Jonasjcmh/Star_nose_sensor/paper_plan.docx

Star-Nose Capacitive Tactile Sensor

A Bio-inspired Multi-Modal Tactile Sensing Array for Robotic Applications

Scientific Article — Figure & Section Plan

Jonathan Tirado — June 2026

# 1. Article Overview

This document maps the full narrative arc of the paper and specifies content, panels, and data requirements for each of the six main figures. The work is structured to tell a coherent story: from the biological inspiration and device fabrication, through electrical and mechanical characterization, to multi-modal perception and real-world demonstrations.

Core narrative thread

• Biological inspiration: the star-nose mole (Condylura cristata) achieves extraordinary tactile acuity through a 22-appendage nose array with ~25,000 mechanoreceptors packed into 0.92 cm².

• Engineering challenge: replicate the array density, compliance, and multi-modal discrimination of this biological system in a flat, manufacturable capacitive skin.

• Solution: a 252-electrode capacitive array (19 active cells used here) covered by interchangeable elastomeric domes, read by a microcontroller and interpreted by ML classifiers/regressors.

• Demonstration: real-time multi-touch, sliding speed, shape class, contact depth, and rotation are detected simultaneously; the sensor adapts to curved surfaces.

# 2. Proposed Title & Abstract Keywords

Working title:

“Star-Nose Inspired Capacitive Tactile Sensor with Multi-Modal Perception and Shape Adaptability”

Target keywords:

• capacitive tactile sensor • bio-inspired • star-nose mole • multi-modal sensing • shape recognition • contact depth estimation • soft robotics • elastic dome • machine learning tactile

# 3. Suggested Paper Structure

Section | Title | Key points
Abstract | ~250 words | Bioinspiration hook, device specs, detection capabilities, demo result
1. Introduction | ~600 words | Star-nose mole biology; gap in tactile sensing; paper contributions (3–4 bullet points)
2. Design & Fabrication | ~400 words + Fig 1 | PCB layout, electrode geometry, dome materials, assembly process
3. Electrical Characterization | ~400 words + Fig 2 | Baseline, sensitivity, SNR, cross-talk, drift, signal chain
4. Mechanical Characterization | ~400 words + Fig 3 | Dome force–displacement curves, stiffness comparison, adaptation
5. Touch & Multi-Touch Detection | ~500 words + Fig 4 | Contact classification, position estimation, multi-touch isolation
6. Multi-Modal Perception | ~600 words + Fig 5 | Speed, shape, depth, rotation — ML architecture & results
7. Adaptability Demo | ~400 words + Fig 6 | Curved-surface mounting, environmental conditions
8. Discussion | ~400 words | Comparison to SOTA, limitations, scaling path
9. Conclusion | ~150 words | Summary and outlook

# 4. Figure Plans

Each figure is described below with: narrative purpose, panel list, bioinspiration connection, data already available in the repository, and what still needs to be collected or generated.

Figure 1: Design and Fabrication of the Sensor
Purpose | Introduce the device physically and connect it to its biological model. This figure anchors the entire paper.

Panels

(a) Photo/illustration of the star-nose mole with a close-up of the Eimer's organs arrangement on one appendage.

(b) Annotated photograph of the full 252-electrode PCB skin, highlighting the 19 active cells in the hexagonal diamond grid (∸38 mm diameter).

(c) Schematic cross-section showing PCB layer stack → elastomeric dome → object contact; indicate electrode pitch (8 mm col, 7 mm row).

(d) Exploded-view diagram of the assembly: PCB, spacer/frame, dome variants (empty, solid, curved), protective cover.

(e) Photograph or render of the sensor mounted on the UR5 TCP, showing the full system (robot arm + F/T sensor + skin).

(f) Table inset: key fabrication parameters (electrode count, active cells, diameter, serial rate, frame rate, robot specs).
Bioinspiration | Direct parallel between the 22 appendages / Eimer's organ arrangement of Condylura cristata and the hexagonal electrode array layout; both prioritize spatial coverage with high density in a compact area.
Data ready | PCB design files present; UR5 integration code complete; hexmap coordinate figure referenced in report (Fig 1 of report).
Still needed | High-resolution photographs of the bare PCB and assembled sensor needed; biological illustration or CC-licensed image of star-nose mole; clean exploded-view render (CAD or Inkscape).

Figure 2: Electrical Characterization of the Capacitive Sensors
Purpose | Quantify sensor performance: sensitivity, noise floor, SNR, cross-talk, drift, and the effect of the signal processing chain.

Panels

(a) Raw capacitance trace for a representative single-press event on one electrode (force vs. capacitance dual-axis, from loadcell_vs_robot.png data).

(b) Baseline distribution across all 19 cells in idle state — histogram showing the ∲32% idle offset problem and after multi-frame calibration fix.

(c) SNR map: heatmap on the hexagonal grid showing per-cell SNR (before and after dead-zone + EMA filtering).

(d) Cross-talk matrix: 19×19 heatmap of Pearson correlation between all cell pairs during single-point presses.

(e) Signal chain block diagram: raw → multi-frame calib → normalise → gamma → spike rejection → dead-zone → EMA; annotate parameters (SENSITIVITY=30, GAMMA=0.5, alpha=0.35).

(f) Frequency spectrum or frame-rate stability plot showing the 16 Hz acquisition rate and spike artefact distribution (1.2% flagged frames).
Bioinspiration | The star-nose mole Eimer's organs are tonotopically organised with graded sensitivity across appendages; analogously, the spatial SNR variation across the electrode array mirrors biological sensitivity gradients.
Data ready | Raw session CSVs available; per-point plots, force.png, analog.png, loadcell_vs_robot.png already generated; noise analysis described in Section 4 of report.
Still needed | Cross-talk matrix computation script; baseline before/after comparison requires implementing multi-frame calibration (new branch recommended per report); EMA filter effect plot.

Figure 3: Mechanical Characterization of Dome Variants
Purpose | Show how the choice of dome geometry/material modulates tactile response, sensitivity, and contact area spreading.

Panels

(a) Photographs of the three dome types: empty dome, solid (filled) dome, curved-surface adapter; include scale bar.

(b) Force–displacement curves for each dome type at the center electrode (point 10) — overlay three curves to show stiffness differences.

(c) Contact area (number of active cells, n_active) vs. indentation depth for each dome: solid dome spreads contact wider.

(d) Hexagonal activation maps at matched force levels (e.g., 0.5 N) for each dome type — 3 side-by-side hexmaps.

(e) Peak capacitance vs. depth regression per dome variant (from per_point.pdf / perpoint.png data).

(f) Spatial deviation map for the empty dome vs. solid dome (deviation_map.png and deviation_map_short_6mm.png already in repo).
Bioinspiration | The star-nose mole modulates sensitivity by controlling how much tissue presses against Eimer's organs; the dome acts as the compliant coupling layer, analogously enabling tunable sensitivity without changing the underlying electronics.
Data ready | deviation_map.png, deviation_map_short_6mm.png, per-session perpoint.png and force.png plots; empty dome and solid dome session logs; curved surface logs (test_curved sessions).
Still needed | Systematic force–displacement curves per dome (requires load cell + robot press at calibrated depths across dome types); material characterization (Shore hardness or Young's modulus) of dome elastomer.

Figure 4: Touch and Multi-Touch Detection
Purpose | Demonstrate the sensor's ability to localise single contacts and resolve simultaneous multi-point touches across the array.

Panels

(a) Single-touch position accuracy: scatter plot of predicted (x,y) vs. ground-truth TCP positions across all 19 canonical points; colour-code by depth.

(b) MAE heatmap on the hexagonal grid — show per-cell localisation error to identify edge/center performance difference.

(c) Time traces of all 19 cells during a sequential 5-point press routine; annotate contact onset/offset.

(d) Multi-touch demonstration: simultaneous activation of 2–3 non-adjacent cells (manually or with dual-probe setup); hexmap sequence.

(e) Confusion matrix for the contact classifier (19 classes, from current RF model) on held-out test set.

(f) Depth estimation performance: predicted depth vs. actual depth (0.5–3.0 mm) — scatter + regression line + MAE annotation (≈0.3–0.5 mm).
Bioinspiration | The star-nose mole can detect and independently process touches on different appendages simultaneously; the multi-touch isolation capability of the array directly mirrors this parallel spatial processing.
Data ready | 28,000 labelled frames from ~28 sessions; trained RF classifiers for contact (19 classes), position, depth; hexmap plots; overview.png; session CSVs with ur5_point labels.
Still needed | Multi-touch ground-truth data (two simultaneous presses at known positions — requires mechanical two-probe fixture or manual protocol); held-out test split performance table.

Figure 5: Multi-Modal Perception: Speed, Shape, Depth, and Rotation
Purpose | This is the centrepiece results figure. Demonstrate that a single sensor simultaneously provides four distinct tactile modalities using ML over the second-order moment feature vector.

Panels

(a) Feature engineering diagram: show how 19 raw cell values + 4 spatial scalars are extended to 30 features via Ixx, Iyy, Ixy, theta, eccentricity, delta_cx, delta_cy.

(b) Sliding speed estimation: sensor output during linear UR5 trajectories at 1, 2, 4 mm/s; plot centroid velocity vs. actual speed with regression line.

(c) Shape classification: confusion matrix for sphere / flat disk / cylinder / edge / ring classification; include representative hexmap for each class.

(d) Depth regression: predicted vs. actual depth (same as Fig 4f but here shown as part of the multi-task ML system); highlight improved accuracy with moment features.

(e) Rotation estimation: polar plot of predicted angle vs. true TCP roll angle (0–157.5° in 8 steps); show cos(2θ)/sin(2θ) decoding approach.

(f) Multi-task output dashboard: a single time window showing all four outputs (speed, shape label, depth, angle) updating simultaneously during a scripted demo trajectory.
Bioinspiration | The star-nose mole processes each appendage's input through a dedicated cortical barrel, enabling simultaneous multi-modal integration; the shared feature vector fed to parallel ML heads directly mirrors this parallel cortical architecture.
Data ready | Depth regression model trained; position regressor trained; moment feature engineering described in Section 2.1 of report; ML roadmap documented.
Still needed | Shape classification dataset (Protocol C: 4 probe geometries × 10 pts × 2 depths × 3 reps = 240 events); rotation dataset (Protocol B: 8 angles × 10 pts × 2 depths × 3 reps = 480 events); sliding trajectory sequences at multiple speeds; multi-task MLP training.

Figure 6: Shape Adaptability and Environmental Detection Demo
Purpose | Close the paper with a compelling demonstration showing the sensor conforming to non-flat surfaces and functioning under varying environmental conditions.

Panels

(a) Photograph montage: sensor mounted flat on UR5 vs. sensor mounted on a curved surface (e.g., cylindrical object or mannequin finger); show that dome deforms to fill the gap.

(b) Tactile maps from curved-surface sessions vs. flat sessions at matched contact forces — hexmap comparison showing maintained spatial resolution.

(c) Position estimation accuracy comparison: flat surface MAE vs. curved surface MAE across 19 points — bar chart showing performance retention.

(d) Environmental robustness: capacitance drift over time and temperature variation; show that periodic re-calibration (every 10 min) restores baseline (from best practices in Section 3.4 of report).

(e) Robot-guided surface exploration sequence: 6-panel strip of hexmaps during a scripted scan across a curved object, with contact position overlaid on a 3D robot path.

(f) Summary table: sensor performance across all four modalities and two surface conditions — final quantitative comparison with relevant literature (2–3 SOTA sensors).
Bioinspiration | The star-nose mole uses its radially symmetric appendage array to rapidly scan surfaces of arbitrary shape; the dome-coupled capacitive skin mimics this by conforming to geometry without recalibration, enabling exploration analogous to the mole's foveation behaviour.
Data ready | test_curved session logs (2 sessions, ~2900 frames); curved-surface hexmap plots; deviation map for 6mm dome.
Still needed | Additional curved-surface sessions at varied curvature radii; temperature-drift characterisation experiment; literature comparison table (GelSight, iCub skin, BioTac, etc.); high-quality photos of mounting on curved objects.

# 5. Data & Experiment Gap Summary

The following experiments are required before submission. Priority order follows the figure sequence.

High priority (Figures 1–4 — fabrication photos + characterisation)

• High-resolution photos of bare PCB, assembled sensor (all dome variants), and UR5 mounting.

• Systematic force–displacement curves per dome type (empty, solid, curved) using load cell + UR5.

• Multi-frame calibration implementation (new branch) + before/after SNR comparison.

• Cross-talk measurement: single-point presses while recording all 19 channels.

• Multi-touch fixture or manual two-probe protocol for simultaneous contact ground truth.

Medium priority (Figure 5 — multi-modal ML)

• Protocol B data collection: rotation presses (8 angles × 10 pts × 2 depths × 3 reps = 480 events).

• Protocol C data collection: shape presses (4 shapes × 10 pts × 2 depths × 3 reps = 240 events).

• Sliding trajectory sessions at 3 speeds (1, 2, 4 mm/s) over 6 linear paths.

• Moment feature engineering in build_dataset.py (Ixx, Iyy, Ixy, theta, eccentricity).

• Train shape classifier (RF 300 trees), rotation regressor (MLP 256→128), and optional multi-task MLP.

Lower priority (Figure 6 — demo & comparison)

• Additional curved-surface sessions at 2–3 curvature radii.

• Temperature drift characterisation (~1 h acquisition with ambient temperature logged).

• Literature review and comparison table (GelSight, BioTac, iCub skin, FingerVision).

# 6. Suggested Target Venues

Venue | Type | Fit
IEEE Sensors Journal | Journal | Sensor characterisation focus; accepts multi-figure hardware papers
Advanced Intelligent Systems (Wiley) | Journal | Bio-inspired robotics + ML — strong fit for this work
IEEE RA-L + IROS/ICRA | Journal + Conference | Robotics community; tactile sensing for manipulation
Soft Robotics (Mary Ann Liebert) | Journal | If dome compliance and adaptability are emphasised
IEEE WorldHaptics / EuroHaptics | Conference | Haptic/tactile sensing community; demo-friendly

End of Plan — Star-Nose Capacitive Sensor Paper

Star-Nose Capacitive Sensor — Paper Plan
