Jonasjcmh/Star_nose_sensor/abstract_draft.docx

Star-Nose Inspired Capacitive Tactile Sensor with Multi-Modal Perception and Shape Adaptability

## Abstract

## Tailored Abstract (Science Robotics style)

Animals achieve rich tactile perception by coupling dense mechanoreception with morphology that transforms contact into informative spatial patterns. The star-nosed mole (Condylura cristata), for example, resolves object features with exceptional speed using tens of thousands of mechanoreceptors distributed across structured appendages. In contrast, most engineered tactile arrays report a single scalar signal per taxel, limiting their ability to infer contact geometry from a single interaction.

Here, we present a bio-inspired capacitive tactile sensor that encodes contact shape and displacement features through structured dome surfaces and spatial signal processing. The device comprises a 5x5 electrode array with 19 active sensing cells arranged in a hexagonal diamond layout, coupled to elastomeric domes that modulate sensitivity and enable conformal deployment on irregular surfaces. To enable space recognition learning, the sensor is integrated with a robotic manipulator that provides precise variations of pose and force during automated data acquisition.

We extract per-contact descriptors by combining cell-wise capacitance readings with second-order spatial moments ( I_(xx) , I_(yy) , I_(xy) ), yielding a compact representation of contact geometry. Across a dataset of more than 28,000 robot-acquired interactions spanning multiple surface and dome configurations, standard learning models decode indentation depth, contact location, object shape, and in-plane rotation from a single sensor array. The system resolves indentation depth at sub-millimetre scale and maintains performance under conformal mounting.

These results demonstrate that augmenting capacitive arrays with conformal structures and data driven decoding enables an enhanced tactile perception without increasing sensor density. This approach provides a compact pathway toward shape adaptable tactile sensing for robotic manipulation and navigation.

## Tailored Introduction (Science Robotics style)

Dexterous manipulation requires robots to infer contact geometry, force distribution, and object properties under conditions where vision is uncertain or occluded [cite]. Among the available tactile sensing technologies, capacitive arrays remain especially attractive because they are compact, sensitive, scalable, and well suited to integration in soft robotic field [cite]. Their simple transduction principle also makes them robust and practical for distributed implementations, supporting high-density tactile acquisition in lightweight formats [cite].

Rather than increasing the sensing burden of each cell, an alternative strategy is to preserve the simplicity of capacitive transduction while enriching the information carried by the resulting signals through mechanical design and computational interpretation. This perspective is consistent with biological tactile systems, where morphology often plays an active role in shaping how contact stimuli are encoded before neural processing [cite]. The star-nosed mole (Condylura cristata), for example, achieves remarkable tactile performance through a highly structured sensory surface that transforms brief contact into informative spatial patterns [cite].

We follow this principle using a capacitive tactile array in which each sensing element is paired with a hollow elastomeric dome. The dome does not introduce an additional electrical sensing channel; instead, it acts as a mechanically intelligent interface that modifies the local contact mechanics before transduction. This design improves conformability on curved or irregular surfaces and helps preserve meaningful local interactions in situations where flat interfaces may lose coupling or allow larger surface features to dominate smaller ones.

In this way, the contribution of the dome is not to make each capacitive cell intrinsically multimodal, but to reshape the contact so that a single scalar measurement becomes more informative. The hollow dome can damp, localize, and redistribute deformation depending on the geometry and dynamics of the interaction, thereby making capacitance changes more sensitive to indentation profile, partial contact, and local surface variation. When these local responses are considered across the array and over time, they form a richer spatiotemporal representation than would be available from the raw scalar values alone.

This system-level view is central to the approach presented here. Although each cell outputs only one capacitive measurement, the combination of dome-mediated mechanics, spatial organization, and temporal signal processing enables the array to support inference of multiple tactile attributes from the same sensing modality. These attributes include not only contact location and indentation depth, but also shape-dependent responses and dynamic features such as shear, frictional interaction, and displacement speed. The goal is therefore not to replace capacitive sensing with a more complex transduction scheme, but to extend what can be extracted from capacitive arrays through morphology-aware design and decoding.

Building on this idea, this work presents a bio-inspired capacitive tactile sensor integrated with dome structures and an automated robotic data-collection framework. By coupling conformable mechanical interfaces with structured feature extraction and machine-learning-based interpretation, the proposed system seeks to expand the functional repertoire of compact capacitive arrays beyond conventional contact detection. More broadly, it explores how mechanically informed sensor design can help bridge the gap between simple tactile transduction and richer robotic touch perception.

## Old version

Dexterous manipulation requires robots to infer contact geometry, force distribution, and object properties under conditions where vision is uncertain or occluded. While tactile sensor arrays have advanced substantially in spatial resolution and sensitivity, most designs remain functionally limited: each taxel reports a single scalar quantity, typically pressure, constraining the information that can be recovered from a single event. As a result, higher-level properties such as object shape, orientation, and motion are often inferred only through sequential exploration or sensor fusion.

Biological tactile systems suggest an alternative design principle. Rather than relying solely on receptor density, they exploit the coupling between morphology and sensing to encode rich information in spatial activation patterns. The star-nosed mole (Condylura cristata) provides a striking example, using an array of mechanosensory appendages densely packed with Eimer’s organs to achieve rapid and precise tactile discrimination (Catania, 2011). Critically, the geometry and նյութ properties of these appendages transform contact interactions into structured signals that can be decoded efficiently by the nervous system. This observation motivates the hypothesis that morphological encoding—paired with appropriate decoding—can increase the functional bandwidth of engineered tactile sensors without requiring denser arrays.

Recent work in robotic touch has begun to explore this direction. Soft interfaces and structured skins can transform contact geometry into distributed signals across an array, enabling inference of shape and force vectors (Dahiya et al., 2010; Lepora and Ward-Cherrier, 2015). Vision-based tactile sensors such as GelSight achieve high-resolution reconstruction of surface geometry, but at the cost of increased complexity, bulk, and power requirements (Yuan et al., 2017). Capacitive sensors, by contrast, offer a compact and scalable alternative but typically lack mechanisms to encode higher-order features within a single संपर्क.

In parallel, machine learning has emerged as a powerful tool for interpreting tactile data, enabling inference of object properties from high-dimensional sensor signals (Calandra et al., 2017). However, progress is often limited by the availability of large, well-annotated datasets. Robotic platforms equipped with precise force and pose sensing provide a means to automate data collection and generate consistent ground truth, reducing reliance on manual labeling and enabling systematic exploration of sensor behavior.

Here, we introduce a bio-inspired capacitive tactile sensing system that integrates three key elements: (i) structured electrode geometry, (ii) interchangeable elastomeric domes that mechanically encode contact, and (iii) automated, robot-assisted data acquisition for scalable learning. By combining spatially distributed capacitance measurements with second-order moment features, the system captures compact descriptors of contact geometry that support multi-modal inference from a single interaction. We demonstrate that this approach enables simultaneous estimation of indentation depth, contact location, object shape, and orientation, while preserving performance under conformal mounting on curved surfaces.

This work advances tactile sensing by showing that morphology-aware encoding can substantially expand the information content of capacitive arrays without increasing sensor density. More broadly, it highlights a pathway toward compact, adaptable tactile systems that bridge principles from biological sensing and robotic manipulation.

Keywords: capacitive tactile sensor, bio-inspired, star-nose mole, multi-modal sensing, shape recognition, contact depth estimation, soft robotics, elastic dome, machine learning tactile
