Jonasjcmh/Star_nose_sensor/Capacitance_measurement/plots2/overview.png

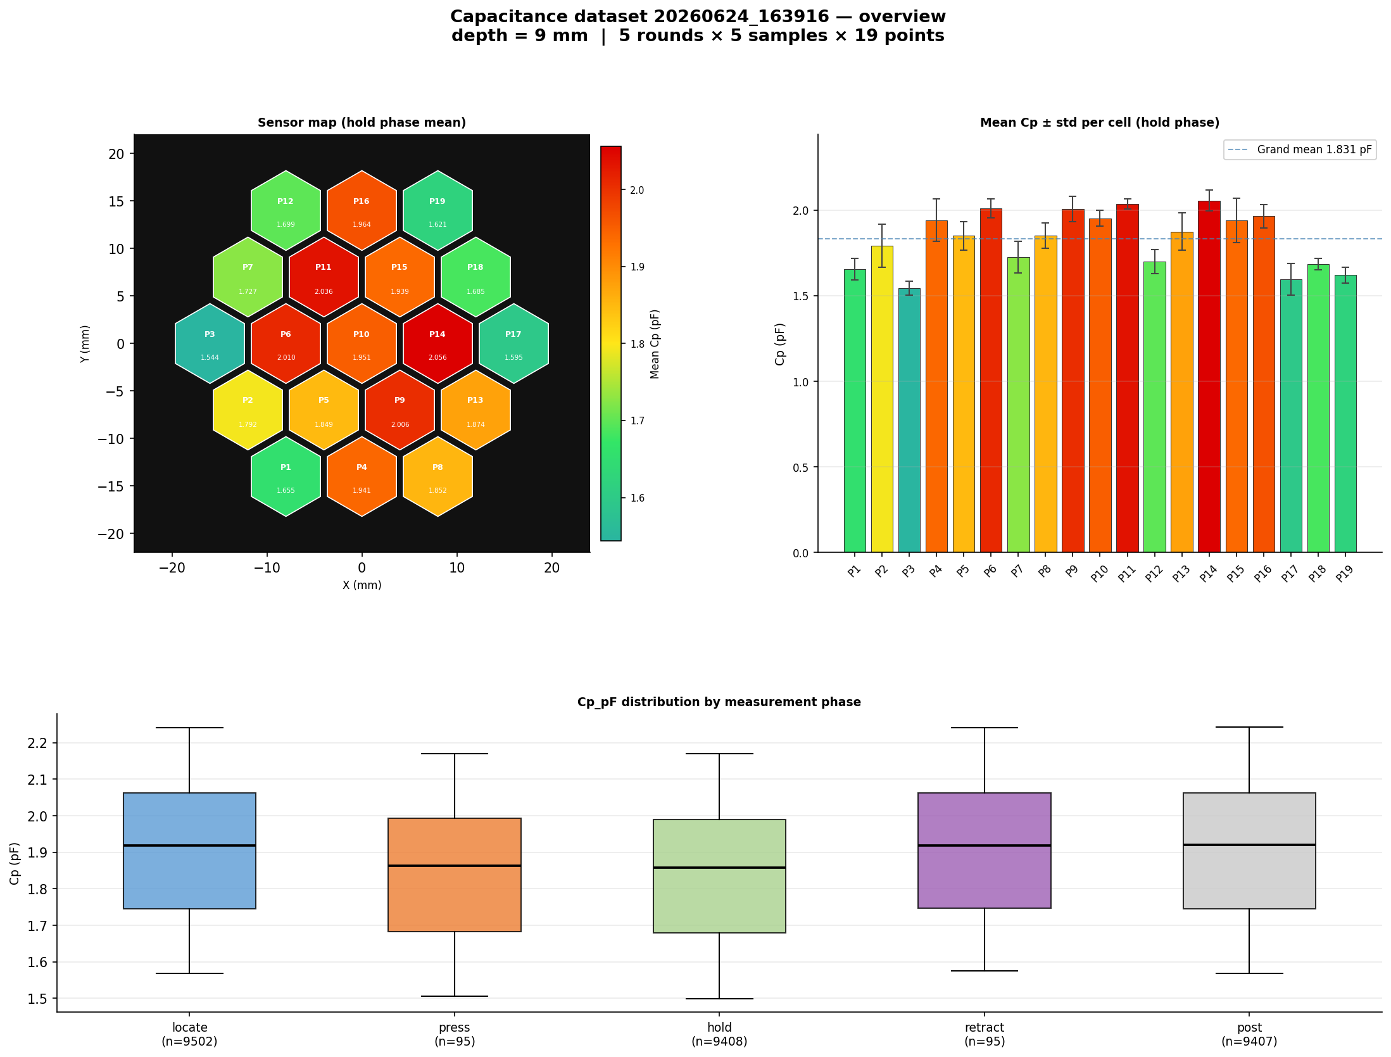
Capacitance_measurement/plots2/overview.png
