Jonasjcmh/Star_nose_sensor/Integration/plots/dome_empty_monday_2_session_20260511_134351/overview.png

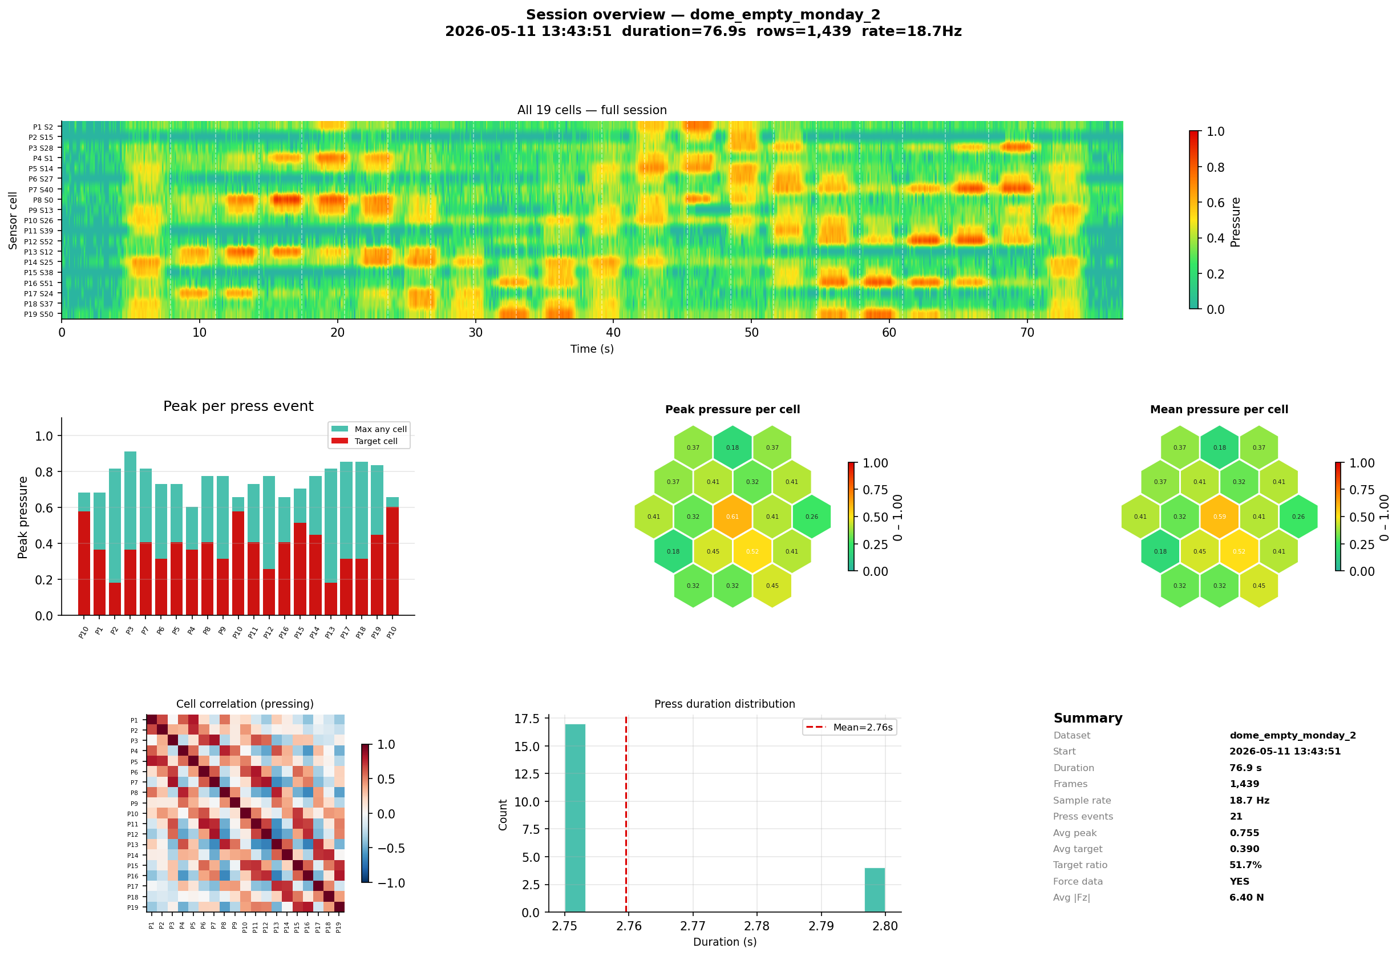
Integration/plots/dome_empty_monday_2_session_20260511_134351/overview.png
