Jonasjcmh/Star_nose_sensor/Capacitance_calibration_Muca_LCR_Futek/results/stepA_vs_stepB_sanity_check.png

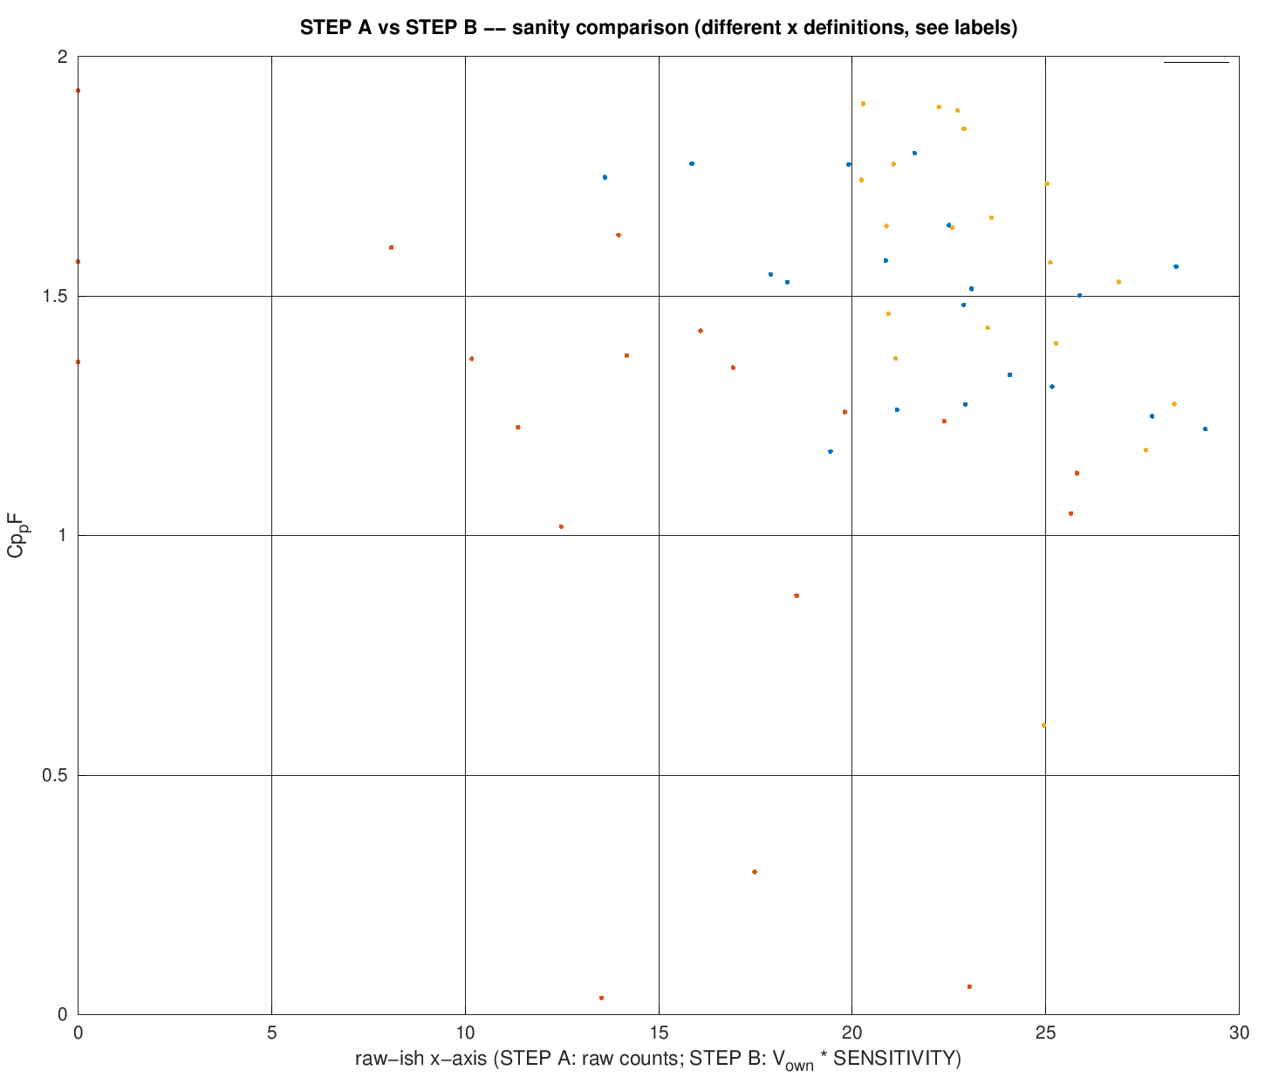
Capacitance_calibration_Muca_LCR_Futek/results/stepA_vs_stepB_sanity_check.png
