Jonasjcmh/Star_nose_sensor/fig1_design_fabrication.png

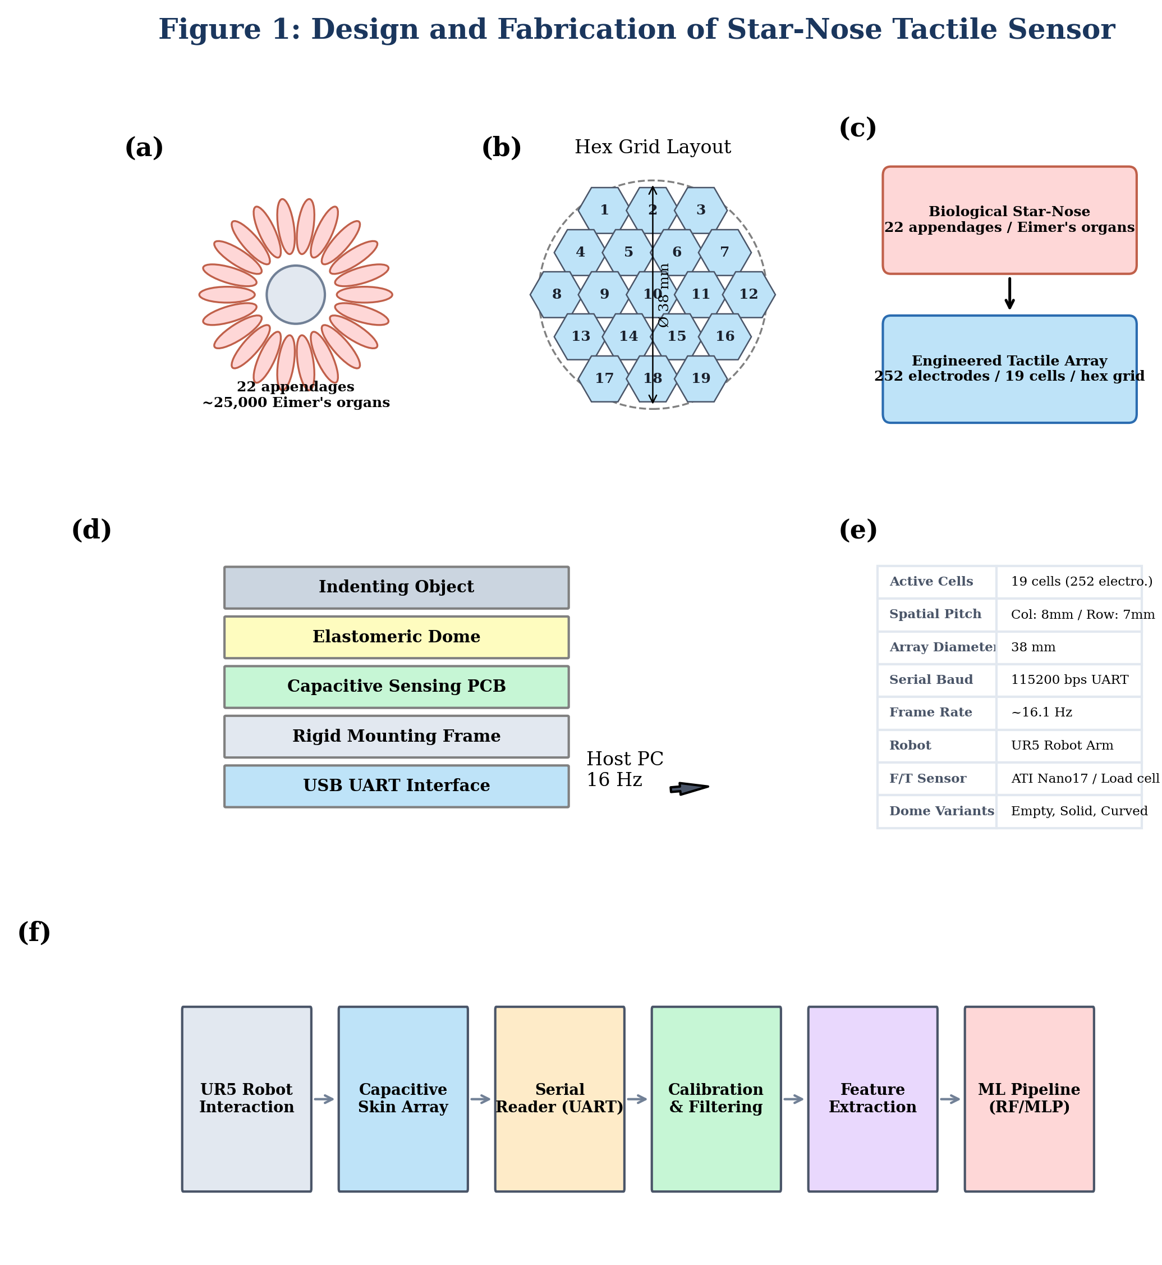
fig1_design_fabrication.png
