Jonasjcmh/Star_nose_sensor/force_sensor_calibration/Matlab calibration/step2_panel_overview.png

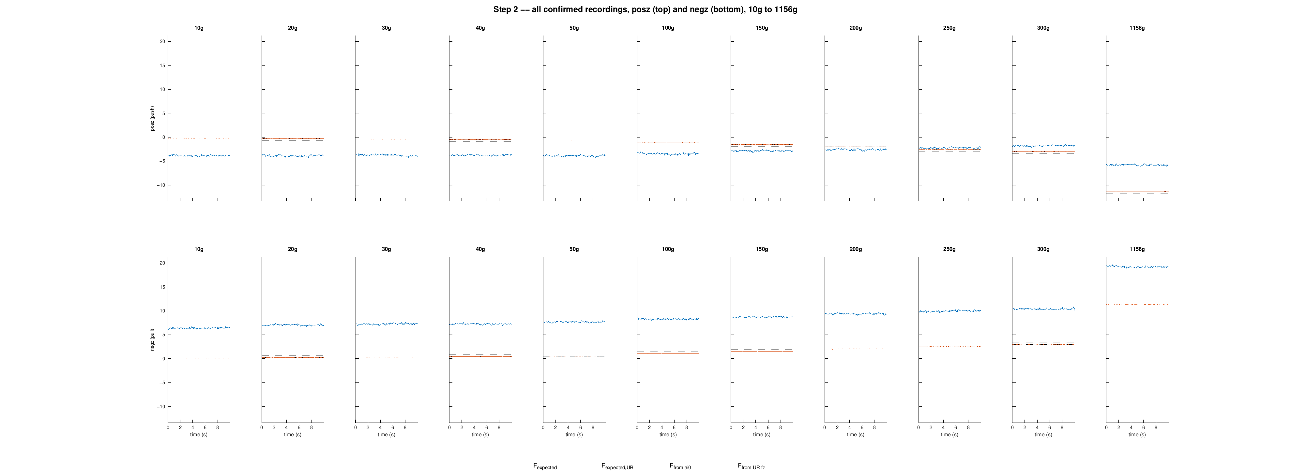
force_sensor_calibration/Matlab calibration/step2_panel_overview.png
