Jonasjcmh/Star_nose_sensor/force_sensor_calibration/Matlab calibration/step2_plots/fzcal_futek_direct_20g_v2_20260715_155952_step2.png

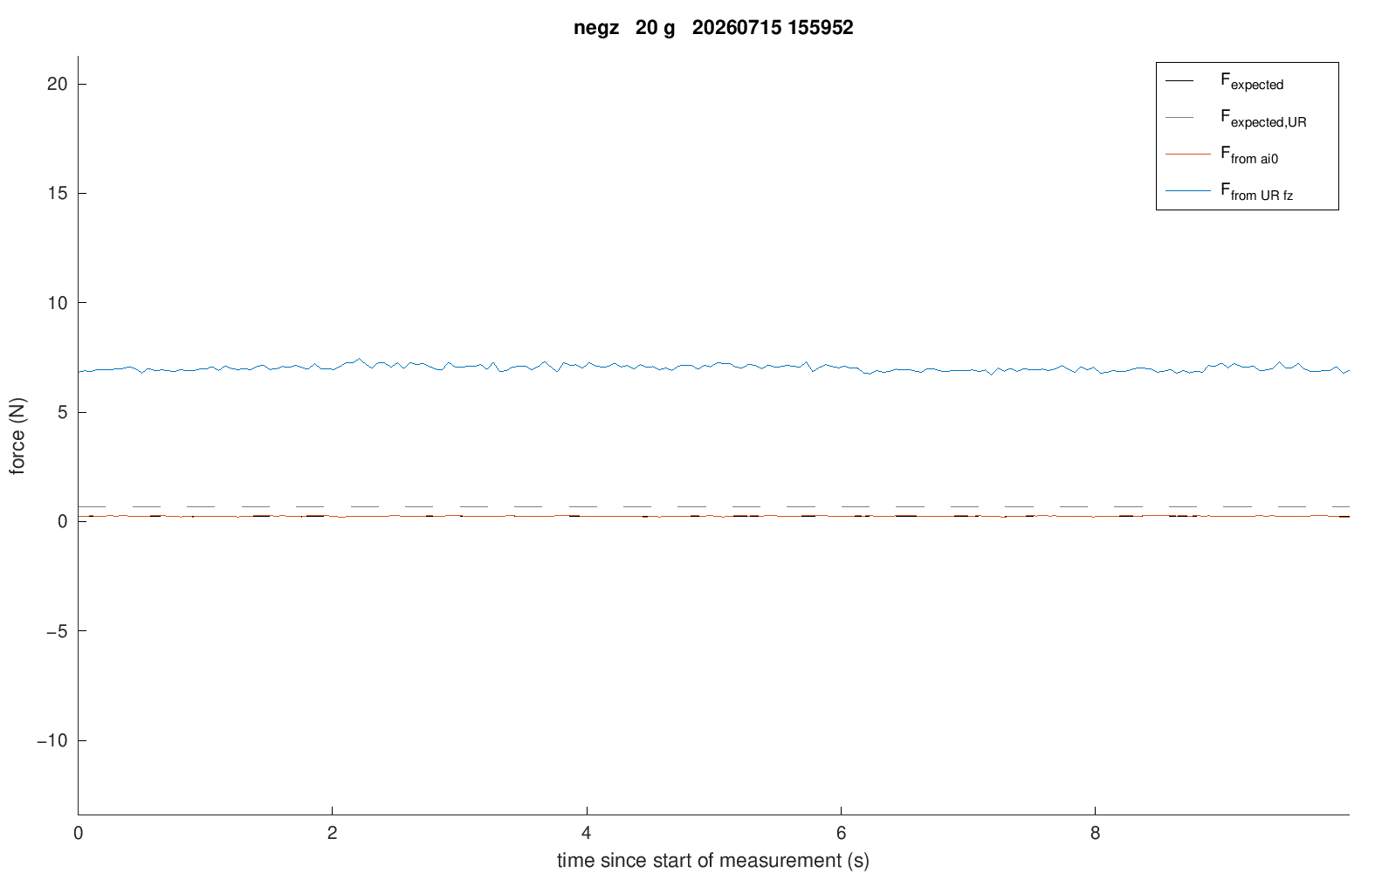
force_sensor_calibration/Matlab calibration/step2_plots/fzcal_futek_direct_20g_v2_20260715_155952_step2.png
