Jonasjcmh/Star_nose_sensor/force_sensor_calibration/Matlab calibration/step2_plots/fzcal_futek_direct_150g_v2_20260715_160752_step2.png

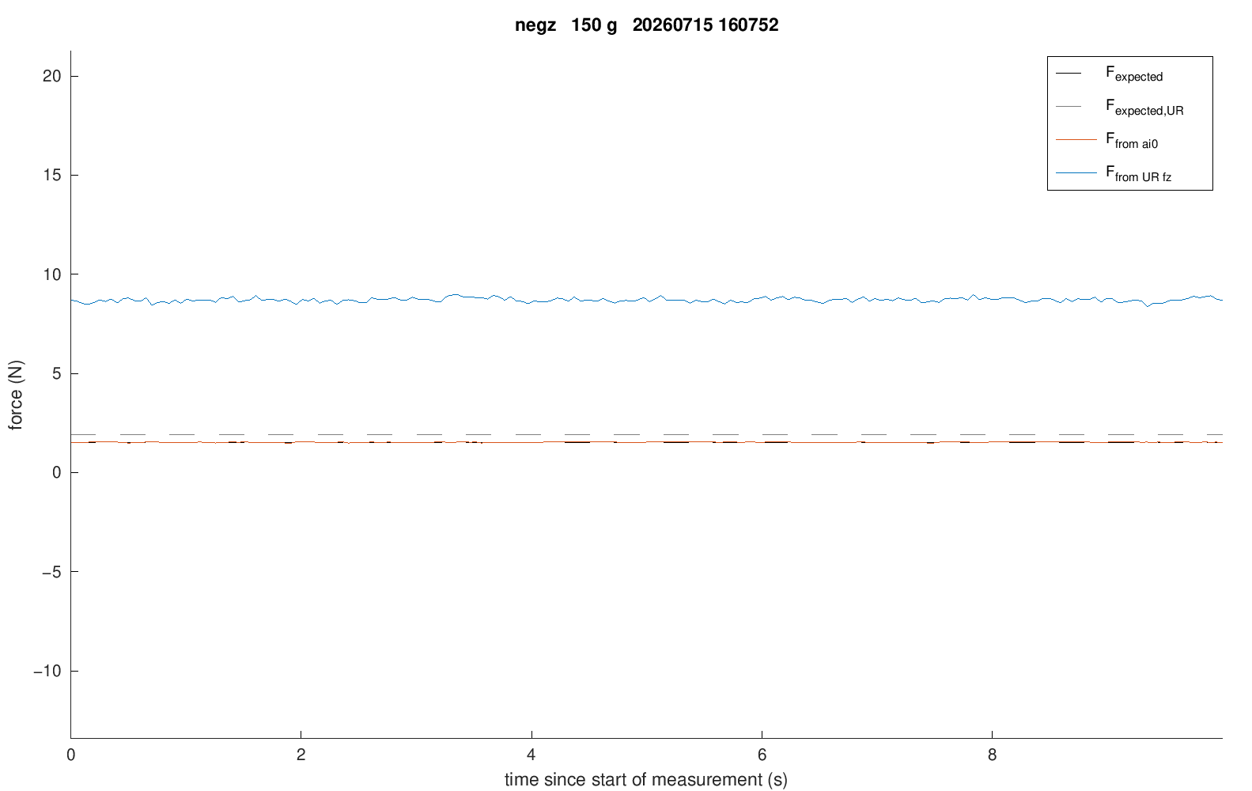
force_sensor_calibration/Matlab calibration/step2_plots/fzcal_futek_direct_150g_v2_20260715_160752_step2.png
