Jonasjcmh/Star_nose_sensor/Capacitance_calibration_Muca_LCR_Futek/results/muca_v_to_cp_table.md

# muca reading <-> real capacitance (Cp, pF), per point, per surface

`Cp_pF = A * V_own + B`, where V_own is the mucaboard's own normalized [0,1] reading for that point (see mucaboard_data/README_capacitance_estimation.md section 1 for how a raw count becomes V_own). Composed from two per-point fits chained through Force (see chained_muca_v_to_cp_via_force.m): mucaboard_data_raw's own press/retract ramp gives Force<->V; Capacitance_measurement's LCR sweep gives Force<->Cp_pF. `R2 (weakest link)` is the MINIMUM of the two chained fits' own R2 -- the honest quality figure for the composed equation, since a chain is only as strong as its weakest link.

## FLAT

| point | code_id | Cp_pF = A*V + B | A (slope) | B (intercept) | R2 (weakest link) |
|---|---|---|---|---|---|
| P01 | 8 | Cp_pF = -0.0922*V + 1.5389 | -0.0922 | 1.5389 | 0.848 |
| P02 | 4 | Cp_pF = -0.2078*V + 1.6486 | -0.2078 | 1.6486 | 0.818 |
| P03 | 1 | Cp_pF = -0.2110*V + 1.3919 | -0.2110 | 1.3919 | 0.837 |
| P04 | 13 | Cp_pF = -0.1611*V + 1.8933 | -0.1611 | 1.8933 | 0.824 |
| P05 | 9 | Cp_pF = -0.2946*V + 1.9353 | -0.2946 | 1.9353 | 0.773 |
| P06 | 5 | Cp_pF = -0.1938*V + 1.7116 | -0.1938 | 1.7116 | 0.847 |
| P07 | 2 | Cp_pF = -0.2335*V + 1.4900 | -0.2335 | 1.4900 | 0.808 |
| P08 | 17 | Cp_pF = -0.1126*V + 1.6382 | -0.1126 | 1.6382 | 0.753 |
| P09 | 14 | Cp_pF = -0.2236*V + 1.8724 | -0.2236 | 1.8724 | 0.681 |
| P10 | 10 | Cp_pF = -0.2887*V + 1.8538 | -0.2887 | 1.8538 | 0.550 |
| P11 | 6 | Cp_pF = -0.2494*V + 1.6671 | -0.2494 | 1.6671 | 0.631 |
| P12 | 3 | Cp_pF = -0.1128*V + 1.3267 | -0.1128 | 1.3267 | 0.777 |
| P13 | 18 | Cp_pF = -0.2440*V + 1.6694 | -0.2440 | 1.6694 | 0.833 |
| P14 | 15 | Cp_pF = -0.2609*V + 1.8084 | -0.2609 | 1.8084 | 0.828 |
| P15 | 11 | Cp_pF = -0.3546*V + 1.7074 | -0.3546 | 1.7074 | 0.675 |
| P16 | 7 | Cp_pF = -0.1409*V + 1.3614 | -0.1409 | 1.3614 | 0.816 |
| P17 | 19 | Cp_pF = -0.1515*V + 1.3642 | -0.1515 | 1.3642 | 0.859 |
| P18 | 16 | Cp_pF = -0.1461*V + 1.4119 | -0.1461 | 1.4119 | 0.849 |
| P19 | 12 | Cp_pF = -0.1282*V + 1.2430 | -0.1282 | 1.2430 | 0.773 |

## SOLID

| point | code_id | Cp_pF = A*V + B | A (slope) | B (intercept) | R2 (weakest link) |
|---|---|---|---|---|---|
| P01 | 8 | Cp_pF = -0.1969*V + 1.2861 | -0.1969 | 1.2861 | 0.352 |
| P02 | 4 | Cp_pF = -0.1556*V + 1.1566 | -0.1556 | 1.1566 | 0.843 |
| P03 | 1 | Cp_pF = -0.1349*V + 1.2266 | -0.1349 | 1.2266 | 0.836 |
| P04 | 13 | Cp_pF = 0.2778*V + 1.9263 | 0.2778 | 1.9263 | 0.262 |
| P05 | 9 | Cp_pF = -0.1873*V + 1.5115 | -0.1873 | 1.5115 | 0.659 |
| P06 | 5 | Cp_pF = -0.1595*V + 1.4389 | -0.1595 | 1.4389 | 0.732 |
| P07 | 2 | Cp_pF = -0.1556*V + 1.3346 | -0.1556 | 1.3346 | 0.783 |
| P08 | 17 | Cp_pF = -0.0529*V + 0.0545 | -0.0529 | 0.0545 | 0.767 |
| P09 | 14 | Cp_pF = 0.3822*V + 1.5645 | 0.3822 | 1.5645 | 0.159 |
| P10 | 10 | Cp_pF = -0.3449*V + 1.6749 | -0.3449 | 1.6749 | 0.164 |
| P11 | 6 | Cp_pF = -0.1768*V + 1.6957 | -0.1768 | 1.6957 | 0.641 |
| P12 | 3 | Cp_pF = -0.0988*V + 1.3117 | -0.0988 | 1.3117 | 0.774 |
| P13 | 18 | Cp_pF = -0.0632*V + 0.3286 | -0.0632 | 0.3286 | 0.608 |
| P14 | 15 | Cp_pF = 0.1713*V + 1.3595 | 0.1713 | 1.3595 | 0.363 |
| P15 | 11 | Cp_pF = -0.2893*V + 1.4482 | -0.2893 | 1.4482 | 0.322 |
| P16 | 7 | Cp_pF = -0.2436*V + 1.1028 | -0.2436 | 1.1028 | 0.366 |
| P17 | 19 | Cp_pF = -0.0674*V + 0.1008 | -0.0674 | 0.1008 | 0.812 |
| P18 | 16 | Cp_pF = -0.2394*V + 0.9975 | -0.2394 | 0.9975 | 0.659 |
| P19 | 12 | Cp_pF = -0.1349*V + 1.4131 | -0.1349 | 1.4131 | 0.707 |

## HOLLOW

| point | code_id | Cp_pF = A*V + B | A (slope) | B (intercept) | R2 (weakest link) |
|---|---|---|---|---|---|
| P01 | 8 | Cp_pF = -0.1324*V + 1.8523 | -0.1324 | 1.8523 | 0.828 |
| P02 | 4 | Cp_pF = -0.1095*V + 1.7111 | -0.1095 | 1.7111 | 0.779 |
| P03 | 1 | Cp_pF = -0.1300*V + 1.3780 | -0.1300 | 1.3780 | 0.757 |
| P04 | 13 | Cp_pF = -0.1859*V + 1.9677 | -0.1859 | 1.9677 | 0.780 |
| P05 | 9 | Cp_pF = -0.2118*V + 2.0267 | -0.2118 | 2.0267 | 0.857 |
| P06 | 5 | Cp_pF = -0.2450*V + 1.9068 | -0.2450 | 1.9068 | 0.851 |
| P07 | 2 | Cp_pF = -0.0754*V + 0.6569 | -0.0754 | 0.6569 | 0.755 |
| P08 | 17 | Cp_pF = -0.1176*V + 1.7124 | -0.1176 | 1.7124 | 0.815 |
| P09 | 14 | Cp_pF = -0.1388*V + 1.9815 | -0.1388 | 1.9815 | 0.840 |
| P10 | 10 | Cp_pF = -0.1511*V + 1.9848 | -0.1511 | 1.9848 | 0.732 |
| P11 | 6 | Cp_pF = -0.1217*V + 1.8115 | -0.1217 | 1.8115 | 0.815 |
| P12 | 3 | Cp_pF = -0.1014*V + 1.5217 | -0.1014 | 1.5217 | 0.825 |
| P13 | 18 | Cp_pF = -0.1387*V + 1.6333 | -0.1387 | 1.6333 | 0.894 |
| P14 | 15 | Cp_pF = -0.2021*V + 1.7998 | -0.2021 | 1.7998 | 0.875 |
| P15 | 11 | Cp_pF = -0.0764*V + 1.4154 | -0.0764 | 1.4154 | 0.855 |
| P16 | 7 | Cp_pF = -0.1505*V + 1.6756 | -0.1505 | 1.6756 | 0.732 |
| P17 | 19 | Cp_pF = -0.1540*V + 1.2958 | -0.1540 | 1.2958 | 0.885 |
| P18 | 16 | Cp_pF = -0.1448*V + 1.5030 | -0.1448 | 1.5030 | 0.863 |
| P19 | 12 | Cp_pF = -0.0941*V + 1.4967 | -0.0941 | 1.4967 | 0.817 |
