Jonasjcmh/Star_nose_sensor/Capacitance_calibration_Muca_LCR_Futek/results/chained_muca_v_to_cp_via_force.md

# Chained muca_V -> Force -> Cp_pF (both links fit per point, from real sweeps)

`Force<->V` is fit HERE, per point, from mucaboard_data_raw's own press+hold+retract phase samples (the robot's continuous 0->10mm ramp gives many (Force,V) pairs per point, not just the single hold-phase mean used everywhere else in this folder). `Force<->Cp_pF` is the per-point fit already computed by per_point_surface_relationships.m (from Capacitance_measurement's real multi-depth LCR sweep, R2 0.97-0.99). `Cp_pF at V=1` and `Cp_pF at V=0` show the chained model's prediction at the extremes of the normalized reading, for a quick sanity read.

## FLAT

| point | code_id | Force<->V fit (from ramp) | R2(F<->V) | n(F<->V) | Force<->Cp_pF fit | R2(F<->Cp) | n(F<->Cp) | Cp_pF at V=0 | Cp_pF at V=1 |
|---|---|---|---|---|---|---|---|---|---|
| P01 | 8 | V = 0.02695*F + 0.0821 | 0.848 | 2000 | Cp_pF = -0.0025*F + 1.5313 | 0.986 | 6 | 1.5389 | 1.4467 |
| P02 | 4 | V = 0.01660*F + 0.3818 | 0.818 | 1998 | Cp_pF = -0.0034*F + 1.5693 | 0.987 | 6 | 1.6486 | 1.4408 |
| P03 | 1 | V = 0.02386*F + 0.3525 | 0.837 | 1998 | Cp_pF = -0.0050*F + 1.3175 | 0.998 | 6 | 1.3919 | 1.1809 |
| P04 | 13 | V = 0.01659*F + 0.2443 | 0.824 | 1998 | Cp_pF = -0.0027*F + 1.8539 | 0.982 | 6 | 1.8933 | 1.7322 |
| P05 | 9 | V = 0.01297*F + 0.2780 | 0.774 | 1997 | Cp_pF = -0.0038*F + 1.8534 | 0.984 | 6 | 1.9353 | 1.6407 |
| P06 | 5 | V = 0.02028*F + 0.3544 | 0.847 | 1998 | Cp_pF = -0.0039*F + 1.6429 | 0.990 | 6 | 1.7116 | 1.5178 |
| P07 | 2 | V = 0.01724*F + 0.3378 | 0.808 | 1998 | Cp_pF = -0.0040*F + 1.4111 | 0.993 | 6 | 1.4900 | 1.2565 |
| P08 | 17 | V = 0.01915*F + 0.1750 | 0.753 | 1997 | Cp_pF = -0.0022*F + 1.6185 | 0.994 | 6 | 1.6382 | 1.5256 |
| P09 | 14 | V = 0.01622*F + 0.0962 | 0.682 | 1998 | Cp_pF = -0.0036*F + 1.8509 | 0.983 | 6 | 1.8724 | 1.6488 |
| P10 | 10 | V = 0.01333*F + 0.1036 | 0.550 | 1997 | Cp_pF = -0.0038*F + 1.8239 | 0.988 | 6 | 1.8538 | 1.5651 |
| P11 | 6 | V = 0.01544*F + 0.1920 | 0.631 | 1998 | Cp_pF = -0.0039*F + 1.6192 | 0.985 | 6 | 1.6671 | 1.4177 |
| P12 | 3 | V = 0.02506*F + 0.1259 | 0.777 | 1999 | Cp_pF = -0.0028*F + 1.3125 | 0.980 | 6 | 1.3267 | 1.2139 |
| P13 | 18 | V = 0.01470*F + 0.3316 | 0.833 | 1997 | Cp_pF = -0.0036*F + 1.5885 | 0.987 | 6 | 1.6694 | 1.4254 |
| P14 | 15 | V = 0.01622*F + 0.2933 | 0.828 | 1998 | Cp_pF = -0.0042*F + 1.7319 | 0.988 | 6 | 1.8084 | 1.5475 |
| P15 | 11 | V = 0.01058*F + 0.2997 | 0.675 | 1996 | Cp_pF = -0.0038*F + 1.6011 | 0.988 | 6 | 1.7074 | 1.3528 |
| P16 | 7 | V = 0.02082*F + 0.2591 | 0.815 | 1999 | Cp_pF = -0.0029*F + 1.3249 | 0.983 | 6 | 1.3614 | 1.2205 |
| P17 | 19 | V = 0.02368*F + 0.2960 | 0.859 | 1998 | Cp_pF = -0.0036*F + 1.3193 | 0.989 | 6 | 1.3642 | 1.2127 |
| P18 | 16 | V = 0.02025*F + 0.3038 | 0.849 | 1996 | Cp_pF = -0.0030*F + 1.3675 | 0.994 | 6 | 1.4119 | 1.2658 |
| P19 | 12 | V = 0.02309*F + 0.1337 | 0.773 | 1997 | Cp_pF = -0.0030*F + 1.2259 | 0.981 | 6 | 1.2430 | 1.1148 |

## SOLID

| point | code_id | Force<->V fit (from ramp) | R2(F<->V) | n(F<->V) | Force<->Cp_pF fit | R2(F<->Cp) | n(F<->Cp) | Cp_pF at V=0 | Cp_pF at V=1 |
|---|---|---|---|---|---|---|---|---|---|
| P01 | 8 | V = 0.02165*F + 0.0784 | 0.352 | 1998 | Cp_pF = -0.0043*F + 1.2707 | 0.987 | 6 | 1.2861 | 1.0892 |
| P02 | 4 | V = 0.03718*F + 0.3186 | 0.843 | 1999 | Cp_pF = -0.0058*F + 1.1071 | 0.995 | 6 | 1.1566 | 1.0010 |
| P03 | 1 | V = 0.04165*F + 0.2900 | 0.836 | 1998 | Cp_pF = -0.0056*F + 1.1875 | 0.985 | 6 | 1.2266 | 1.0917 |
| P04 | 13 | V = -0.01696*F + 0.1611 | 0.262 | 1998 | Cp_pF = -0.0047*F + 1.9710 | 0.969 | 6 | 1.9263 | 2.2041 |
| P05 | 9 | V = 0.03332*F + 0.1247 | 0.660 | 1999 | Cp_pF = -0.0062*F + 1.4881 | 0.995 | 6 | 1.5115 | 1.3242 |
| P06 | 5 | V = 0.03737*F + 0.0081 | 0.732 | 1997 | Cp_pF = -0.0060*F + 1.4377 | 0.996 | 6 | 1.4389 | 1.2794 |
| P07 | 2 | V = 0.03814*F + 0.2318 | 0.783 | 1996 | Cp_pF = -0.0059*F + 1.2985 | 0.982 | 6 | 1.3346 | 1.1790 |
| P08 | 17 | V = 0.03745*F + -0.0067 | 0.768 | 1995 | Cp_pF = -0.0020*F + 0.0548 | 0.970 | 6 | 0.0545 | 0.0016 |
| P09 | 14 | V = -0.01396*F + 0.1491 | 0.159 | 1998 | Cp_pF = -0.0053*F + 1.6215 | 0.986 | 6 | 1.5645 | 1.9467 |
| P10 | 10 | V = 0.01503*F + 0.0720 | 0.164 | 1996 | Cp_pF = -0.0052*F + 1.6501 | 0.934 | 6 | 1.6749 | 1.3300 |
| P11 | 6 | V = 0.03345*F + 0.0716 | 0.641 | 1998 | Cp_pF = -0.0059*F + 1.6831 | 0.983 | 6 | 1.6957 | 1.5189 |
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
| P18 | 16 | V = 0.08258*F + 0.0905 | 0.863 | 1998 | Cp_pF = -0.0120*F + 1.4898 | 0.999 | 6 | 1.5030 | 1.3582 |
| P19 | 12 | V = 0.13522*F + -0.1976 | 0.817 | 1998 | Cp_pF = -0.0127*F + 1.5153 | 0.991 | 6 | 1.4967 | 1.4026 |
