Jonasjcmh/Star_nose_sensor/Capacitance_calibration_Muca_LCR_Futek/results/per_point_surface_relationships.md

# Per-point, per-surface relationships: muca reading <-> LCR Cp_pF <-> Force

Point ids are TRUE board labels (matching the physical board's own numbering, see `mucaboard_data_raw/matlab/simple_19points_analysis.m` for the derivation).

`Force<->Cp_pF` is a REAL per-point linear regression (Capacitance_measurement's own multi-depth sweep at that point). `Force<->V` has only ONE sample per point in mucaboard_data_raw (single depth = 10mm), so no slope is fittable there -- the single matched (Force, V) pair is reported instead. `Cp_pF (interp)` evaluates the point's own Force<->Cp_pF fit at its matched Force; `Cp_pF (pooled V-fit)` evaluates the SURFACE-WIDE pooled V->Cp_pF fit (from `calibrate_capacitance_muca_lcr_futek.m`, STEP B) at this point's own V -- the difference between the two is that pooled model's point-specific error.

## FLAT

Pooled (surface-wide) fit: `Cp_pF = -0.9218 * V_own + 2.0550` (n=19 points)

| point | code_id | Force<->Cp_pF fit (per point) | R2 | n | Force_N | muca_raw | muca_V | Cp_pF (interp) | Cp_pF (pooled V-fit) | residual (pF) |
|---|---|---|---|---|---|---|---|---|---|---|
| P01 | 8 | Cp_pF = -0.0025*F + 1.5313 | 0.986 | 6 | 20.670 | 34.54 | 0.6355 | 1.4800 | 1.4692 | +0.0108 |
| P02 | 4 | Cp_pF = -0.0034*F + 1.5693 | 0.987 | 6 | 20.294 | 36.60 | 0.7188 | 1.4993 | 1.3924 | +0.1068 |
| P03 | 1 | Cp_pF = -0.0050*F + 1.3175 | 0.998 | 6 | 19.058 | 41.56 | 0.8089 | 1.2216 | 1.3094 | -0.0878 |
| P04 | 13 | Cp_pF = -0.0027*F + 1.8539 | 0.982 | 6 | 21.546 | 31.97 | 0.6002 | 1.7964 | 1.5018 | +0.2946 |
| P05 | 9 | Cp_pF = -0.0038*F + 1.8533 | 0.984 | 6 | 21.379 | 30.01 | 0.5530 | 1.7716 | 1.5453 | +0.2263 |
| P06 | 5 | Cp_pF = -0.0039*F + 1.6429 | 0.990 | 6 | 21.355 | 40.34 | 0.7878 | 1.5589 | 1.3288 | +0.2301 |
| P07 | 2 | Cp_pF = -0.0040*F + 1.4111 | 0.993 | 6 | 19.298 | 35.09 | 0.6685 | 1.3334 | 1.4388 | -0.1054 |
| P08 | 17 | Cp_pF = -0.0022*F + 1.6185 | 0.994 | 6 | 21.180 | 32.09 | 0.5794 | 1.5728 | 1.5209 | +0.0519 |
| P09 | 14 | Cp_pF = -0.0036*F + 1.8509 | 0.983 | 6 | 21.204 | 25.98 | 0.4403 | 1.7740 | 1.6491 | +0.1248 |
| P10 | 10 | Cp_pF = -0.0038*F + 1.8239 | 0.988 | 6 | 20.502 | 23.14 | 0.3780 | 1.7450 | 1.7066 | +0.0384 |
| P11 | 6 | Cp_pF = -0.0039*F + 1.6192 | 0.985 | 6 | 19.854 | 28.89 | 0.4968 | 1.5427 | 1.5970 | -0.0543 |
| P12 | 3 | Cp_pF = -0.0028*F + 1.3125 | 0.980 | 6 | 18.487 | 31.43 | 0.5876 | 1.2603 | 1.5133 | -0.2531 |
| P13 | 18 | Cp_pF = -0.0036*F + 1.5885 | 0.987 | 6 | 21.136 | 32.79 | 0.6411 | 1.5127 | 1.4641 | +0.0486 |
| P14 | 15 | Cp_pF = -0.0042*F + 1.7319 | 0.988 | 6 | 20.590 | 33.06 | 0.6249 | 1.6448 | 1.4790 | +0.1658 |
| P15 | 11 | Cp_pF = -0.0038*F + 1.6011 | 0.988 | 6 | 20.001 | 26.32 | 0.5089 | 1.5261 | 1.5859 | -0.0599 |
| P16 | 7 | Cp_pF = -0.0029*F + 1.3249 | 0.983 | 6 | 18.182 | 33.60 | 0.6367 | 1.2716 | 1.4681 | -0.1965 |
| P17 | 19 | Cp_pF = -0.0036*F + 1.3193 | 0.989 | 6 | 20.198 | 43.38 | 0.7707 | 1.2469 | 1.3446 | -0.0977 |
| P18 | 16 | Cp_pF = -0.0030*F + 1.3675 | 0.994 | 6 | 19.624 | 38.59 | 0.6989 | 1.3094 | 1.4107 | -0.1013 |
| P19 | 12 | Cp_pF = -0.0030*F + 1.2259 | 0.981 | 6 | 17.734 | 29.49 | 0.5399 | 1.1734 | 1.5574 | -0.3840 |

## SOLID

Pooled (surface-wide) fit: `Cp_pF = -1.1156 * V_own + 1.5867` (n=19 points)

| point | code_id | Force<->Cp_pF fit (per point) | R2 | n | Force_N | muca_raw | muca_V | Cp_pF (interp) | Cp_pF (pooled V-fit) | residual (pF) |
|---|---|---|---|---|---|---|---|---|---|---|
| P01 | 8 | Cp_pF = -0.0043*F + 1.2707 | 0.987 | 6 | 10.614 | 25.59 | 0.3157 | 1.2255 | 1.2345 | -0.0091 |
| P02 | 4 | Cp_pF = -0.0058*F + 1.1070 | 0.995 | 6 | 10.575 | 39.27 | 0.7124 | 1.0459 | 0.7919 | +0.2539 |
| P03 | 1 | Cp_pF = -0.0056*F + 1.1875 | 0.985 | 6 | 10.259 | 39.49 | 0.7166 | 1.1298 | 0.7872 | +0.3426 |
| P04 | 13 | Cp_pF = -0.0047*F + 1.9710 | 0.969 | 6 | 9.119 | 18.53 | 0.0000 | 1.9281 | 1.5867 | +0.3413 |
| P05 | 9 | Cp_pF = -0.0062*F + 1.4881 | 0.995 | 6 | 9.764 | 29.18 | 0.4467 | 1.4272 | 1.0884 | +0.3388 |
| P06 | 5 | Cp_pF = -0.0060*F + 1.4376 | 0.996 | 6 | 10.357 | 27.58 | 0.3938 | 1.3759 | 1.1474 | +0.2285 |
| P07 | 2 | Cp_pF = -0.0059*F + 1.2985 | 0.982 | 6 | 10.251 | 35.90 | 0.6214 | 1.2377 | 0.8935 | +0.3442 |
| P08 | 17 | Cp_pF = -0.0020*F + 0.0548 | 0.970 | 6 | 10.266 | 27.08 | 0.3755 | 0.0345 | 1.1678 | -1.1333 |
| P09 | 14 | Cp_pF = -0.0053*F + 1.6215 | 0.986 | 6 | 9.374 | 20.68 | 0.0000 | 1.5714 | 1.5867 | -0.0153 |
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
| P18 | 16 | Cp_pF = -0.0120*F + 1.4898 | 0.999 | 6 | 7.412 | 38.73 | 0.7018 | 1.4012 | 1.4384 | -0.0372 |
| P19 | 12 | Cp_pF = -0.0127*F + 1.5153 | 0.991 | 6 | 6.293 | 36.33 | 0.6526 | 1.4352 | 1.5516 | -0.1164 |
