Jonasjcmh/Star_nose_sensor/Capacitance_calibration_Muca_LCR_Futek/results/chained_muca_v_to_cp_via_force.csv

surface | true_point | code_id | force_v_slope | force_v_intercept | force_v_r2 | force_v_n | force_cp_slope | force_cp_intercept | force_cp_r2 | force_cp_n | Cp_pF_at_V0 | Cp_pF_at_V1
flat | 1 | 8 | 0.0269492 | 0.0820818 | 0.8482 | 2000 | -0.00248403 | 1.53133 | 0.9863 | 6 | 1.5389 | 1.4467
flat | 2 | 4 | 0.0166005 | 0.381815 | 0.8184 | 1998 | -0.00344993 | 1.56928 | 0.9873 | 6 | 1.6486 | 1.4408
flat | 3 | 1 | 0.0238554 | 0.3525 | 0.8365 | 1998 | -0.00503443 | 1.3175 | 0.9977 | 6 | 1.3919 | 1.1809
flat | 4 | 13 | 0.0165864 | 0.244308 | 0.8243 | 1998 | -0.00267186 | 1.85394 | 0.9816 | 6 | 1.8933 | 1.7322
flat | 5 | 9 | 0.0129744 | 0.278047 | 0.7735 | 1997 | -0.00382227 | 1.85335 | 0.9844 | 6 | 1.9353 | 1.6407
flat | 6 | 5 | 0.0202827 | 0.35441 | 0.8473 | 1998 | -0.00393113 | 1.64288 | 0.9903 | 6 | 1.7116 | 1.5178
flat | 7 | 2 | 0.0172426 | 0.337774 | 0.8077 | 1998 | -0.00402613 | 1.41111 | 0.9927 | 6 | 1.49 | 1.2565
flat | 8 | 17 | 0.0191455 | 0.174961 | 0.7526 | 1997 | -0.0021561 | 1.6185 | 0.9943 | 6 | 1.6382 | 1.5256
flat | 9 | 14 | 0.0162202 | 0.0962219 | 0.6815 | 1998 | -0.00362642 | 1.85087 | 0.9833 | 6 | 1.8724 | 1.6488
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
