Jonasjcmh/Star_nose_sensor/Capacitance_calibration_Muca_LCR_Futek/results/muca_v_to_cp_table.csv

surface | true_point | code_id | slope_A | intercept_B | r2_weakest_link
flat | 1 | 8 | -0.0922 | 1.5389 | 0.8482
flat | 2 | 4 | -0.2078 | 1.6486 | 0.8184
flat | 3 | 1 | -0.211 | 1.3919 | 0.8365
flat | 4 | 13 | -0.1611 | 1.8933 | 0.8243
flat | 5 | 9 | -0.2946 | 1.9353 | 0.7735
flat | 6 | 5 | -0.1938 | 1.7116 | 0.8473
flat | 7 | 2 | -0.2335 | 1.49 | 0.8077
flat | 8 | 17 | -0.1126 | 1.6382 | 0.7526
flat | 9 | 14 | -0.2236 | 1.8724 | 0.6815
flat | 10 | 10 | -0.2887 | 1.8538 | 0.5499
flat | 11 | 6 | -0.2494 | 1.6671 | 0.6312
flat | 12 | 3 | -0.1128 | 1.3267 | 0.7772
flat | 13 | 18 | -0.244 | 1.6694 | 0.8329
flat | 14 | 15 | -0.2609 | 1.8084 | 0.8281
flat | 15 | 11 | -0.3546 | 1.7074 | 0.6751
flat | 16 | 7 | -0.1409 | 1.3614 | 0.8155
flat | 17 | 19 | -0.1515 | 1.3642 | 0.8593
flat | 18 | 16 | -0.1461 | 1.4119 | 0.8489
flat | 19 | 12 | -0.1282 | 1.243 | 0.7731
solid | 1 | 8 | -0.1969 | 1.2861 | 0.352
solid | 2 | 4 | -0.1556 | 1.1566 | 0.8426
solid | 3 | 1 | -0.1349 | 1.2266 | 0.836
solid | 4 | 13 | 0.2778 | 1.9263 | 0.2622
solid | 5 | 9 | -0.1873 | 1.5115 | 0.6595
solid | 6 | 5 | -0.1595 | 1.4389 | 0.7324
solid | 7 | 2 | -0.1556 | 1.3346 | 0.7826
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
