Jonasjcmh/Star_nose_sensor/Capacitance_calibration_Muca_LCR_Futek/results/capacitance_gain_validation.png

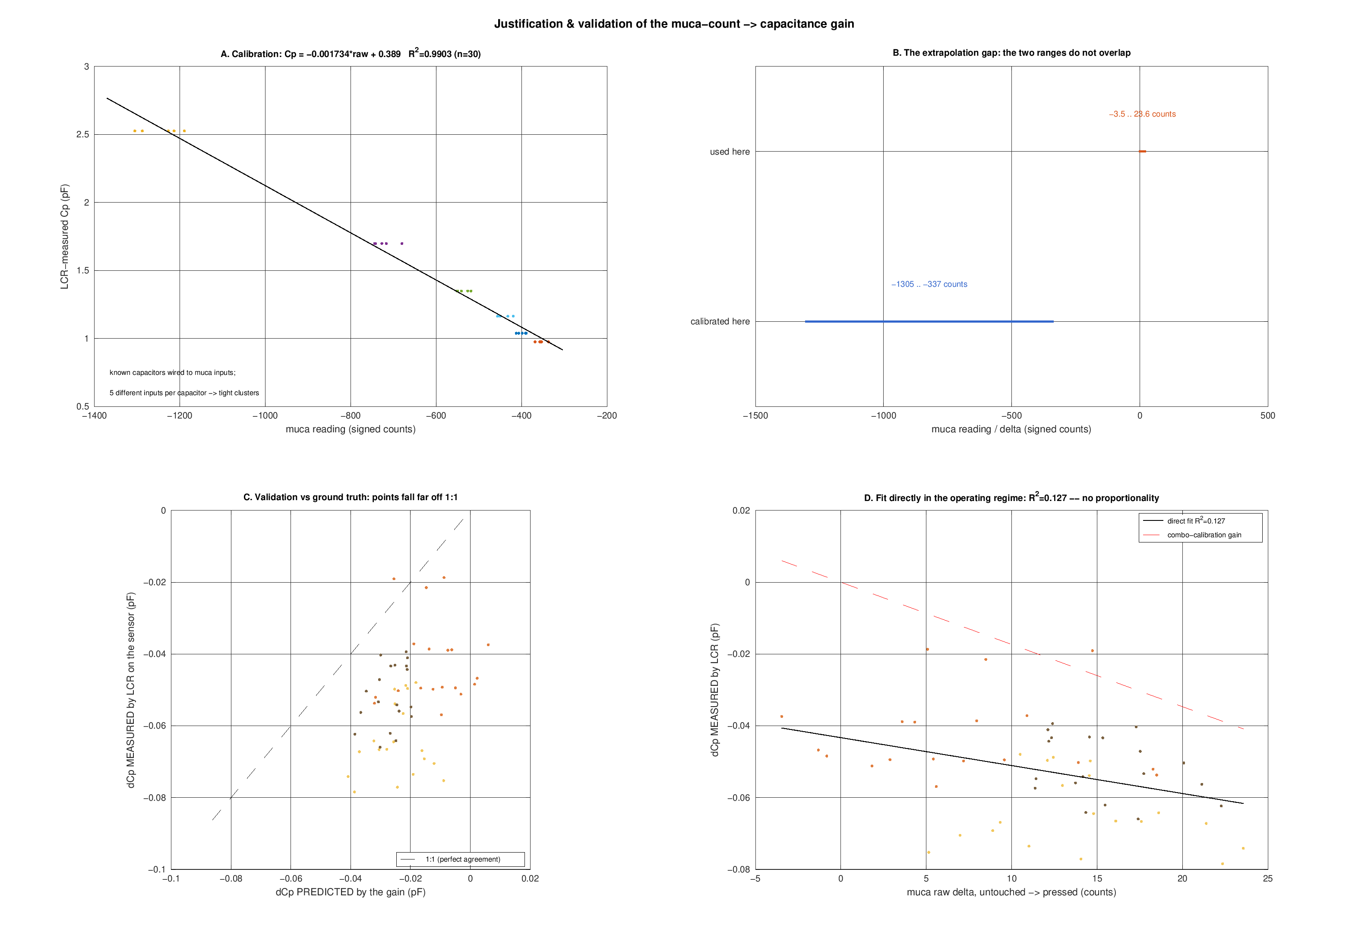
Capacitance_calibration_Muca_LCR_Futek/results/capacitance_gain_validation.png
