Jonasjcmh/Star_nose_sensor/Capacitance_calibration_Muca_LCR_Futek/results/mucaboard_chained_v_hexmap.png

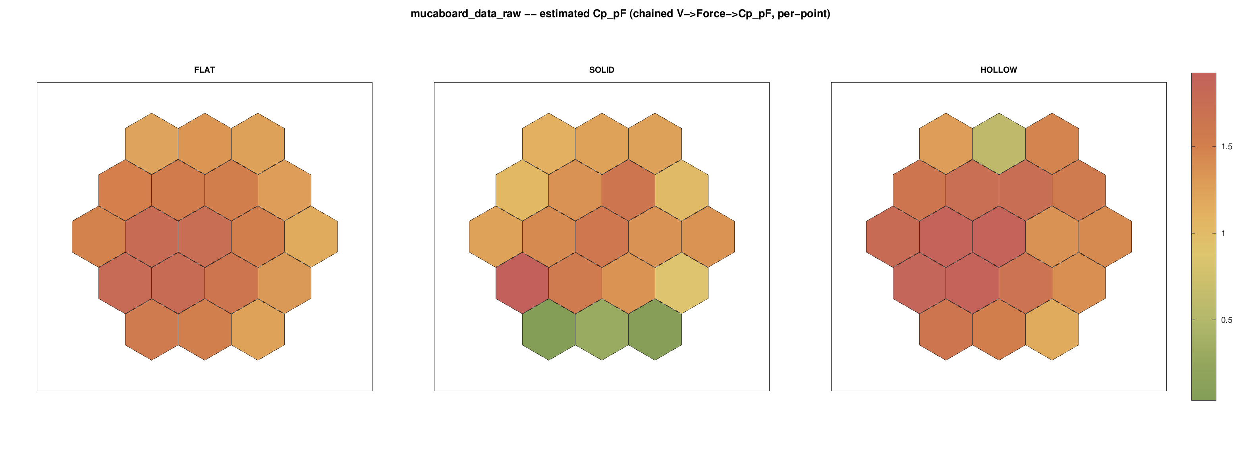
Capacitance_calibration_Muca_LCR_Futek/results/mucaboard_chained_v_hexmap.png
