Jonasjcmh/Star_nose_sensor/capacitance_combination_calibration/gain_calibration_arduino/results/flat_calibration_muca_lcr_session_20260826_225636_gain_analysis.png

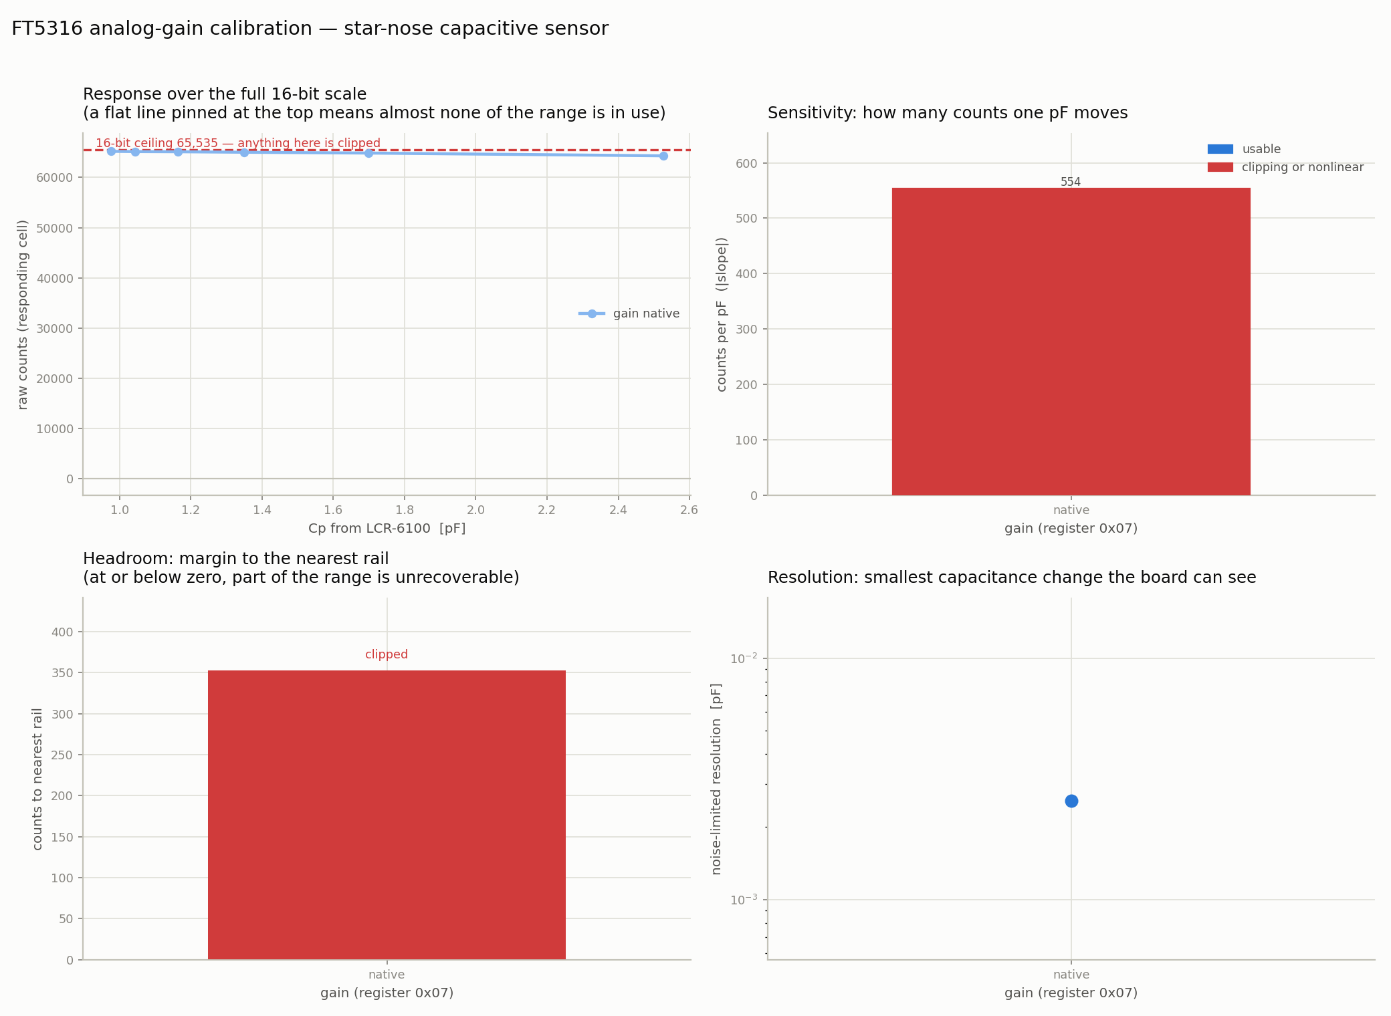
capacitance_combination_calibration/gain_calibration_arduino/results/flat_calibration_muca_lcr_session_20260826_225636_gain_analysis.png
