Jonasjcmh/Star_nose_sensor/capacitance_combination_calibration/logs/testing_cap_v1_session_20260826_220641_bars.png

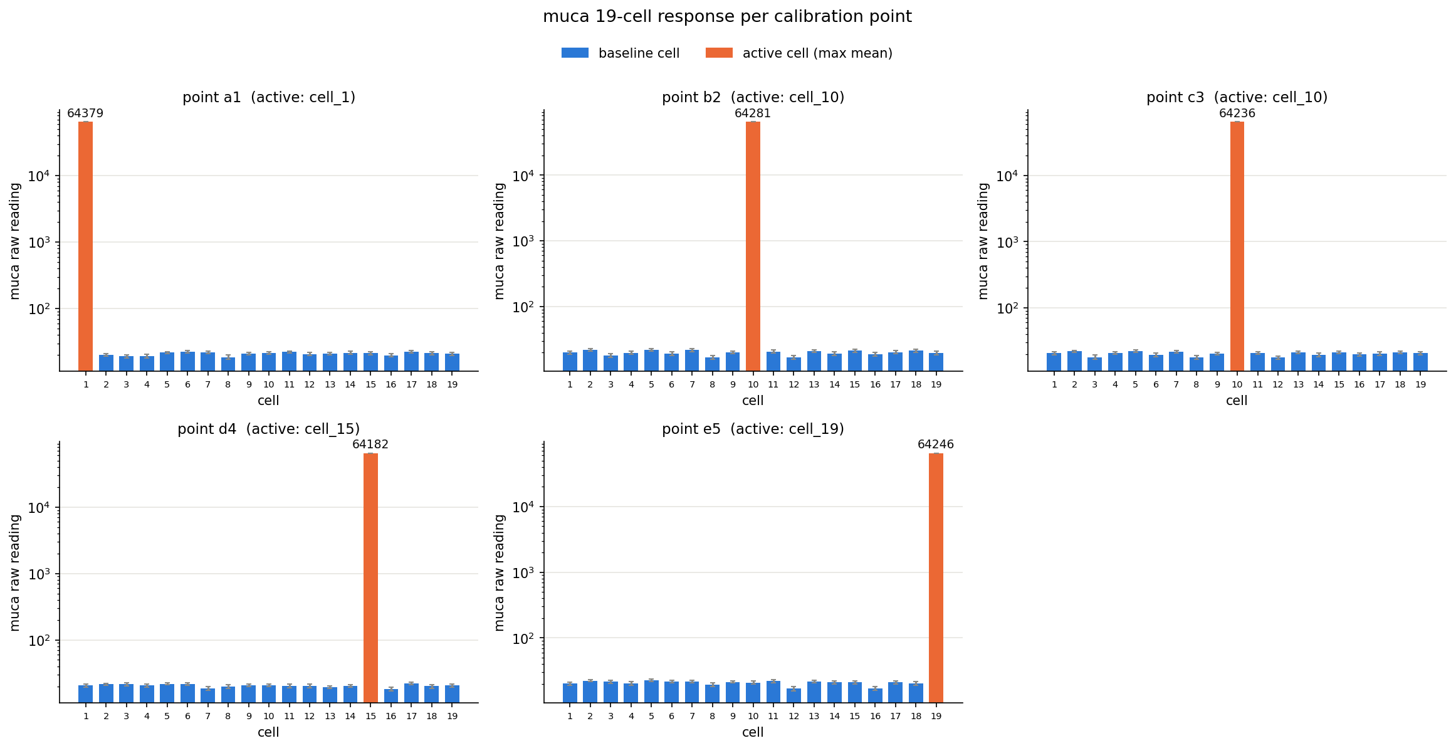
capacitance_combination_calibration/logs/testing_cap_v1_session_20260826_220641_bars.png
