Jonasjcmh/Star_nose_sensor/Capacitance_measurement/data_analysis_ws_flat/plots_depth_comparison/P4_iterations_overlaid.png

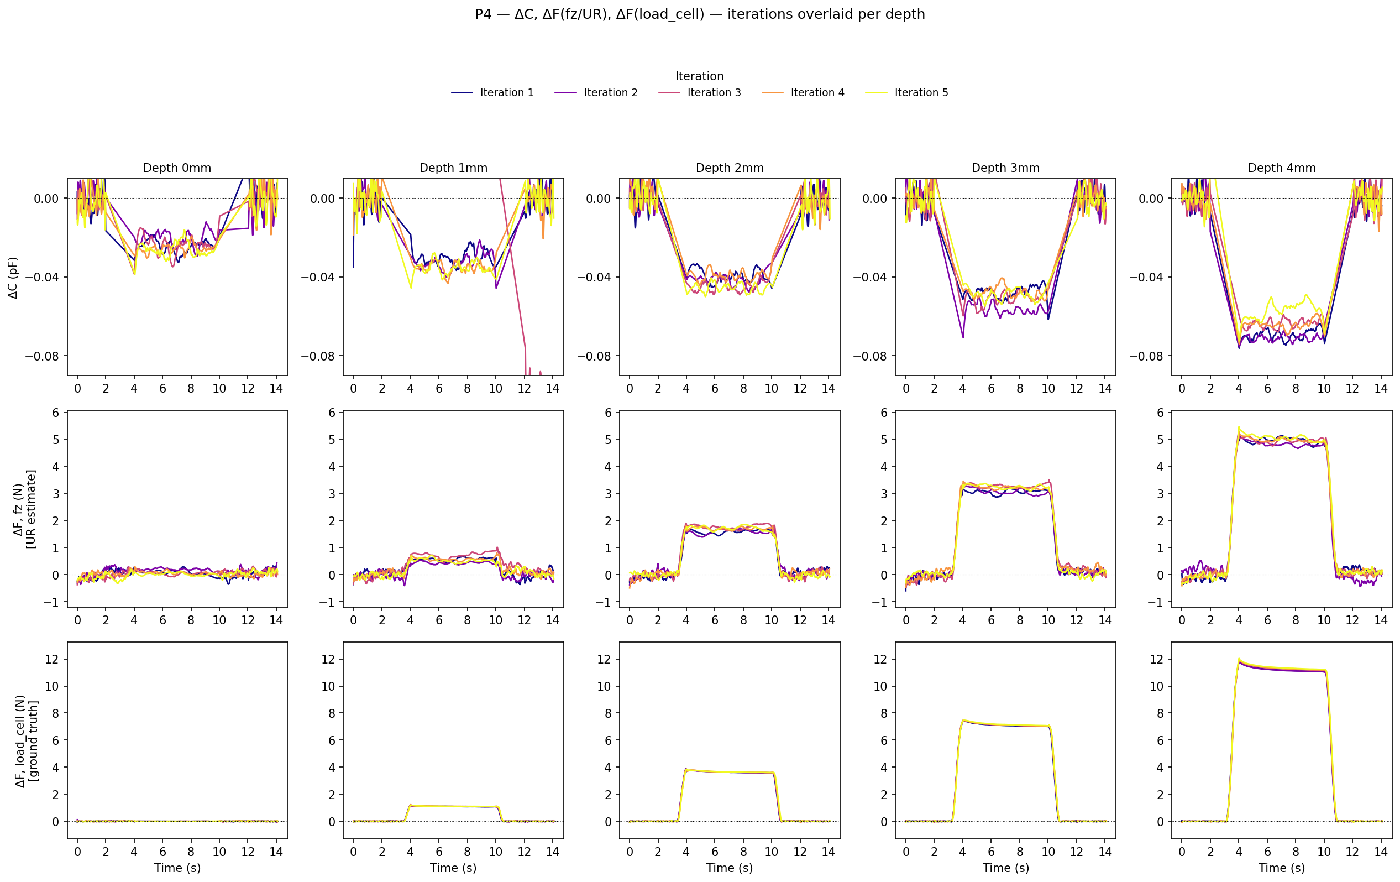
Capacitance_measurement/data_analysis_ws_flat/plots_depth_comparison/P4_iterations_overlaid.png
