Jonasjcmh/Star_nose_sensor/Capacitance_measurement/data_analysis_ws_solid_dome/plots_depth_comparison/P1_iterations_overlaid.png

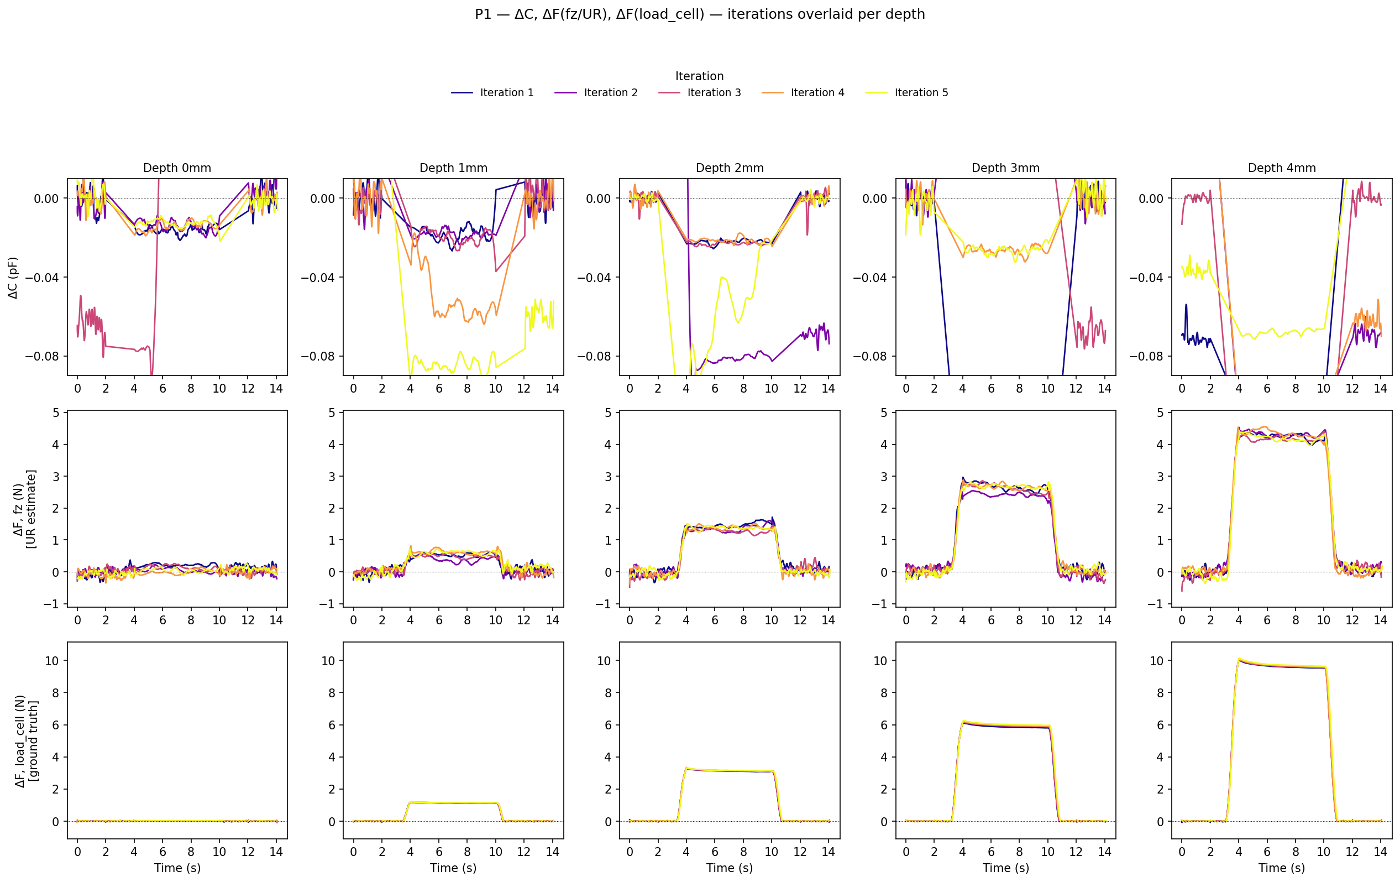
Capacitance_measurement/data_analysis_ws_solid_dome/plots_depth_comparison/P1_iterations_overlaid.png
