Jonasjcmh/Star_nose_sensor/Capacitance_measurement/plots2/cp_waveforms_round1.png

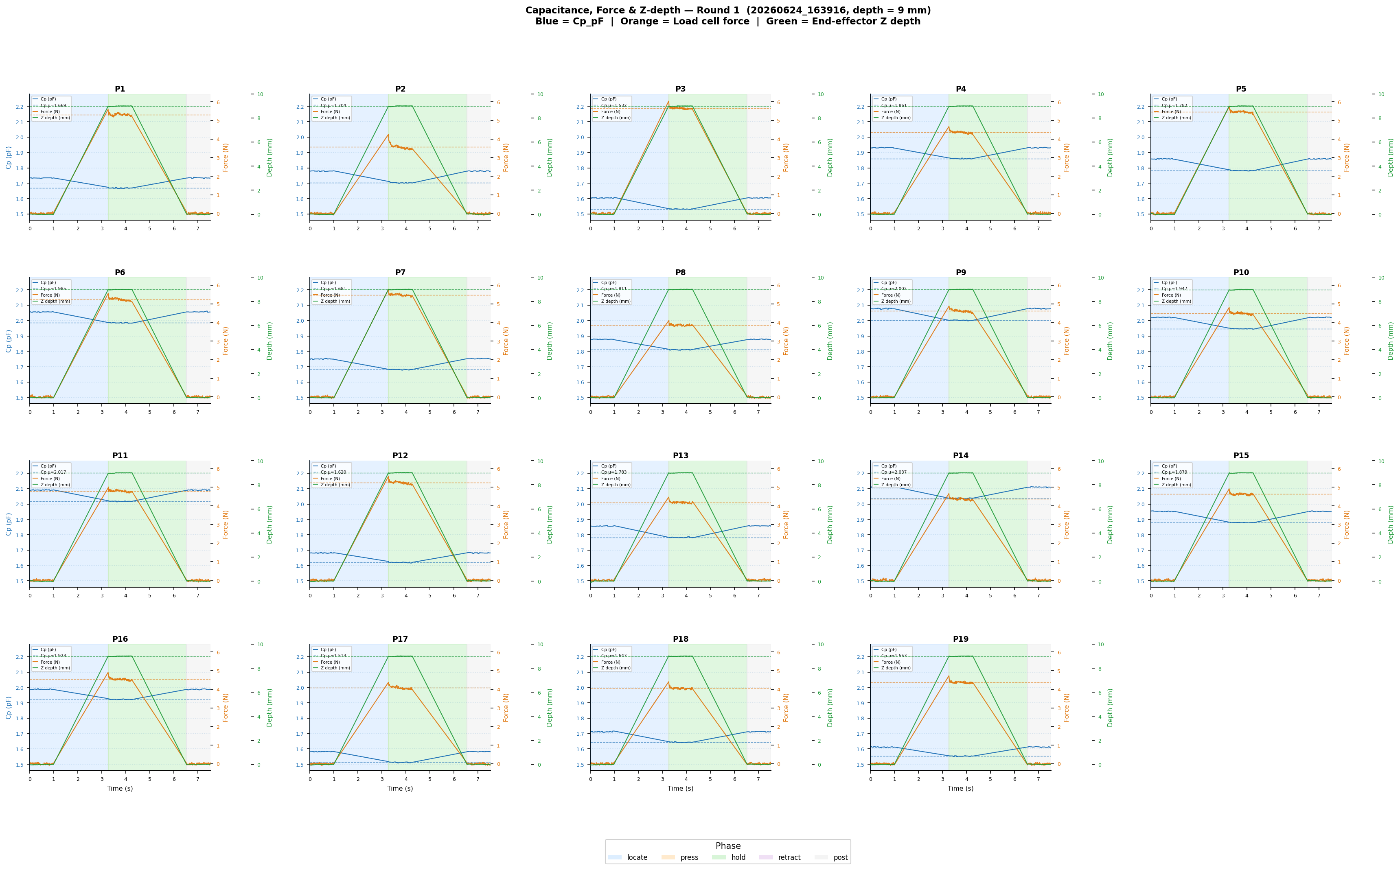
Capacitance_measurement/plots2/cp_waveforms_round1.png
