Jonasjcmh/Star_nose_sensor/Capacitance_measurement/plots2/force_cp_scatter.png

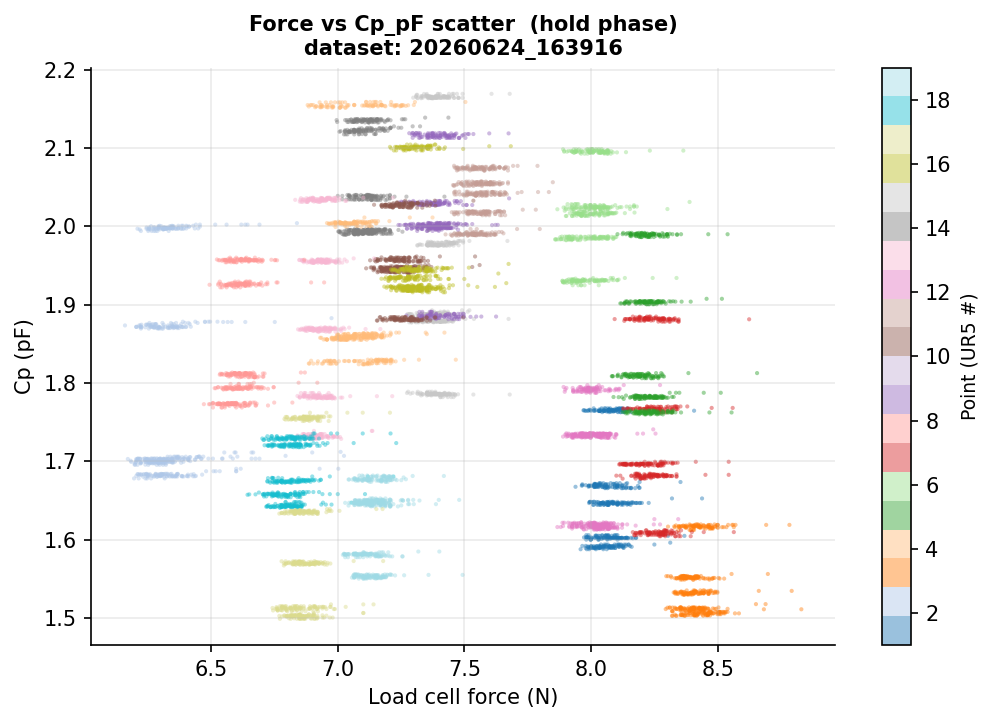
Capacitance_measurement/plots2/force_cp_scatter.png
