Jonasjcmh/Star_nose_sensor/Capacitance_measurement/plots2/phase_boxplots.png

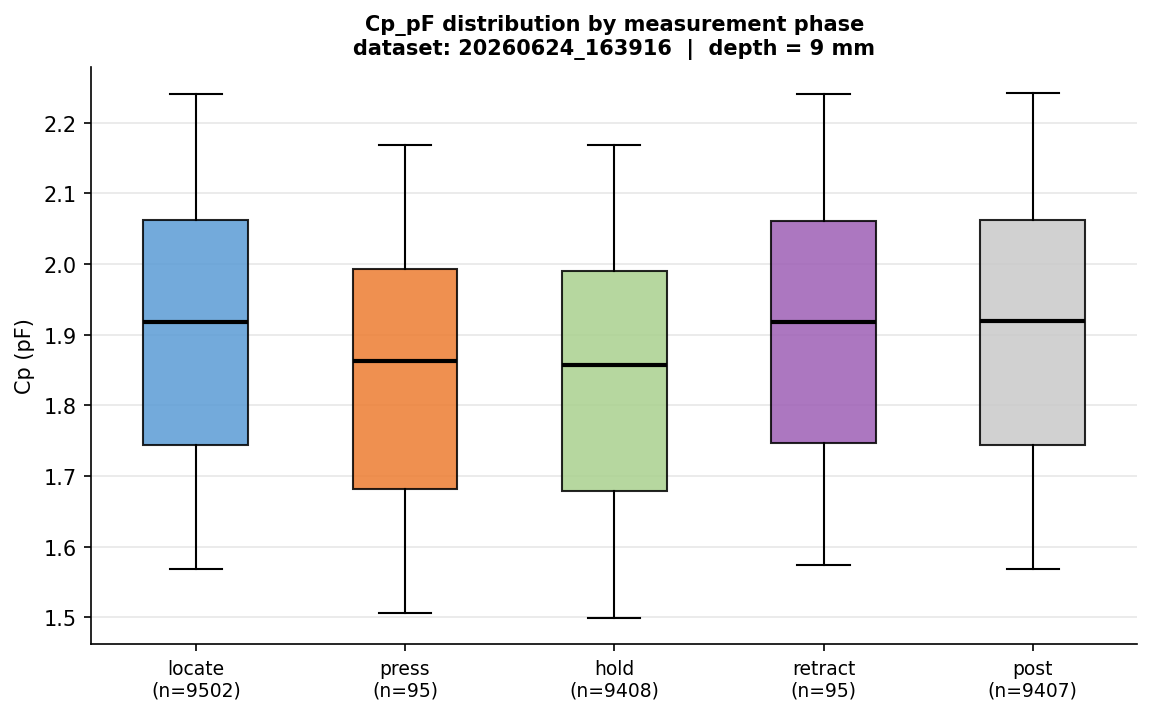
Capacitance_measurement/plots2/phase_boxplots.png
