Jonasjcmh/Star_nose_sensor/Capacitance_measurement/plots2/round_variability.png

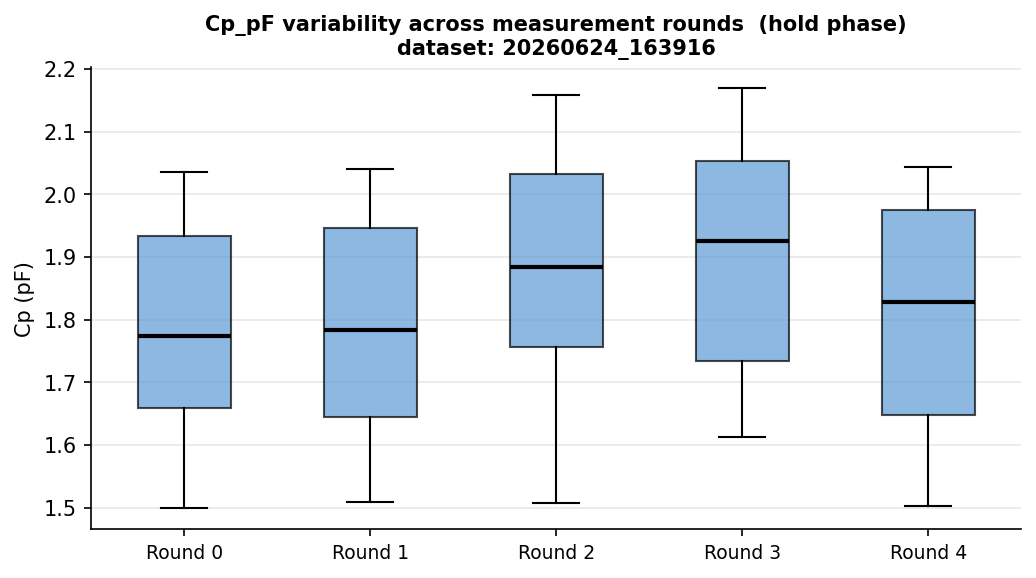
Capacitance_measurement/plots2/round_variability.png
