Jonasjcmh/Star_nose_sensor/Capacitance_measurement/plots2/sensor_map.png

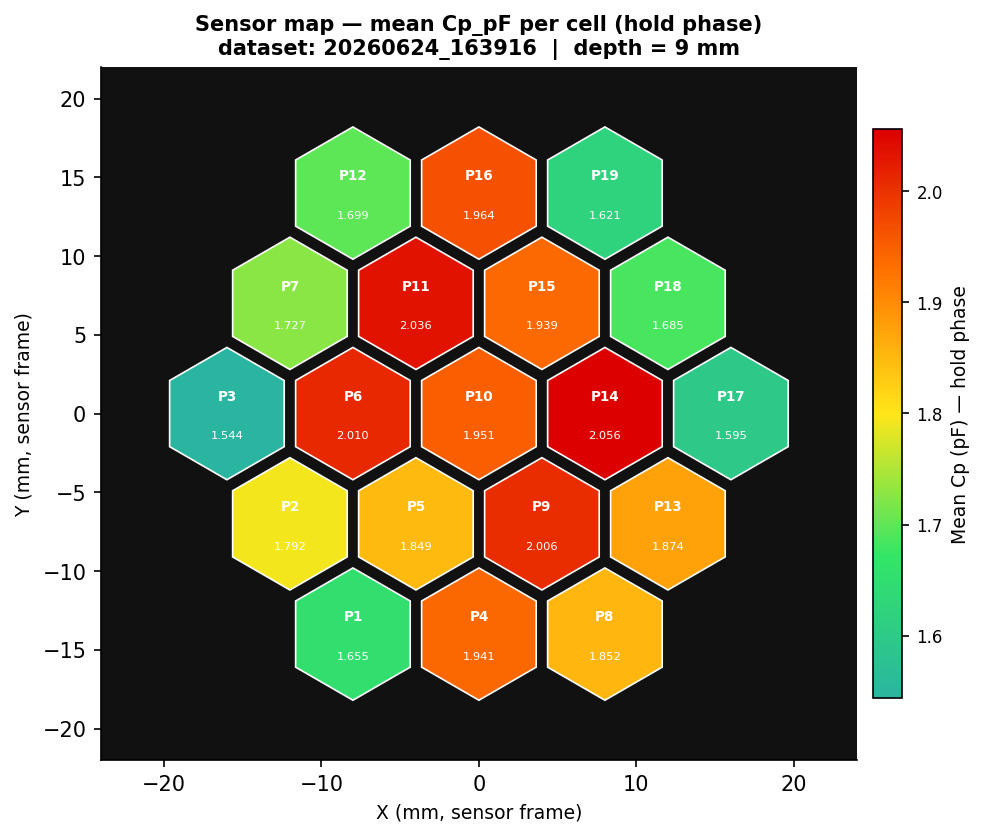
Capacitance_measurement/plots2/sensor_map.png
