Jonasjcmh/Star_nose_sensor/Capacitance_measurement/plots2/summary_bar.png

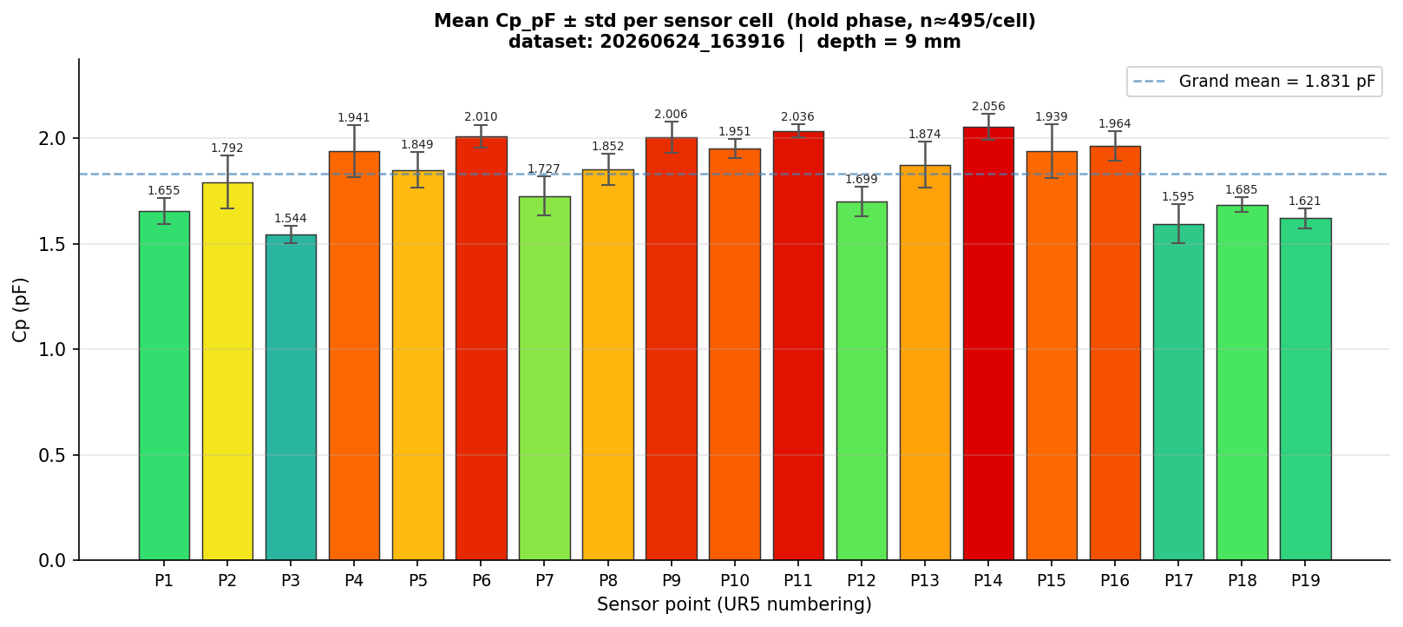
Capacitance_measurement/plots2/summary_bar.png
