Jonasjcmh/Star_nose_sensor/Capacitance_measurement/plots2/timeseries_per_cell.png

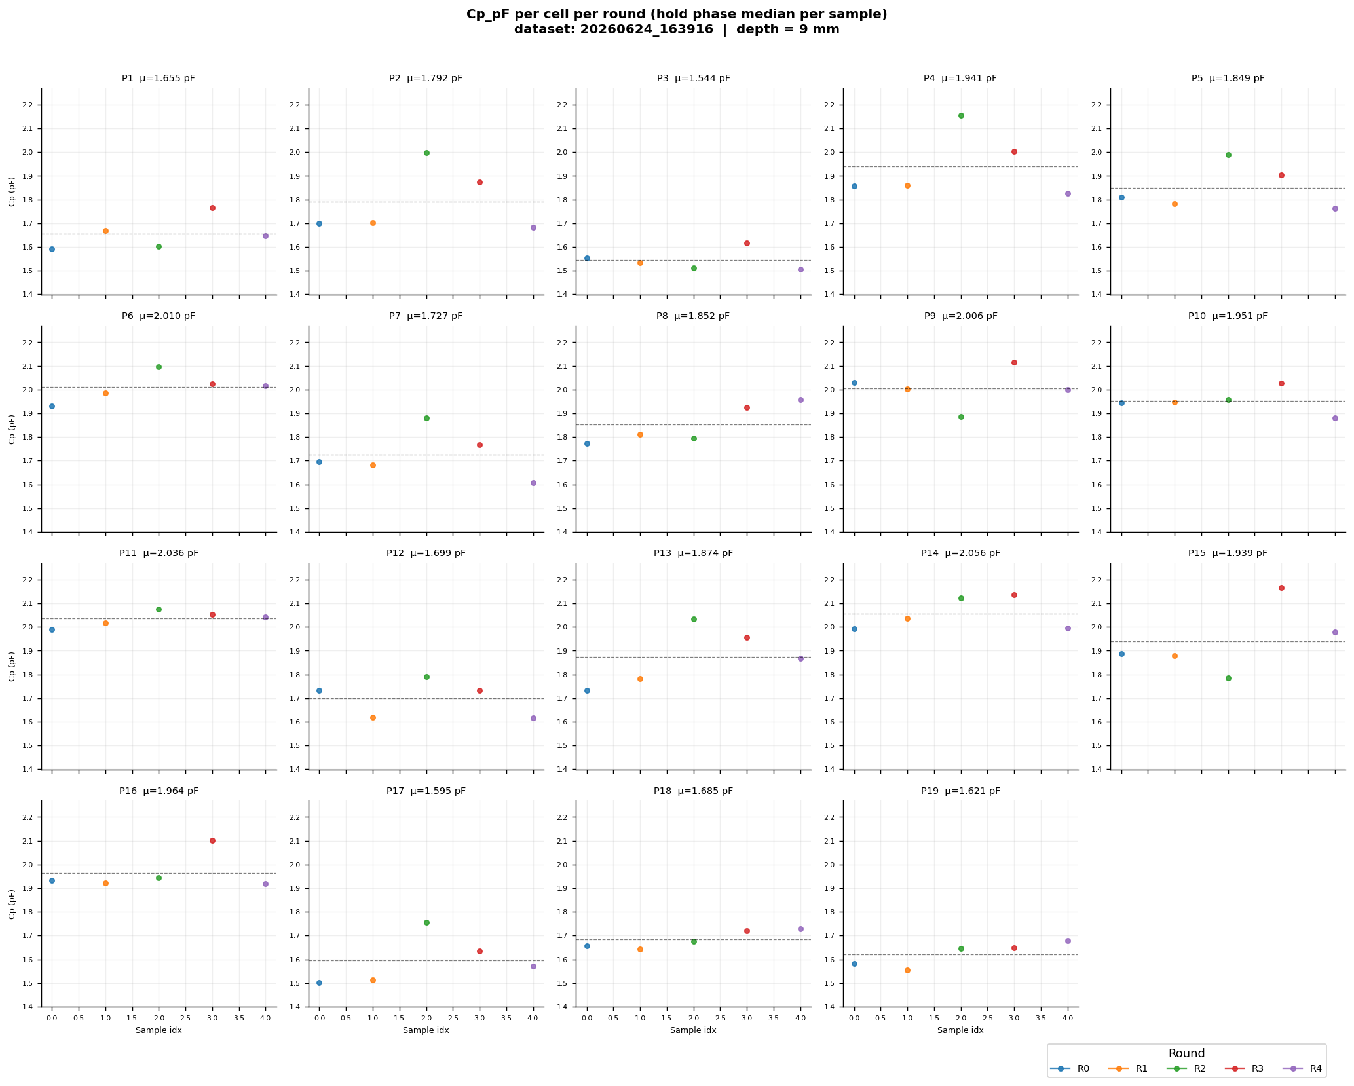
Capacitance_measurement/plots2/timeseries_per_cell.png
