Jonasjcmh/Star_nose_sensor/Capacitance_measurement/plots2/timeseries_per_round.png

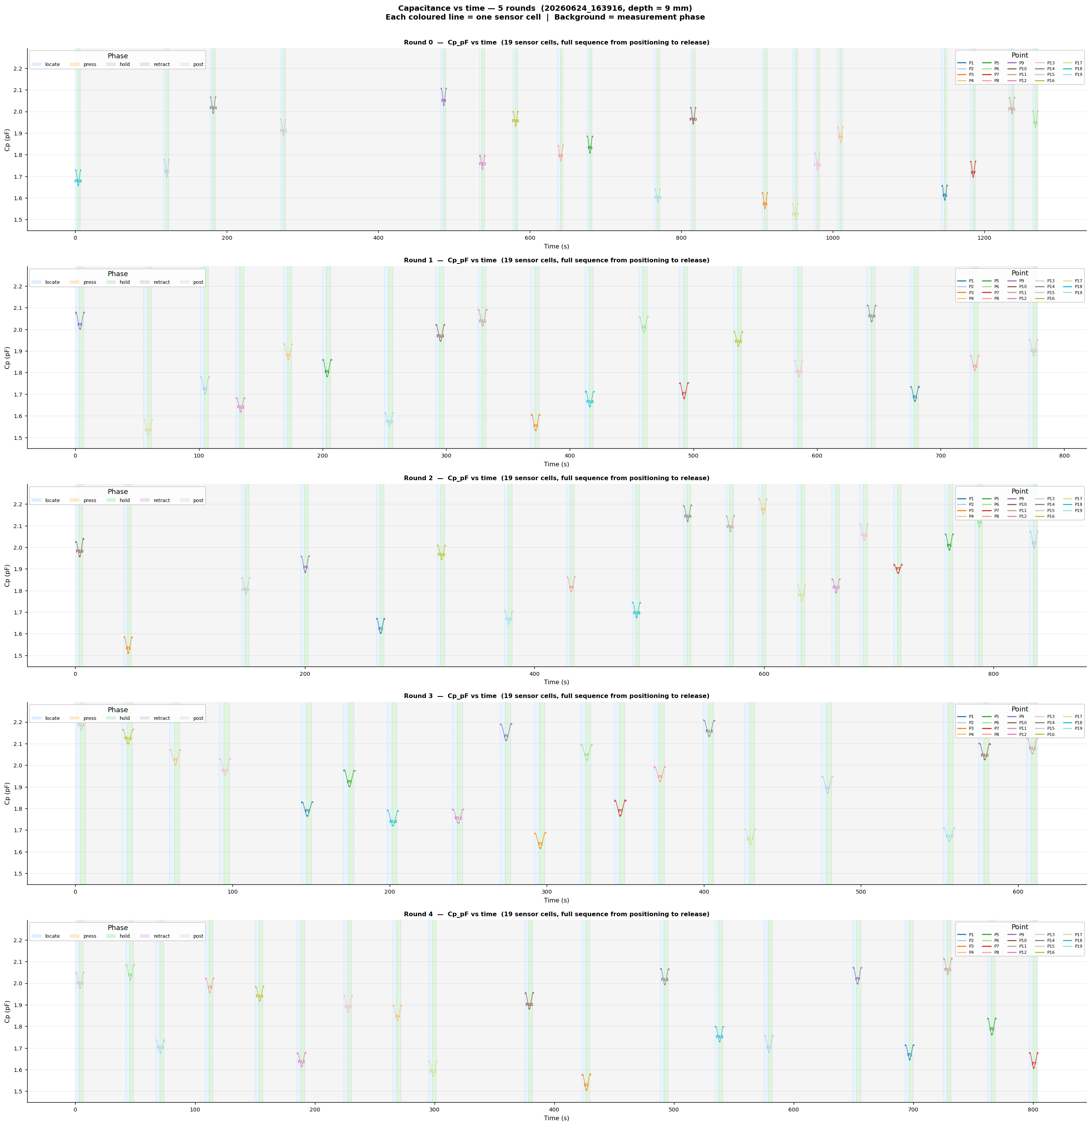
Capacitance_measurement/plots2/timeseries_per_round.png
