Jonasjcmh/Star_nose_sensor/Capacitance_measurement/plots/dataset_capacitance_dataset_20260624_163916/summary_bar.png

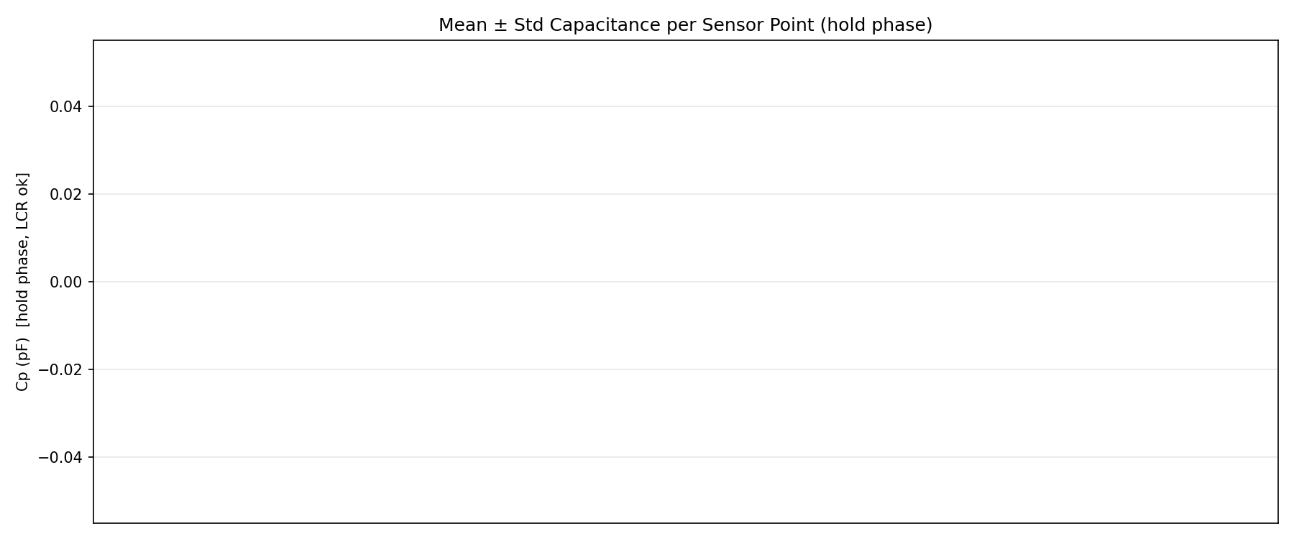
Capacitance_measurement/plots/dataset_capacitance_dataset_20260624_163916/summary_bar.png
