Jonasjcmh/Star_nose_sensor/Capacitance_measurement/plots/dataset_ramp_collector_20260714_124706_3mm_flat/round01_grid.png

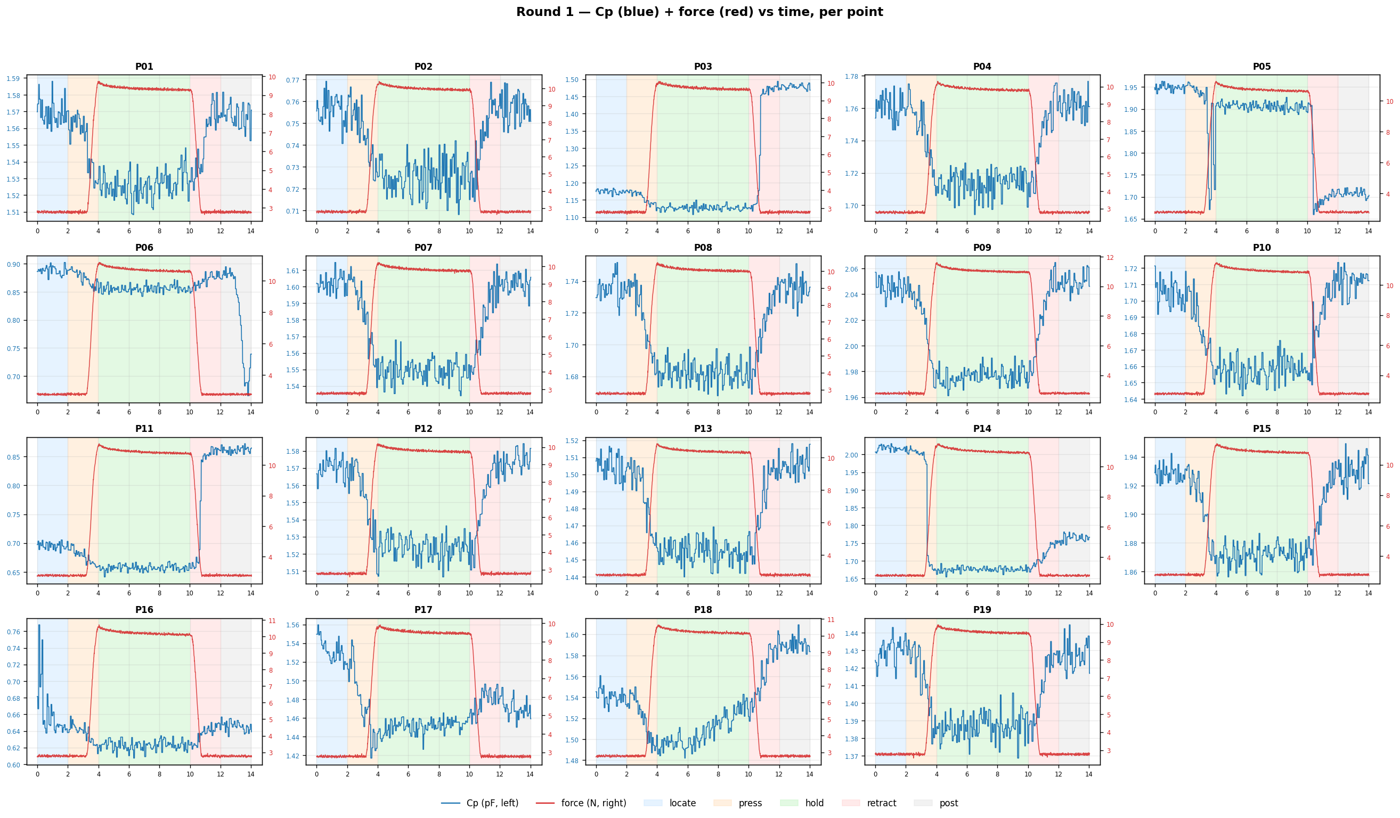
Capacitance_measurement/plots/dataset_ramp_collector_20260714_124706_3mm_flat/round01_grid.png
