Jonasjcmh/Star_nose_sensor/Capacitance_measurement/plots/dataset_ramp_collector_20260714_135538_2mm_flat/force_dcp_scatter.png

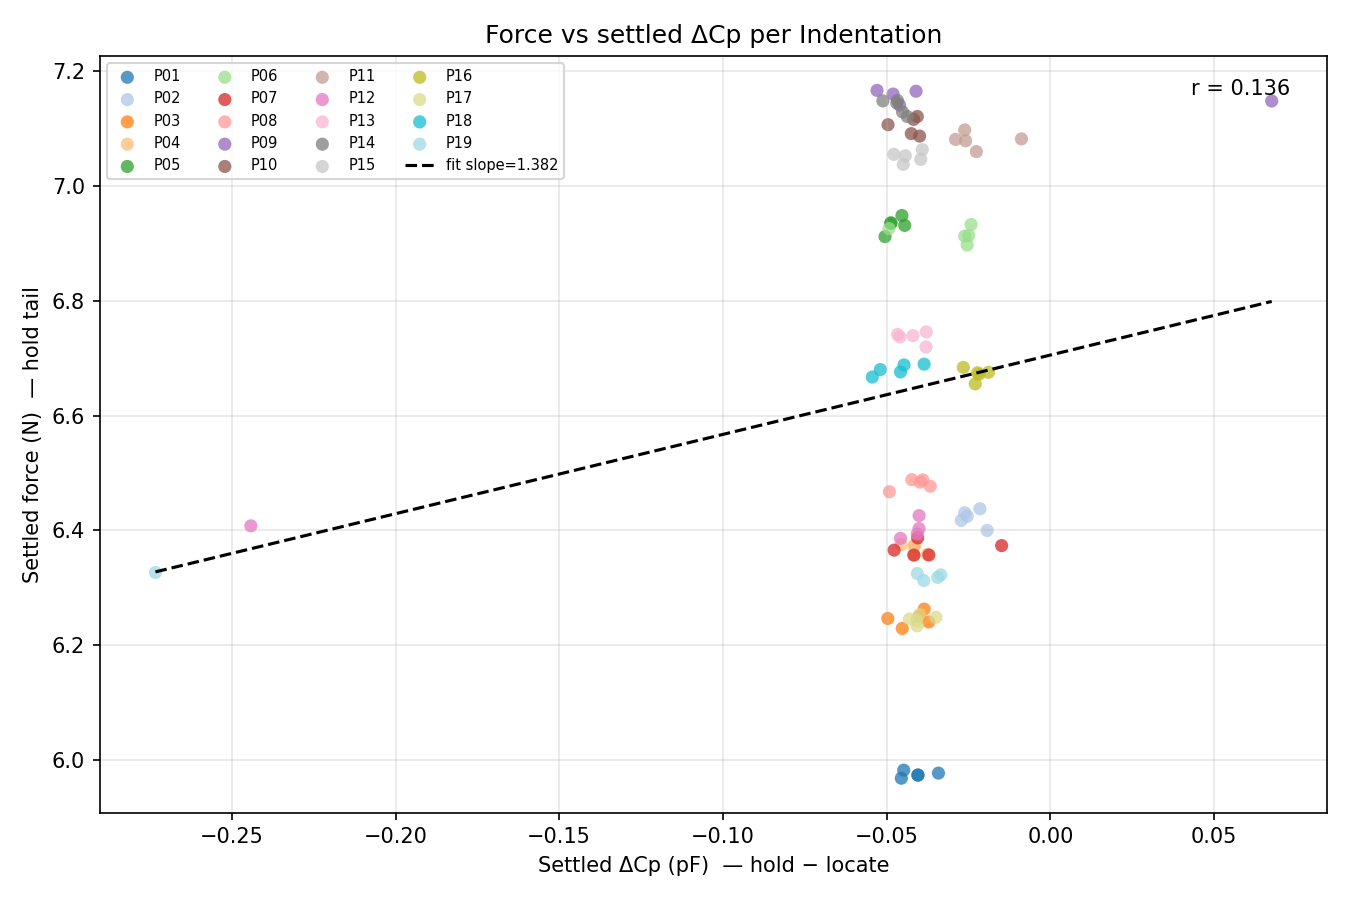
Capacitance_measurement/plots/dataset_ramp_collector_20260714_135538_2mm_flat/force_dcp_scatter.png
