Jonasjcmh/Star_nose_sensor/Capacitance_measurement/plots/dataset_ramp_collector_20260714_151051_1mm_flat/sensor_map_dcp.png

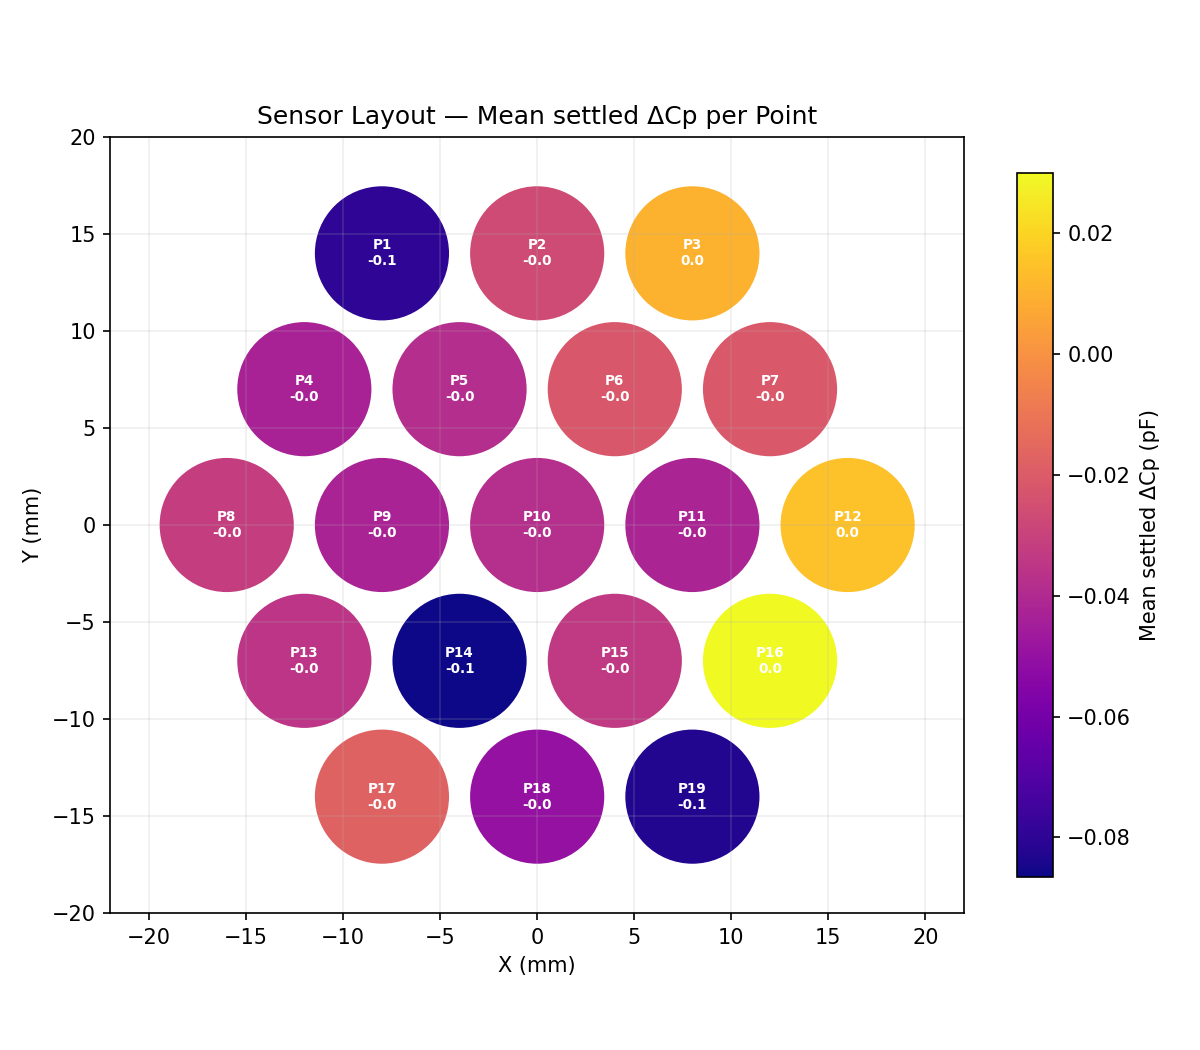
Capacitance_measurement/plots/dataset_ramp_collector_20260714_151051_1mm_flat/sensor_map_dcp.png
