Jonasjcmh/Star_nose_sensor/Capacitance_measurement/plots/dataset_ramp_collector_20260714_163437_0mm_flat/summary_bar_dcp.png

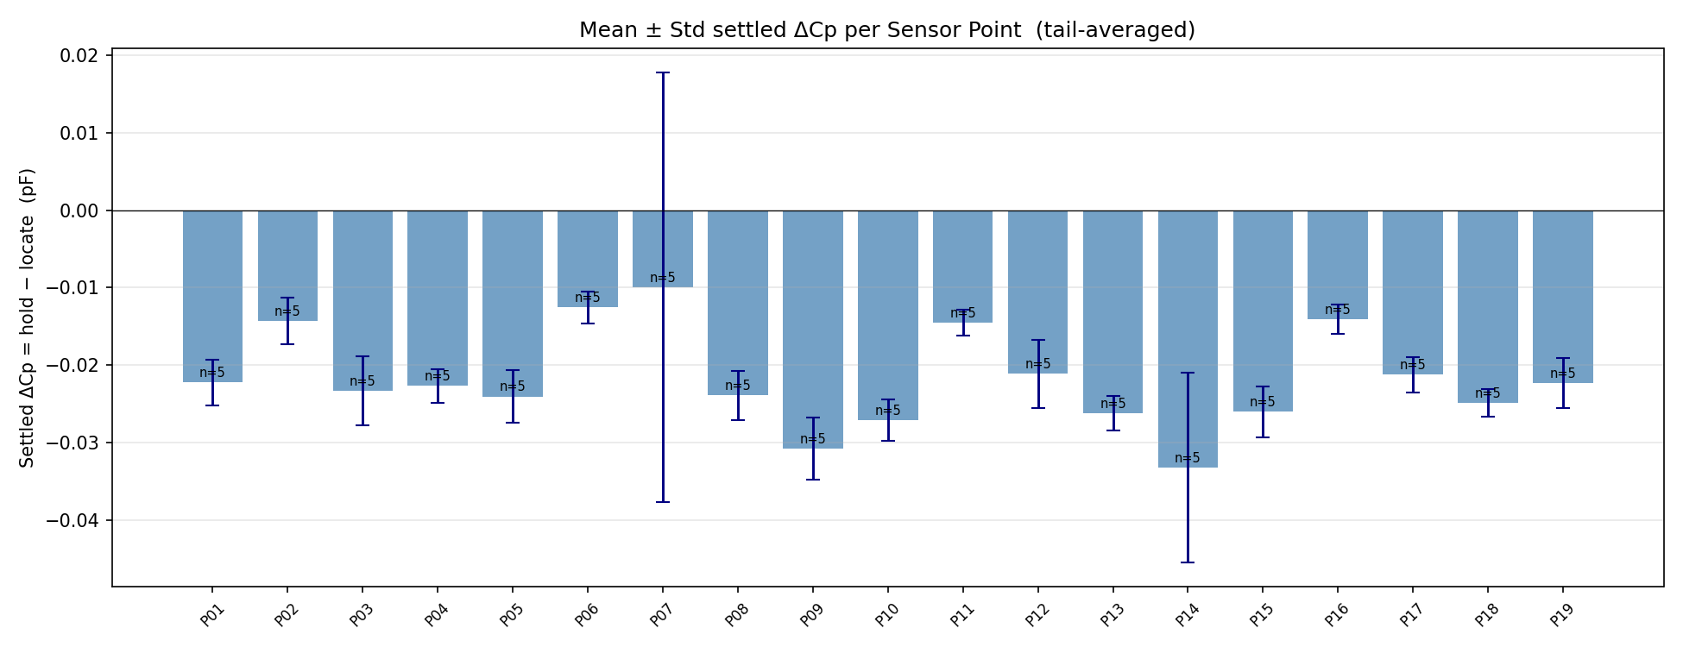
Capacitance_measurement/plots/dataset_ramp_collector_20260714_163437_0mm_flat/summary_bar_dcp.png
