Jonasjcmh/Star_nose_sensor/Capacitance_measurement/plots/single_point_overlay_P01_20260625_133115.png

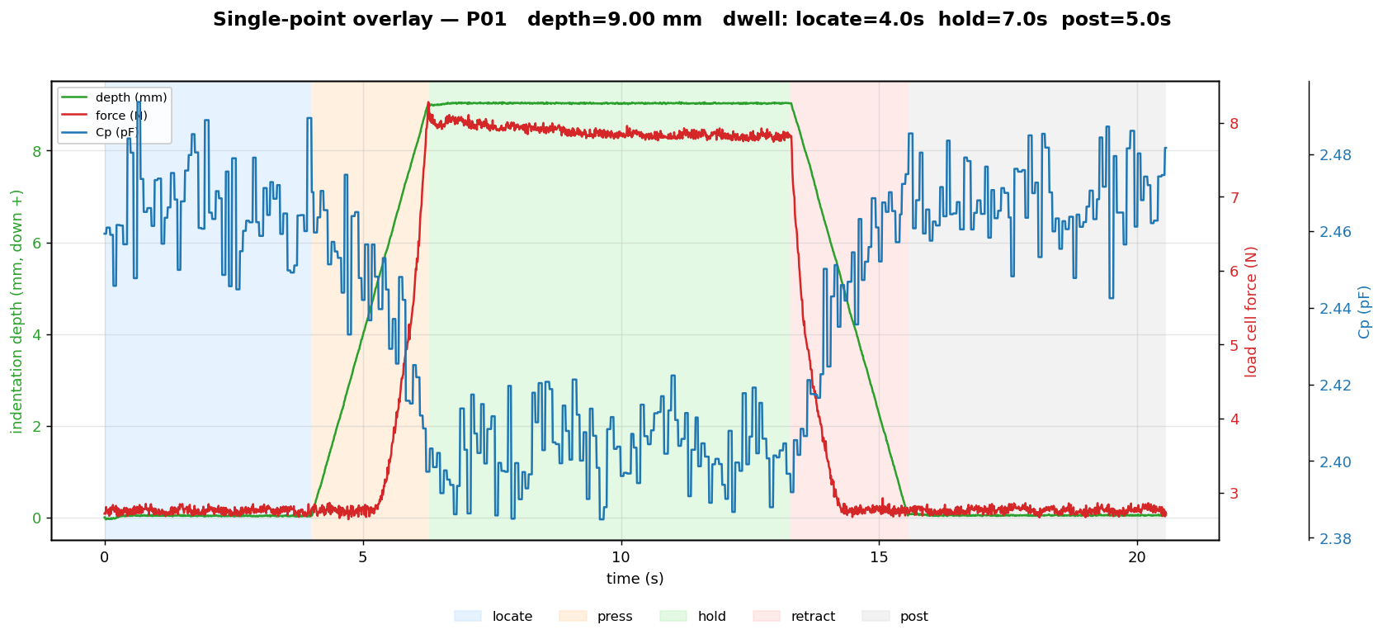
Capacitance_measurement/plots/single_point_overlay_P01_20260625_133115.png
