Jonasjcmh/Star_nose_sensor/Capacitance_measurement/plots/single_point_P10_20260625_115249.png

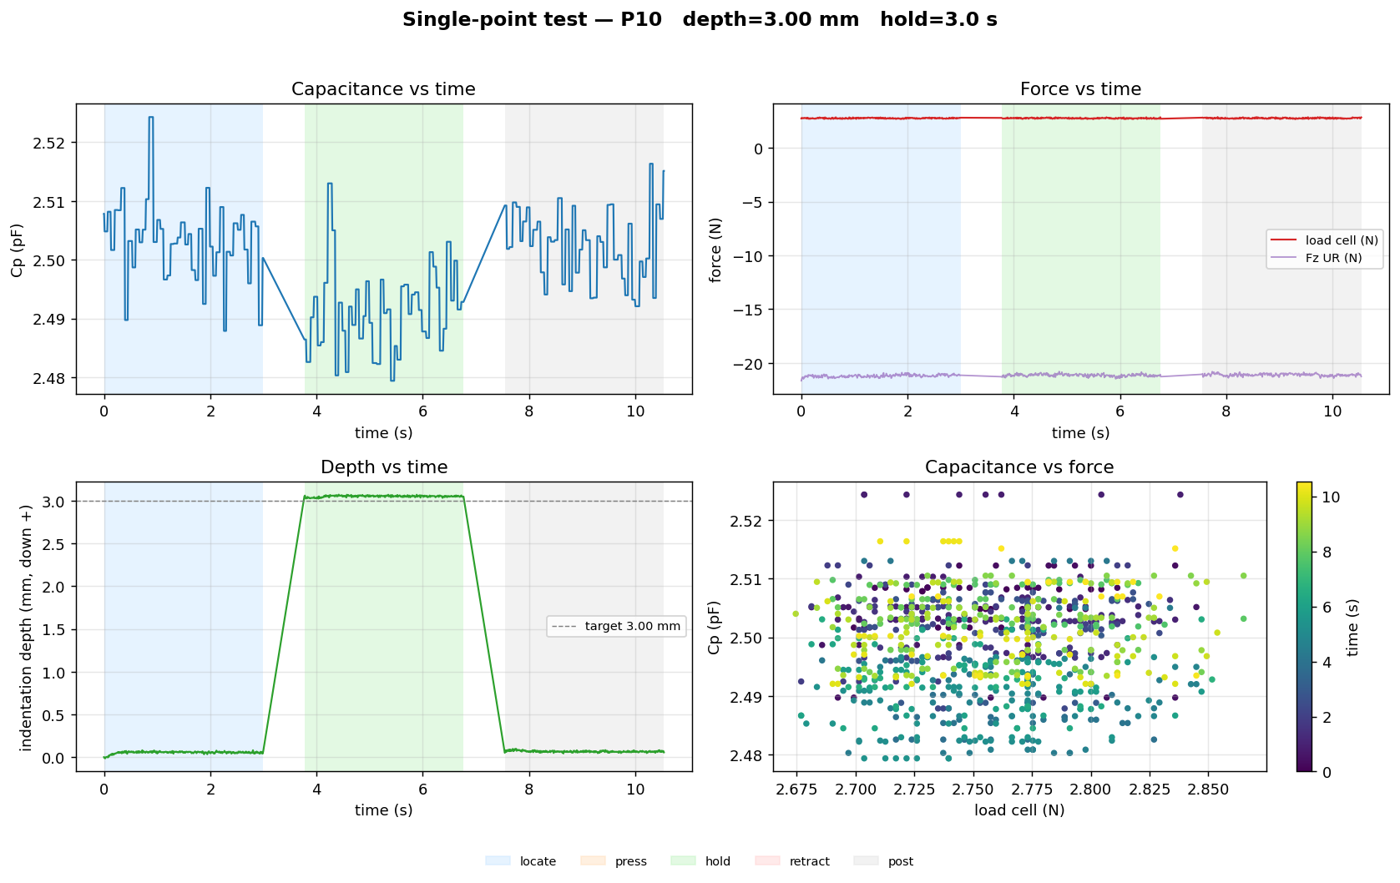
Capacitance_measurement/plots/single_point_P10_20260625_115249.png
