Jonasjcmh/Star_nose_sensor/Capacitance_measurement/plots/single_point_P17_20260625_125709.png

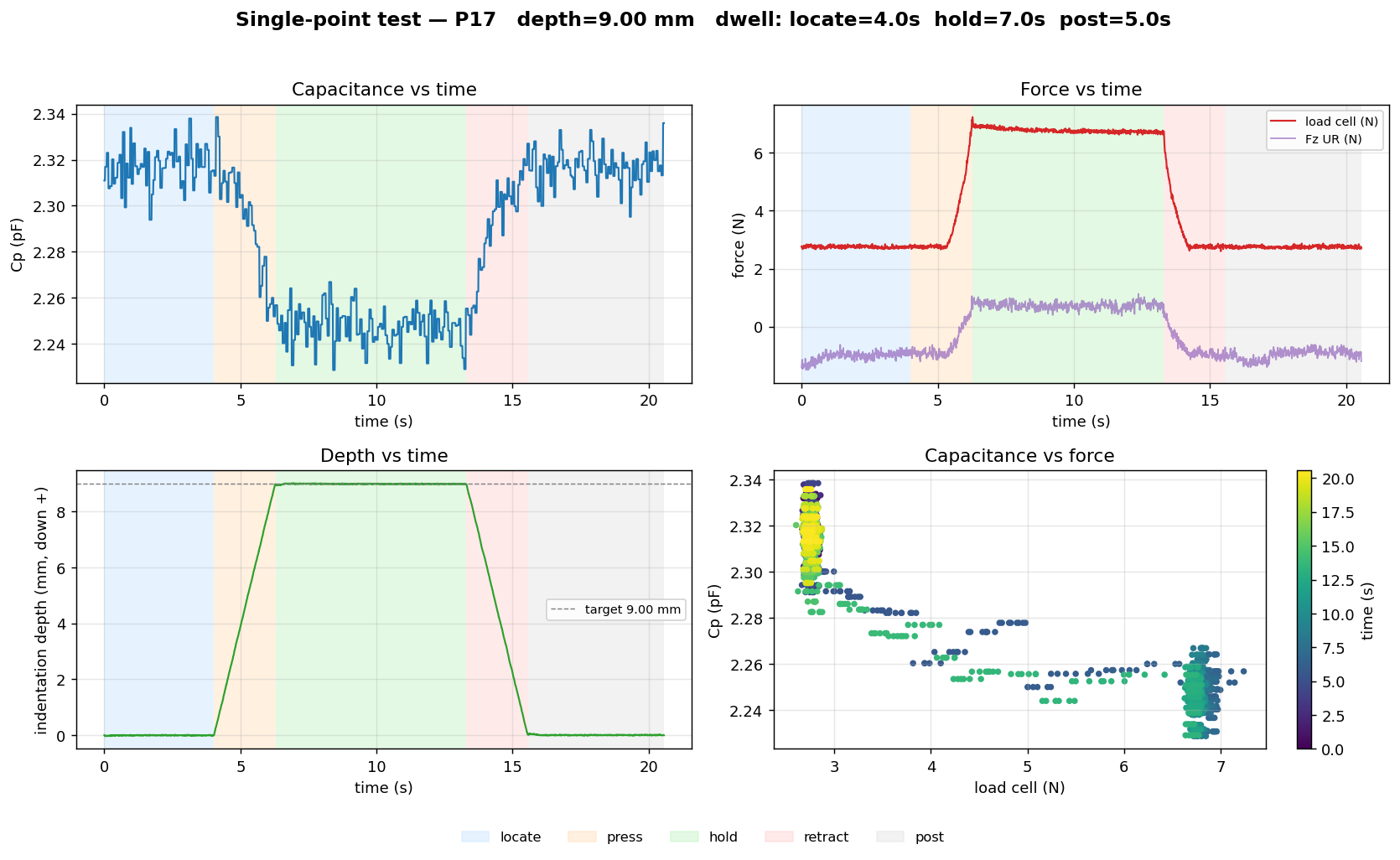
Capacitance_measurement/plots/single_point_P17_20260625_125709.png
