Jonasjcmh/Star_nose_sensor/Capacitance_measurement/plots/single_point_ramp_noLCR_overlay_P01_20260717_163818.png

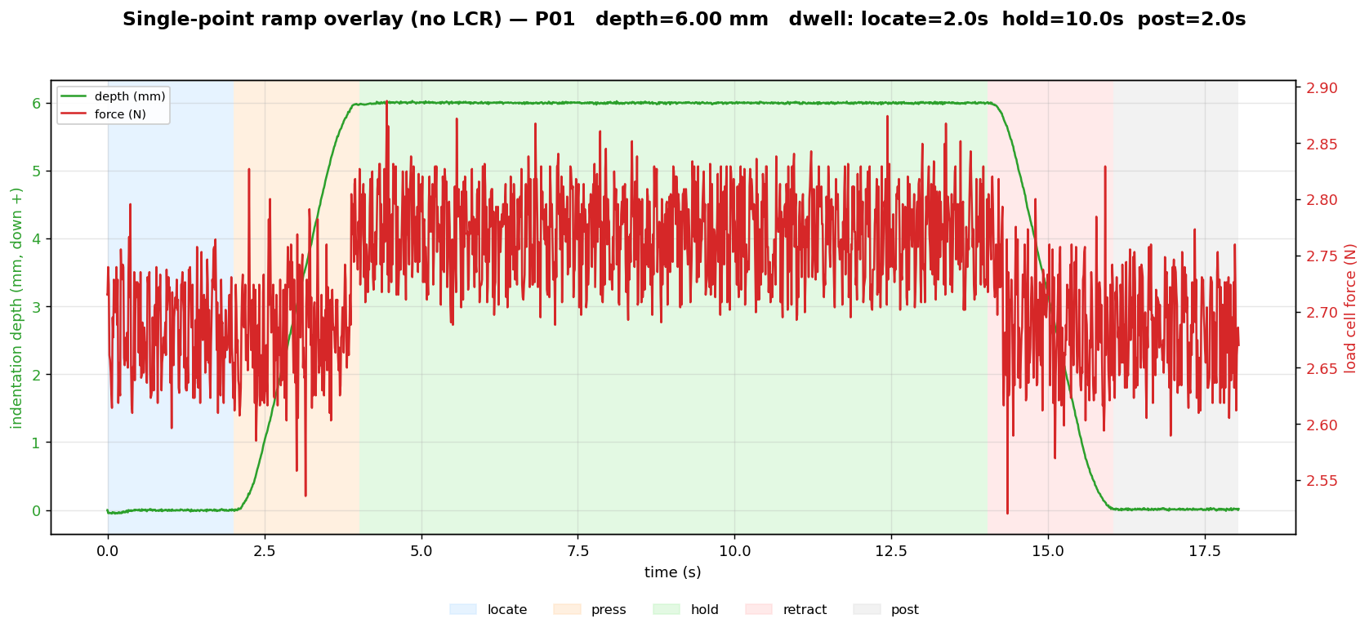
Capacitance_measurement/plots/single_point_ramp_noLCR_overlay_P01_20260717_163818.png
