Jonasjcmh/Star_nose_sensor/Capacitance_measurement/plots/single_point_ramp_noLCR_P01_20260717_161108.png

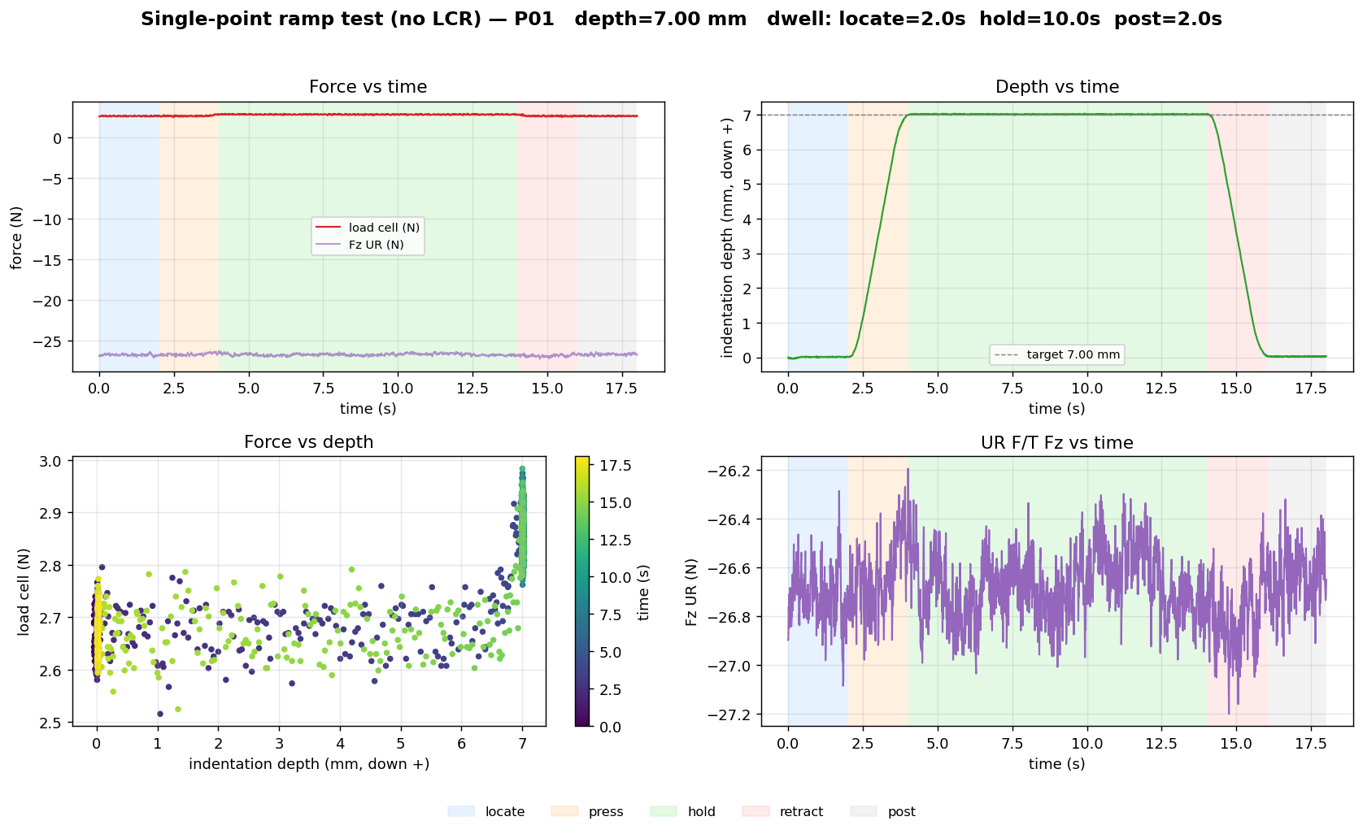
Capacitance_measurement/plots/single_point_ramp_noLCR_P01_20260717_161108.png
