Jonasjcmh/Star_nose_sensor/Capacitance_measurement/plots/single_point_ramp_overlay_P01_20260625_150712.png

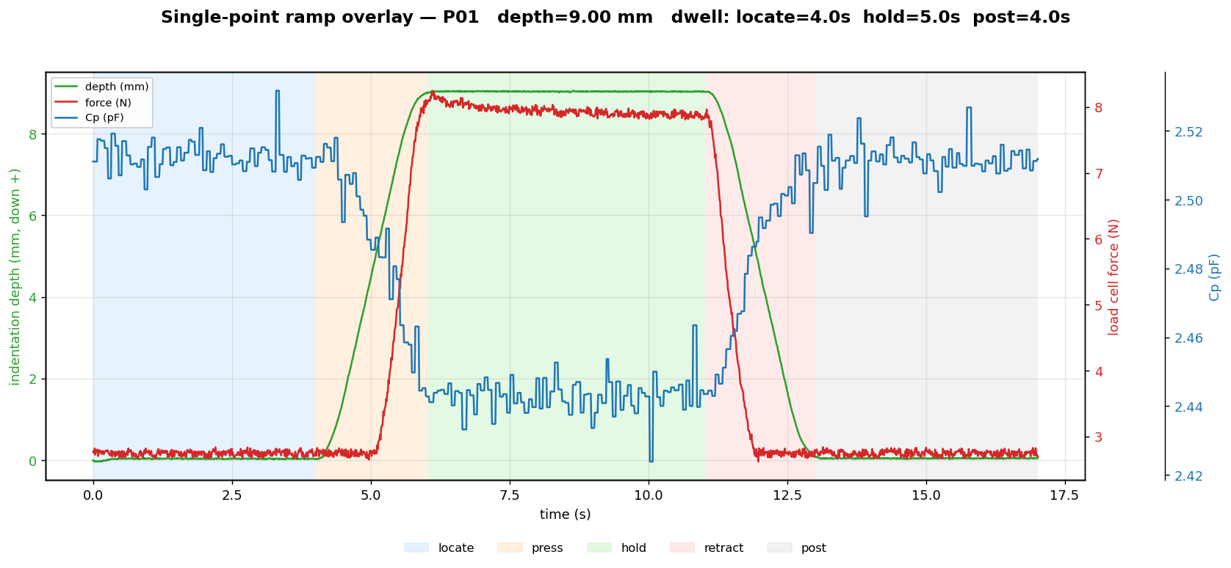
Capacitance_measurement/plots/single_point_ramp_overlay_P01_20260625_150712.png
