Jonasjcmh/Star_nose_sensor/Capacitance_measurement/plots/single_point_ramp_overlay_P02_20260625_150843.png

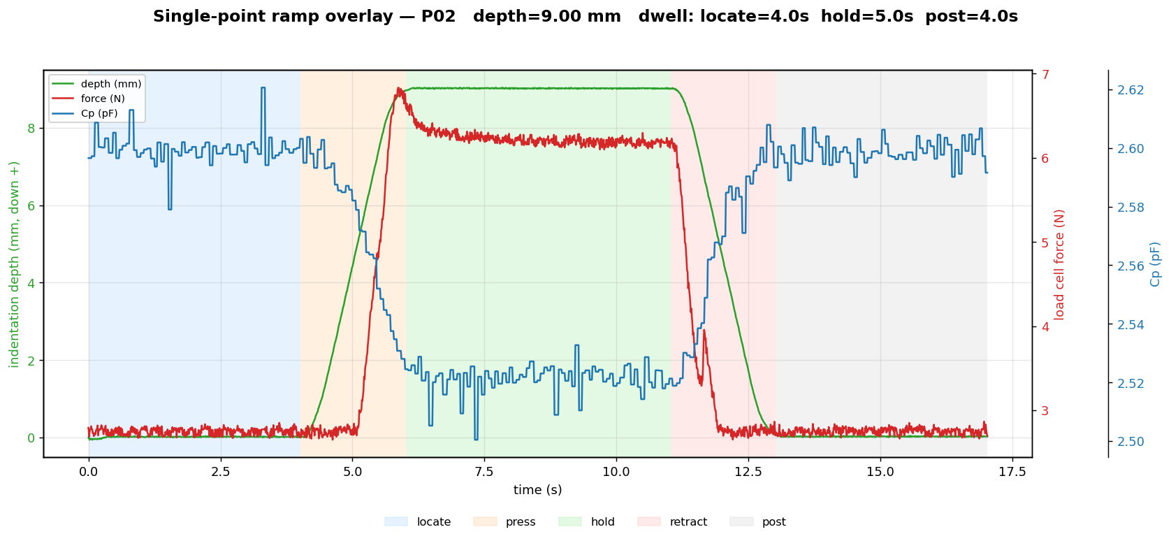
Capacitance_measurement/plots/single_point_ramp_overlay_P02_20260625_150843.png
