Jonasjcmh/Star_nose_sensor/Capacitance_measurement/plots/single_point_ramp_overlay_P12_20260717_140412.png

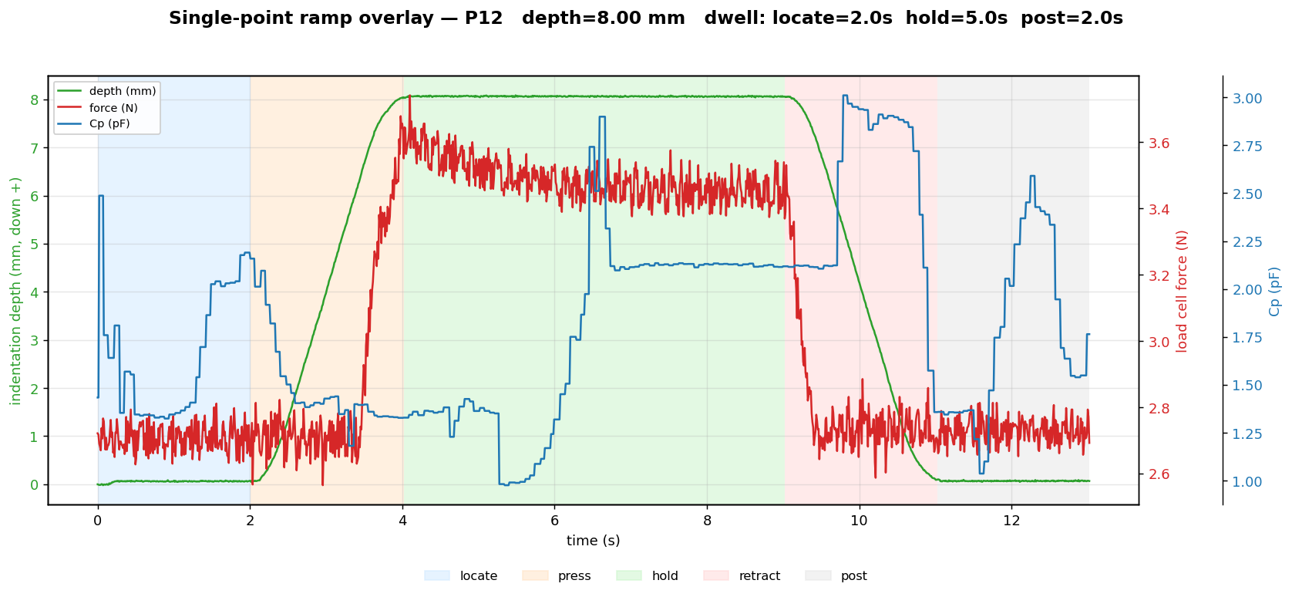
Capacitance_measurement/plots/single_point_ramp_overlay_P12_20260717_140412.png
