Jonasjcmh/Star_nose_sensor/Capacitance_measurement/plots/single_point_ramp_P01_20260717_141347.png

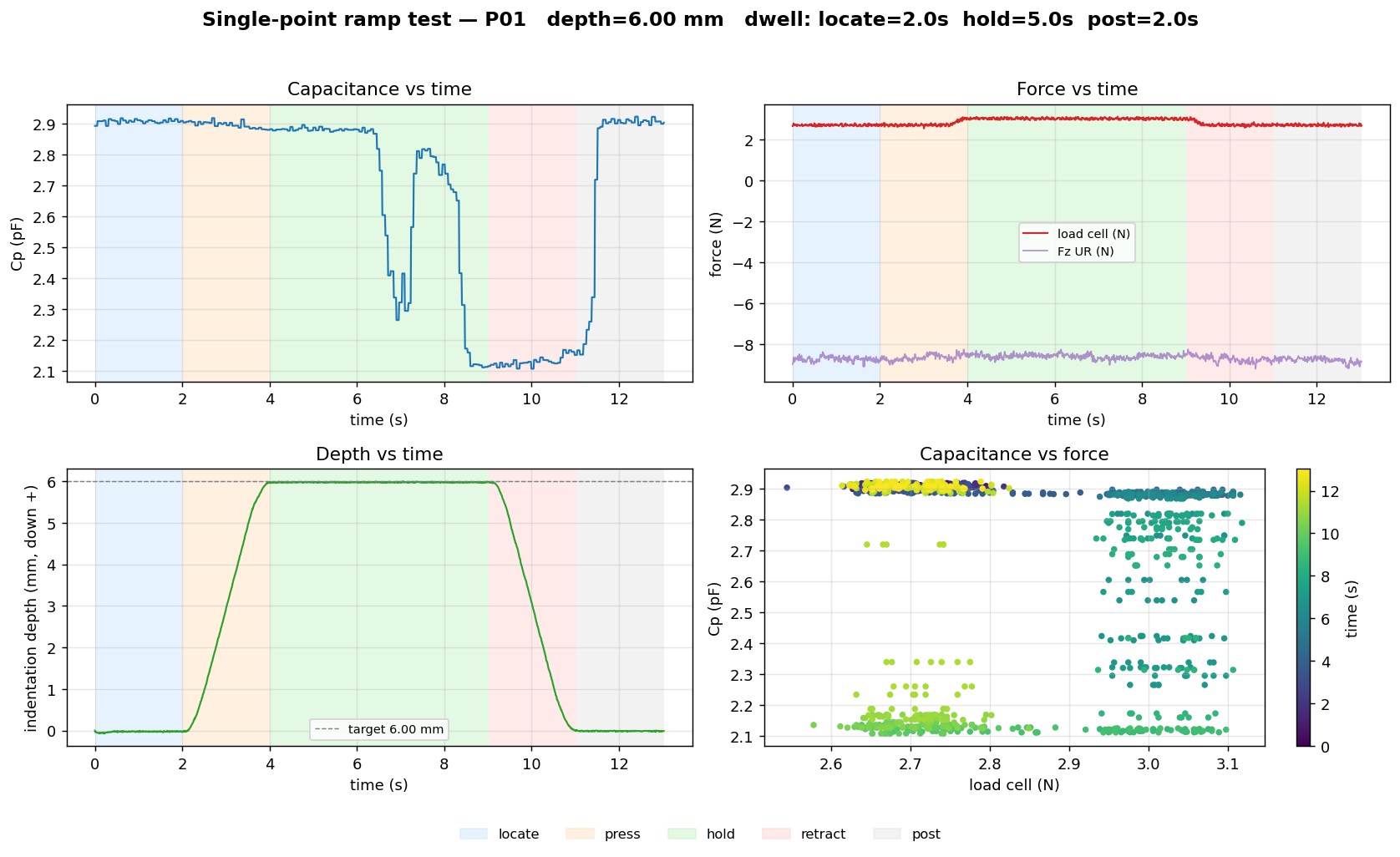
Capacitance_measurement/plots/single_point_ramp_P01_20260717_141347.png
