Jonasjcmh/Star_nose_sensor/Capacitance_measurement/plots/single_point_ramp_P01_20260717_155040.png

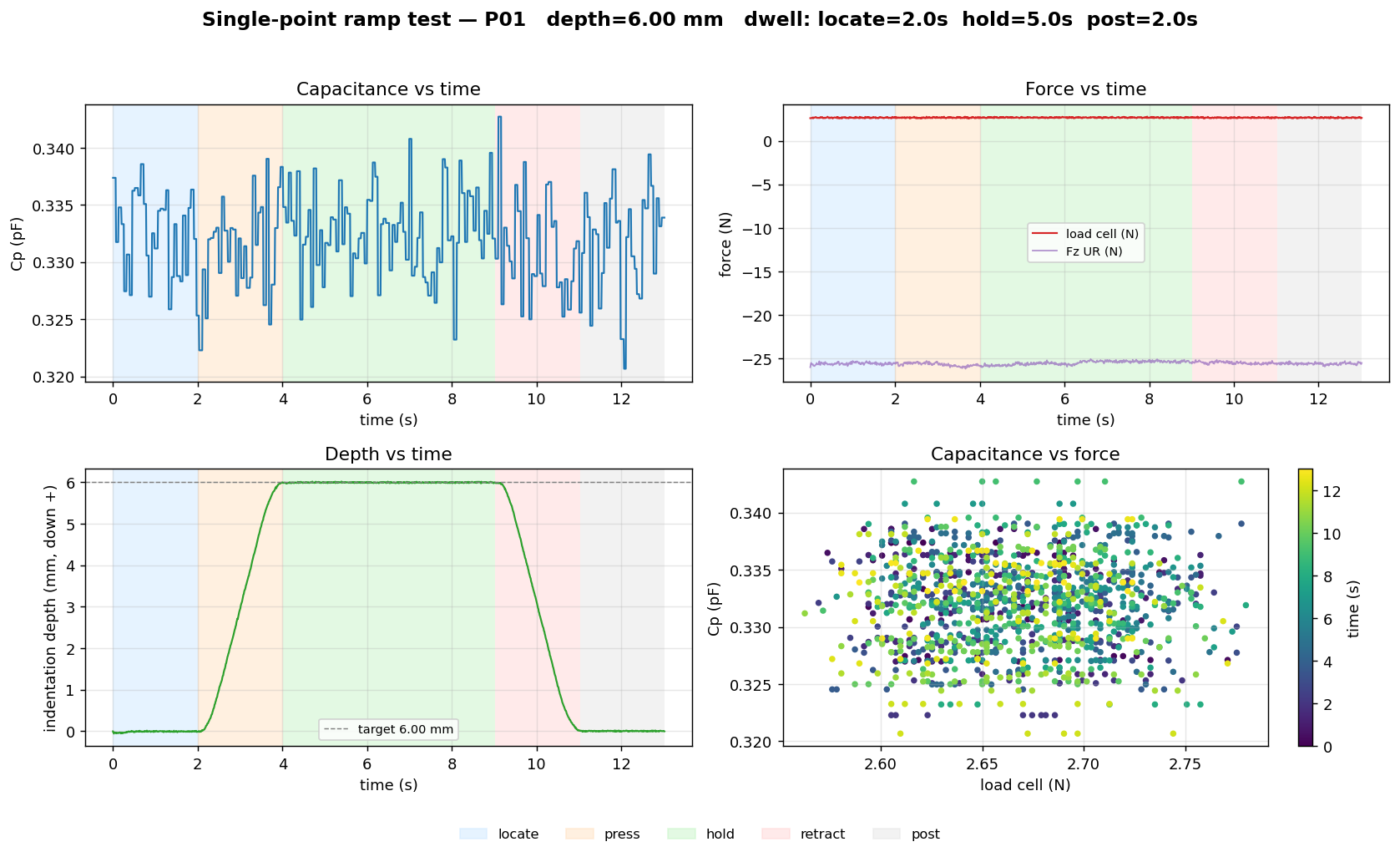
Capacitance_measurement/plots/single_point_ramp_P01_20260717_155040.png
