Jonasjcmh/Star_nose_sensor/Capacitance_measurement/plots/single_point_ramp_P10_20260625_150555.png

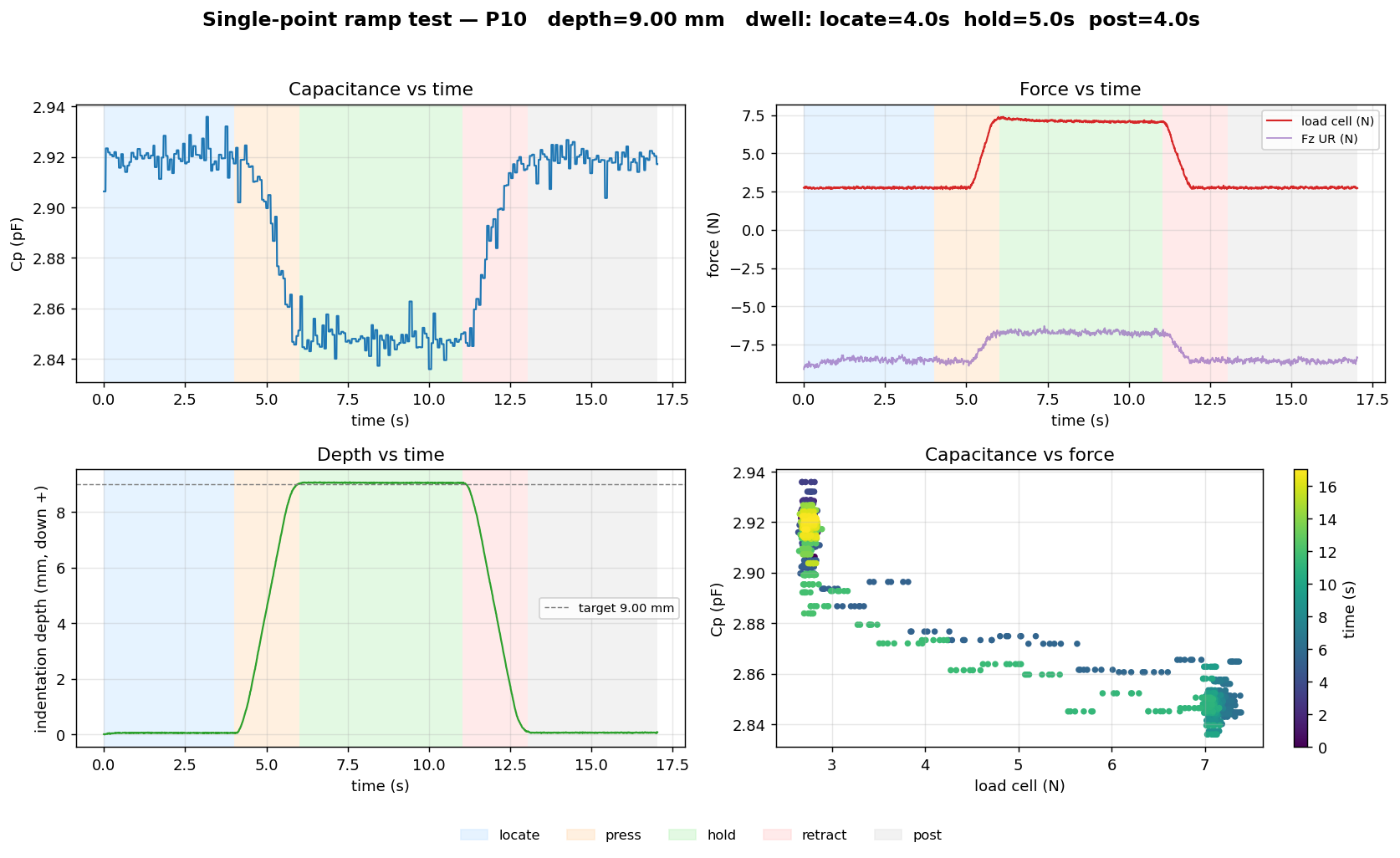
Capacitance_measurement/plots/single_point_ramp_P10_20260625_150555.png
