Jonasjcmh/Star_nose_sensor/Capacitance_measurement/plots/twopt_p08_p19_flat/P08_iterations_overlaid.png

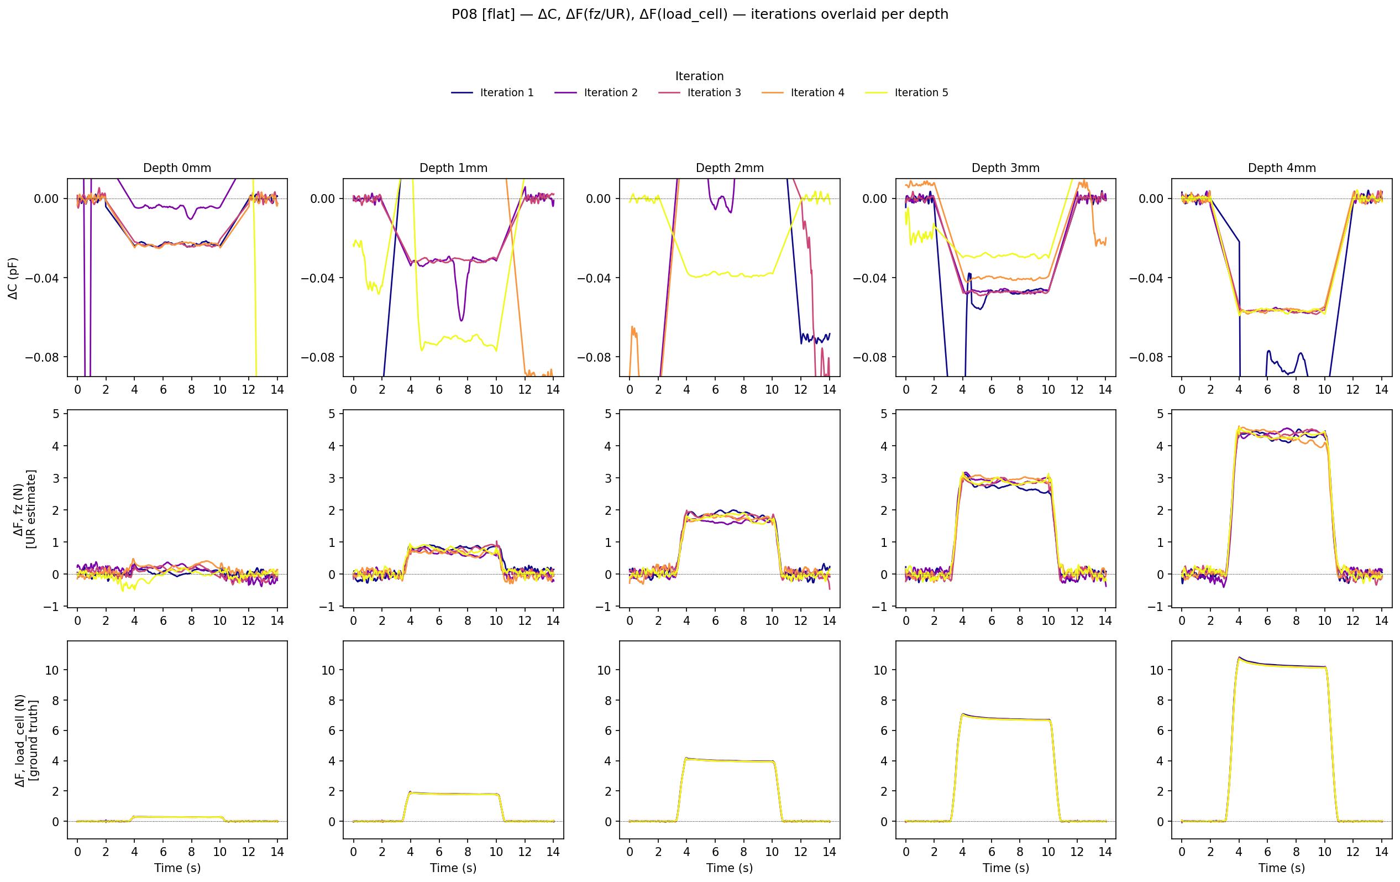
Capacitance_measurement/plots/twopt_p08_p19_flat/P08_iterations_overlaid.png
