Jonasjcmh/Star_nose_sensor/Capacitance_measurement/plots/twopt_two_point_iterations_P01_P03_20260805_191724/depth_response_dcp.png

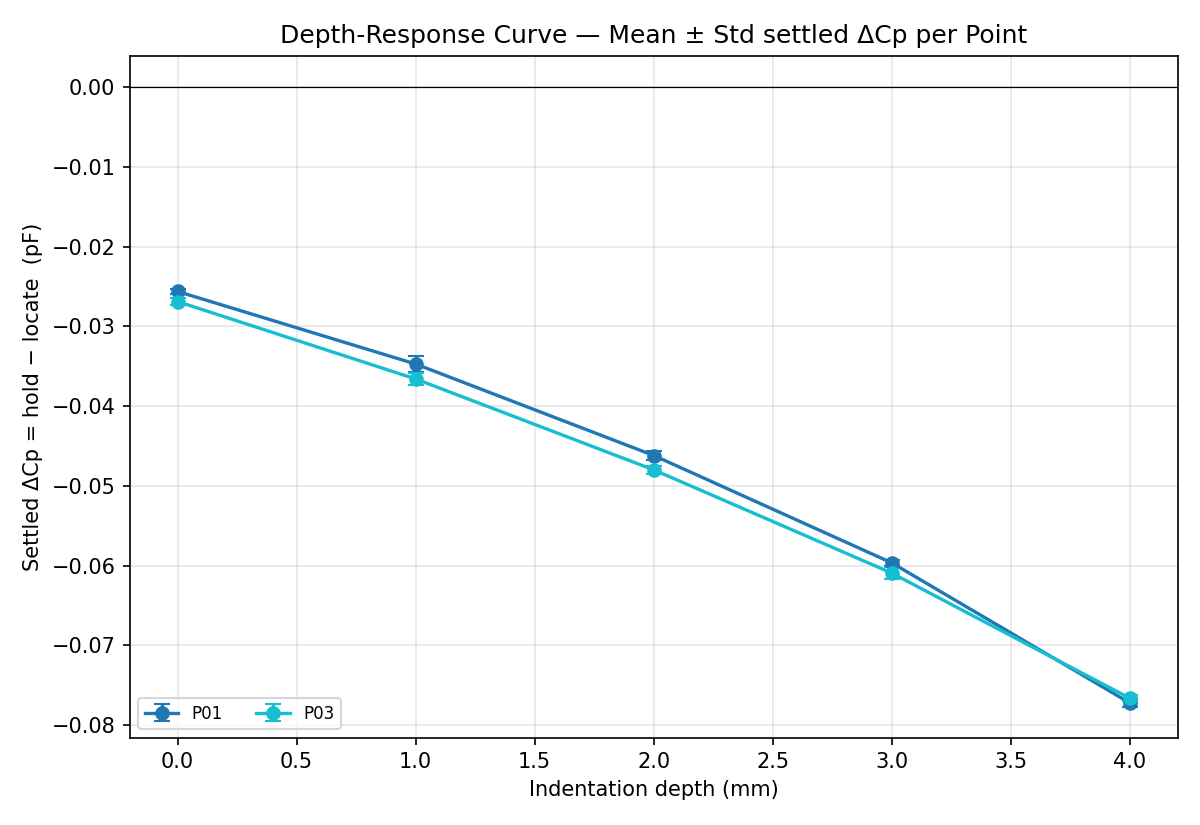
Capacitance_measurement/plots/twopt_two_point_iterations_P01_P03_20260805_191724/depth_response_dcp.png
