Jonasjcmh/Star_nose_sensor/Capacitance_measurement/plots/twopt_two_point_iterations_P01_P03_20260805_191724/force_dcp_scatter.png

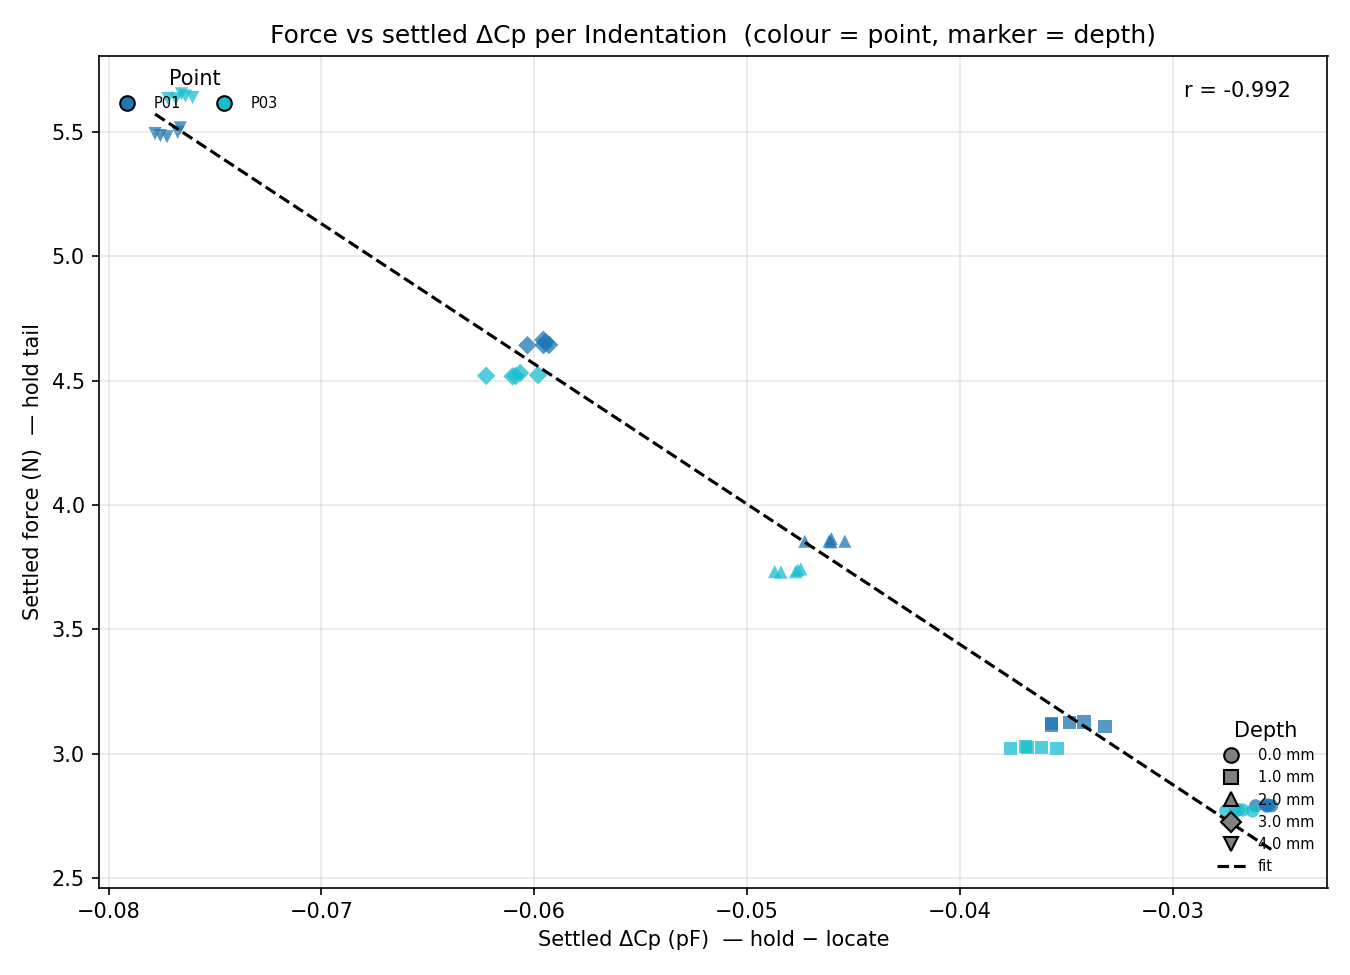
Capacitance_measurement/plots/twopt_two_point_iterations_P01_P03_20260805_191724/force_dcp_scatter.png
