Jonasjcmh/Star_nose_sensor/Capacitance_measurement/plots/twopt_two_point_iterations_P10_20260805_183614/sensor_map_dcp.png

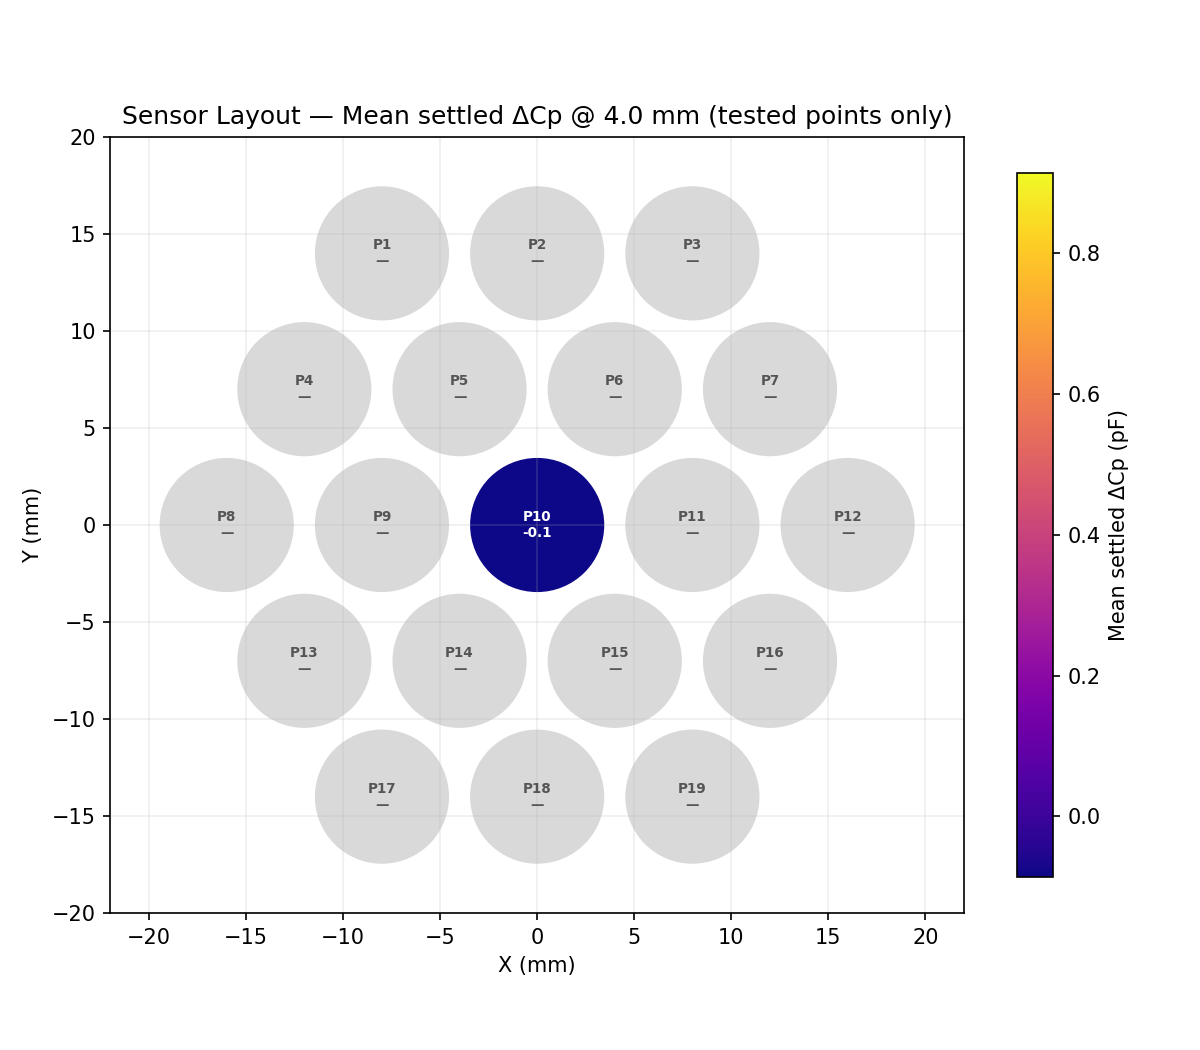
Capacitance_measurement/plots/twopt_two_point_iterations_P10_20260805_183614/sensor_map_dcp.png
