Jonasjcmh/Star_nose_sensor/Capacitance_measurement/plots/twopt_two_point_iterations_P10_P03_P14_20260804_171210_new_hollow/point14_detail_grid.png

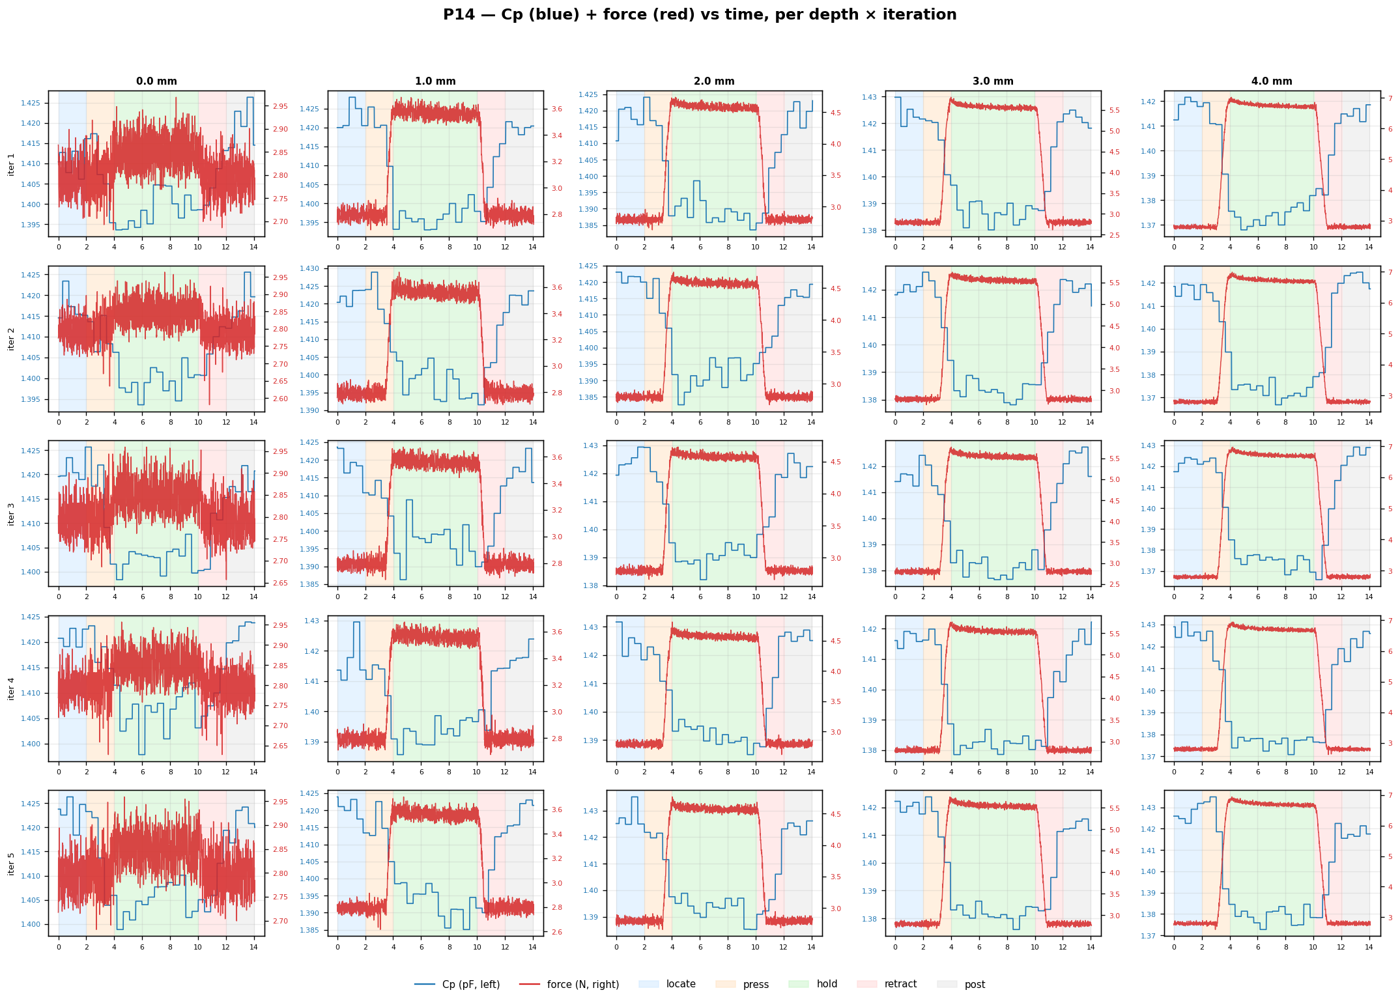
Capacitance_measurement/plots/twopt_two_point_iterations_P10_P03_P14_20260804_171210_new_hollow/point14_detail_grid.png
