Jonasjcmh/Star_nose_sensor/Capacitance_measurement/plots/twopt_two_point_iterations_P14_20260805_184910/depth_response_force.png

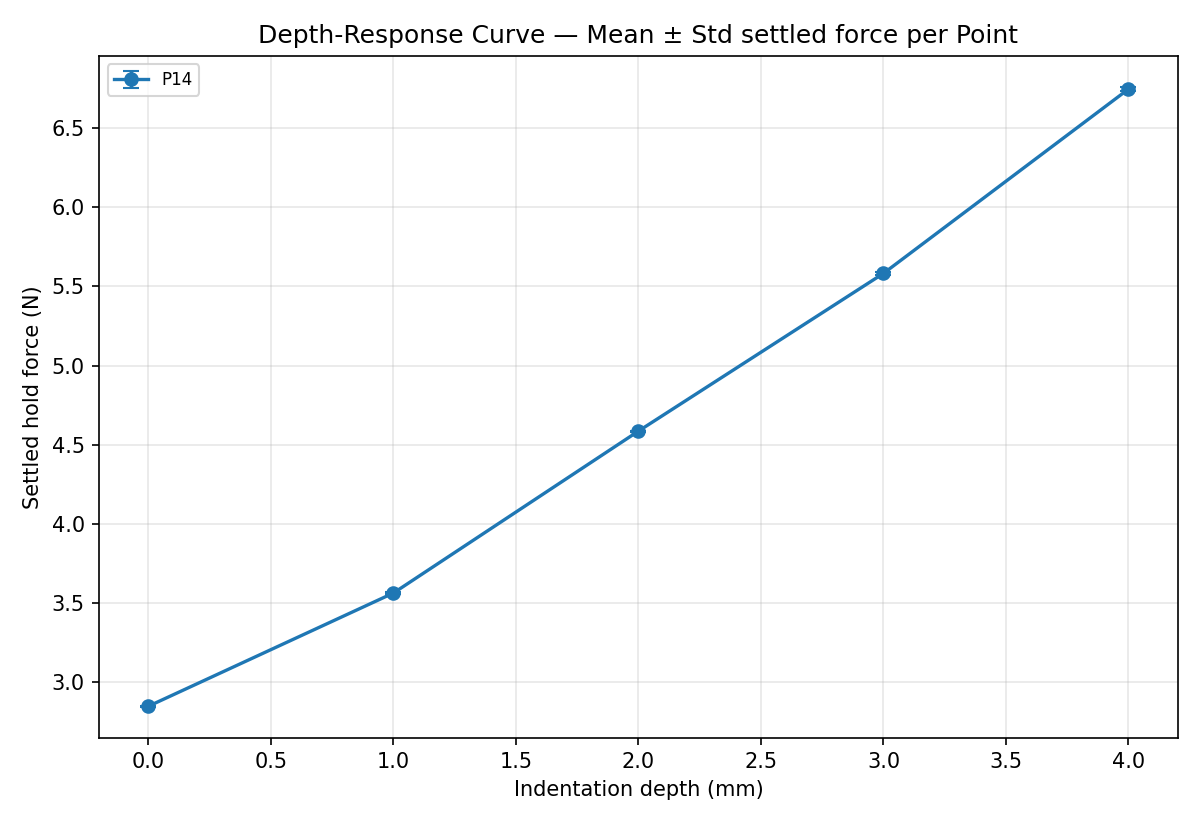
Capacitance_measurement/plots/twopt_two_point_iterations_P14_20260805_184910/depth_response_force.png
