Jonasjcmh/Star_nose_sensor/Capacitance_measurement/plots/twopt_two_point_iterations_P14_20260805_184910/force_dcp_scatter.png

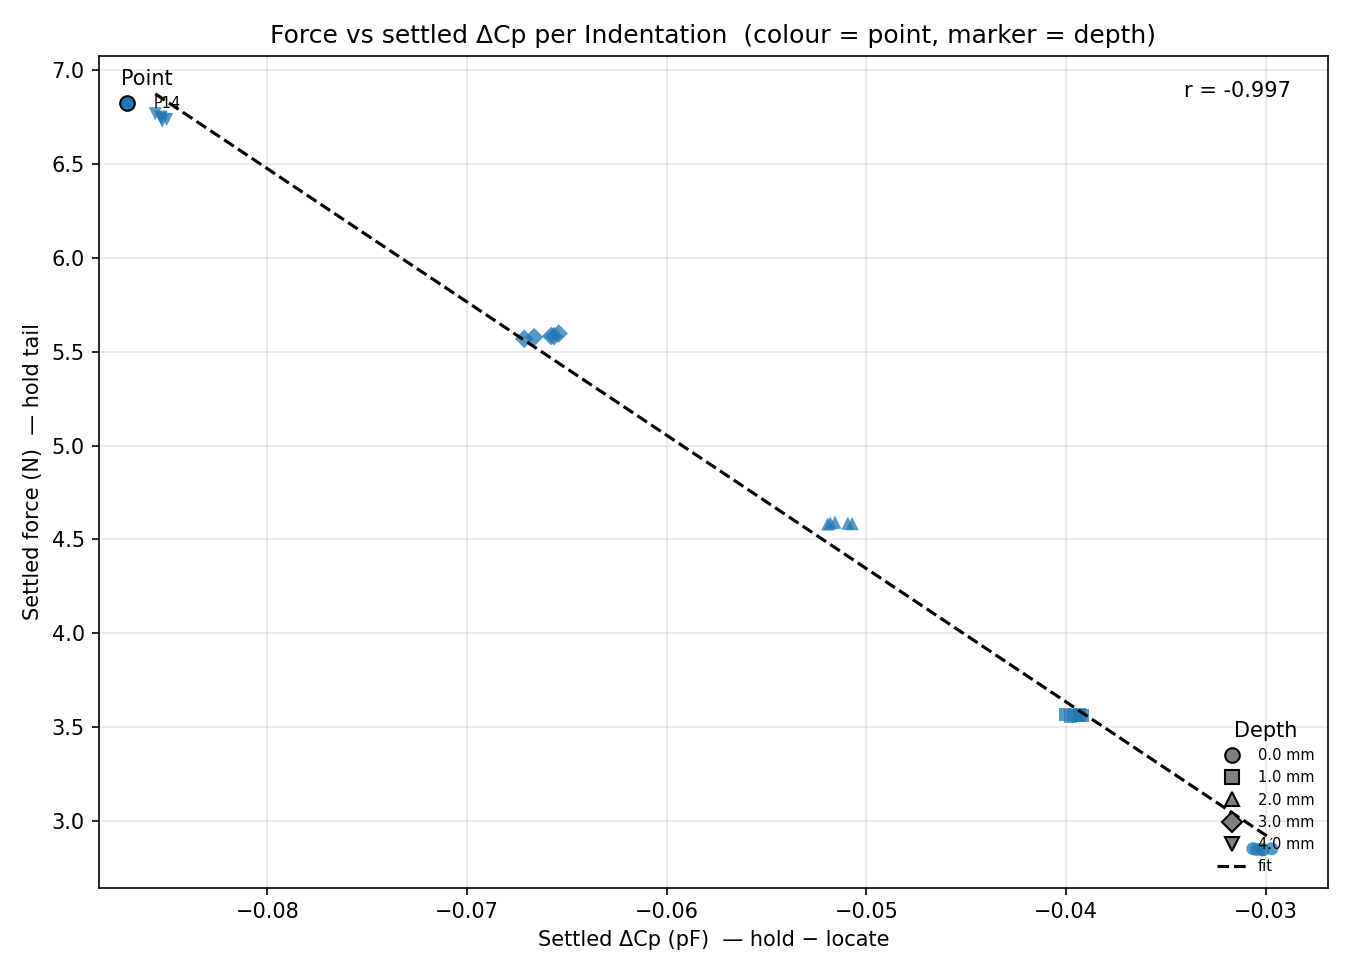
Capacitance_measurement/plots/twopt_two_point_iterations_P14_20260805_184910/force_dcp_scatter.png
