Jonasjcmh/Star_nose_sensor/Capacitance_measurement/plots_two_point_iterations/P08_flat.png

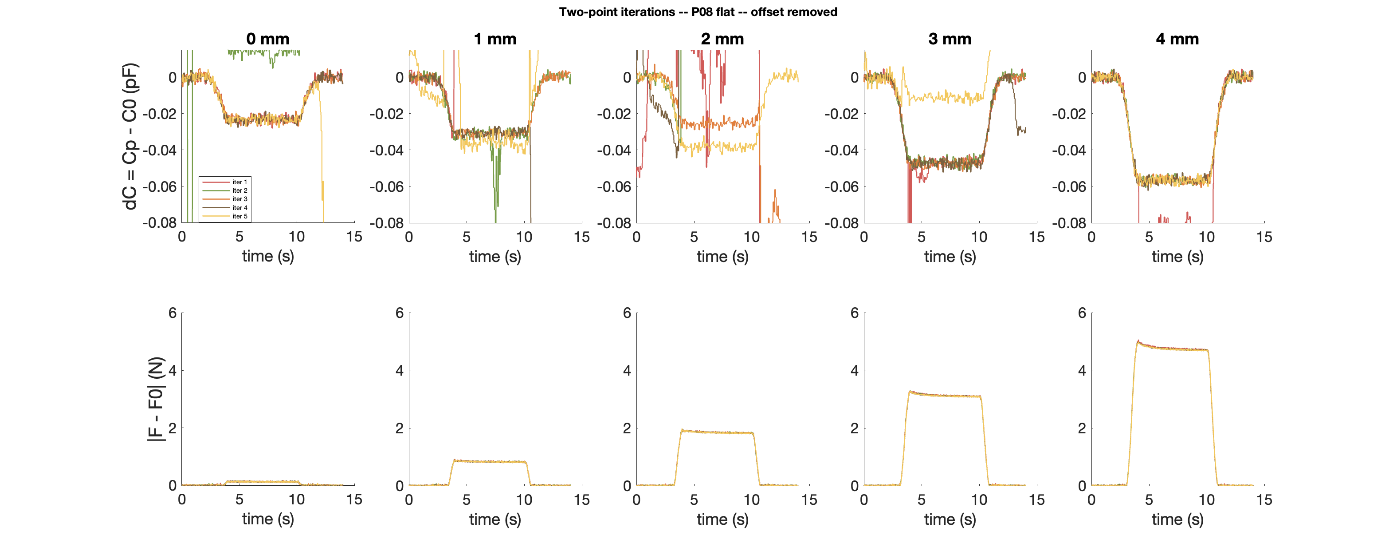
Capacitance_measurement/plots_two_point_iterations/P08_flat.png
