Jonasjcmh/Star_nose_sensor/Capacitance_measurement/plots_two_point_iterations_deltaC_over_C0/P19_hollow.png

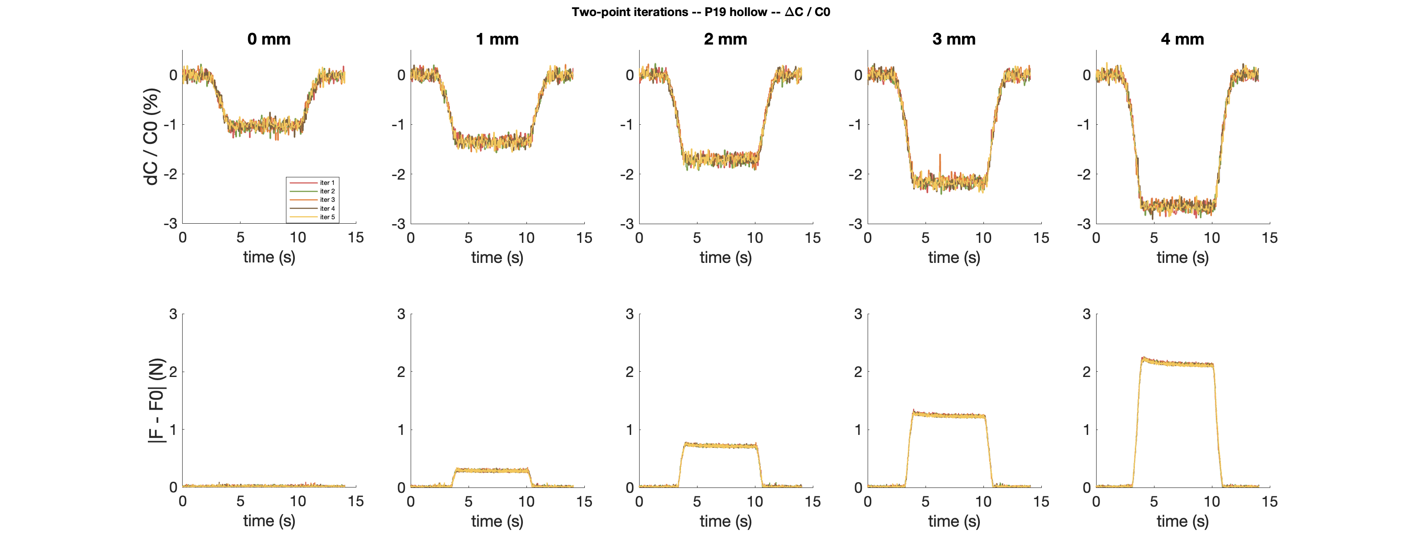
Capacitance_measurement/plots_two_point_iterations_deltaC_over_C0/P19_hollow.png
