Jonasjcmh/Star_nose_sensor/fig2_electrical_characterisation.png

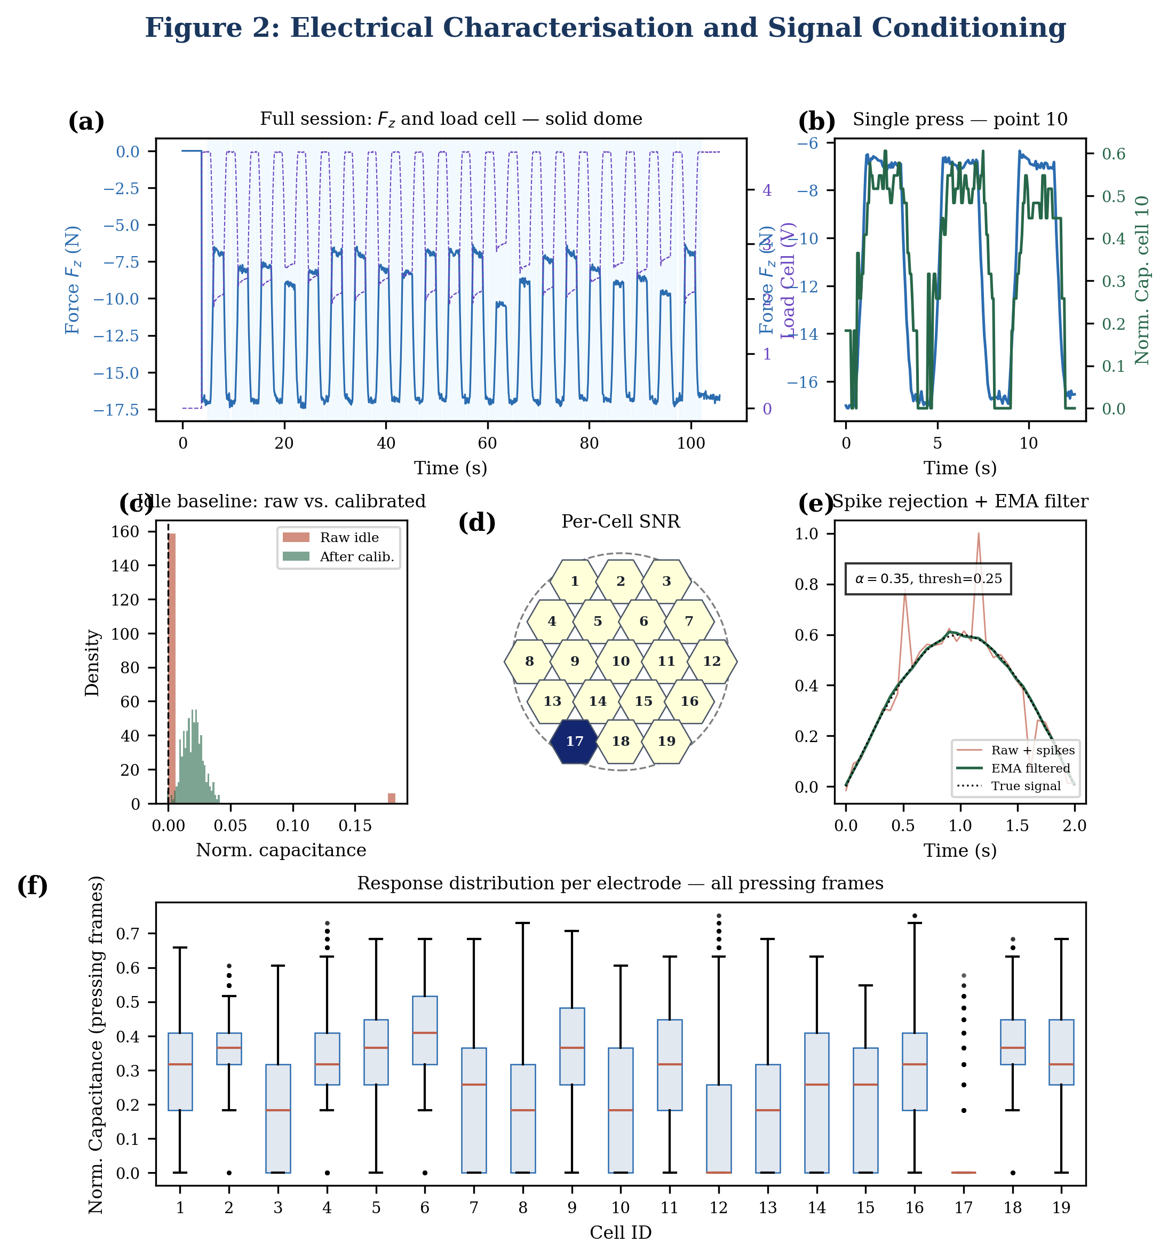
fig2_electrical_characterisation.png
