Jonasjcmh/Star_nose_sensor/fig3_mechanical_characterisation.png

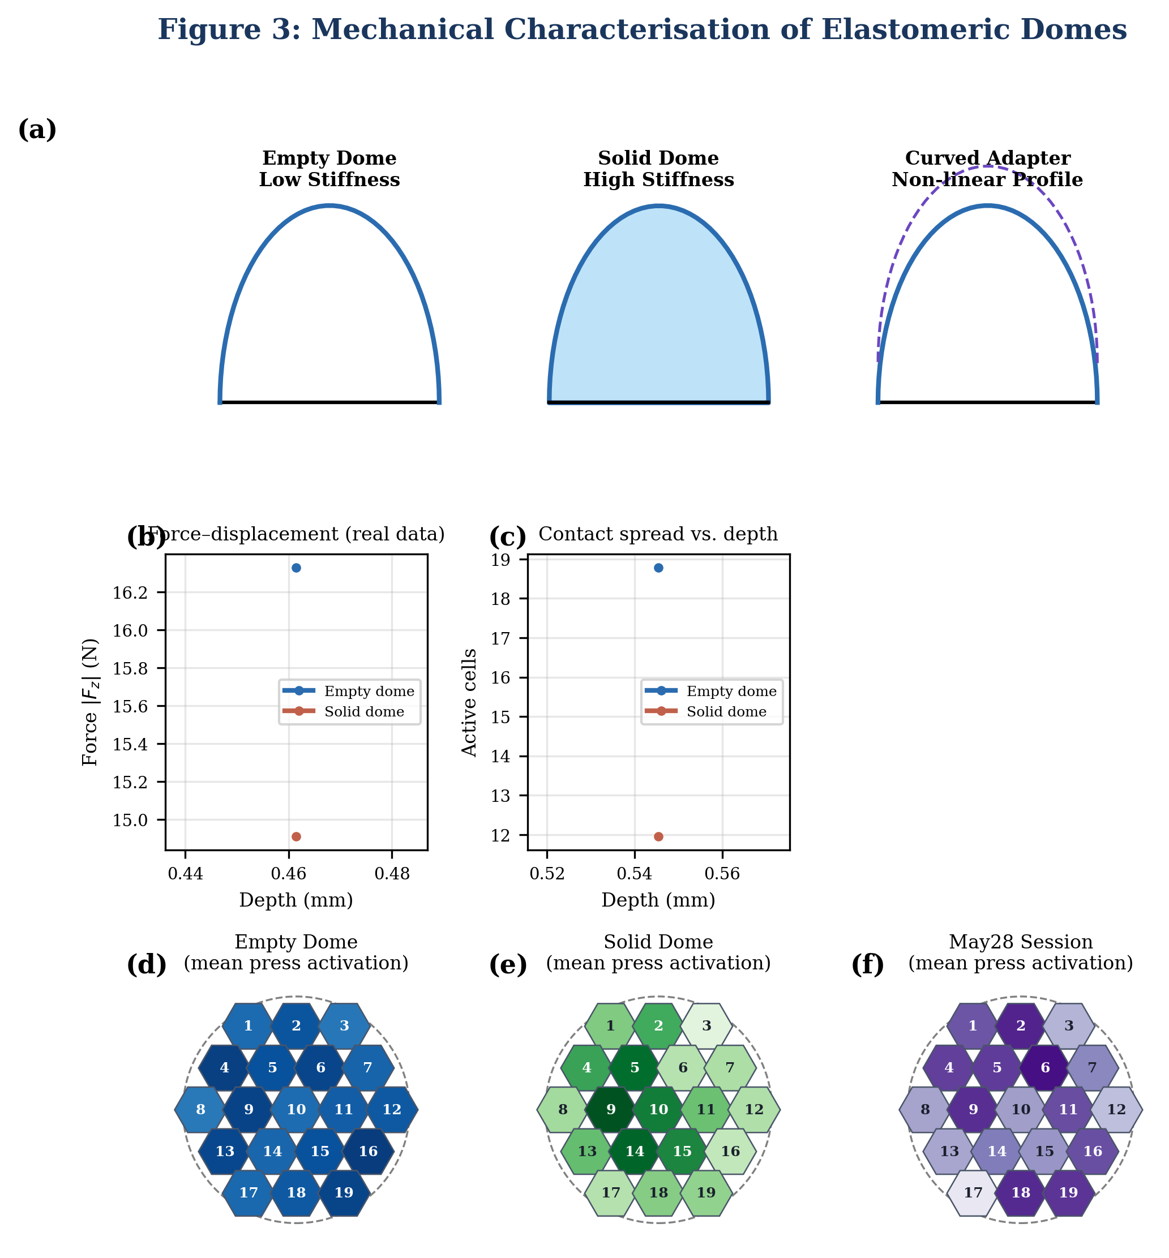
fig3_mechanical_characterisation.png
