Jonasjcmh/Star_nose_sensor/force_sensor_calibration/plots/force_vs_ai0.png

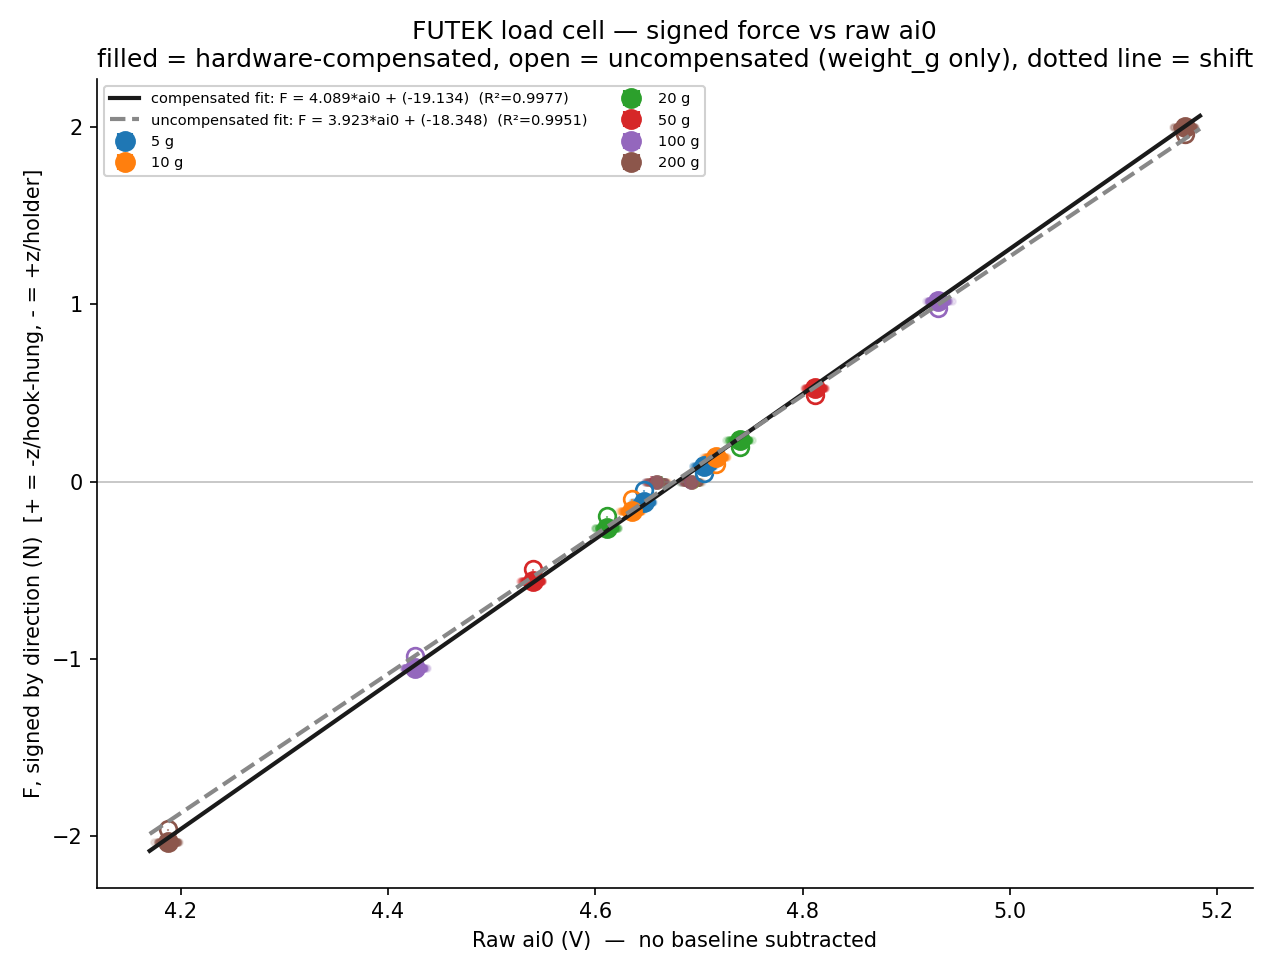
force_sensor_calibration/plots/force_vs_ai0.png
