Jonasjcmh/Star_nose_sensor/force_sensor_calibration/plots/fresultant_vs_fz.png

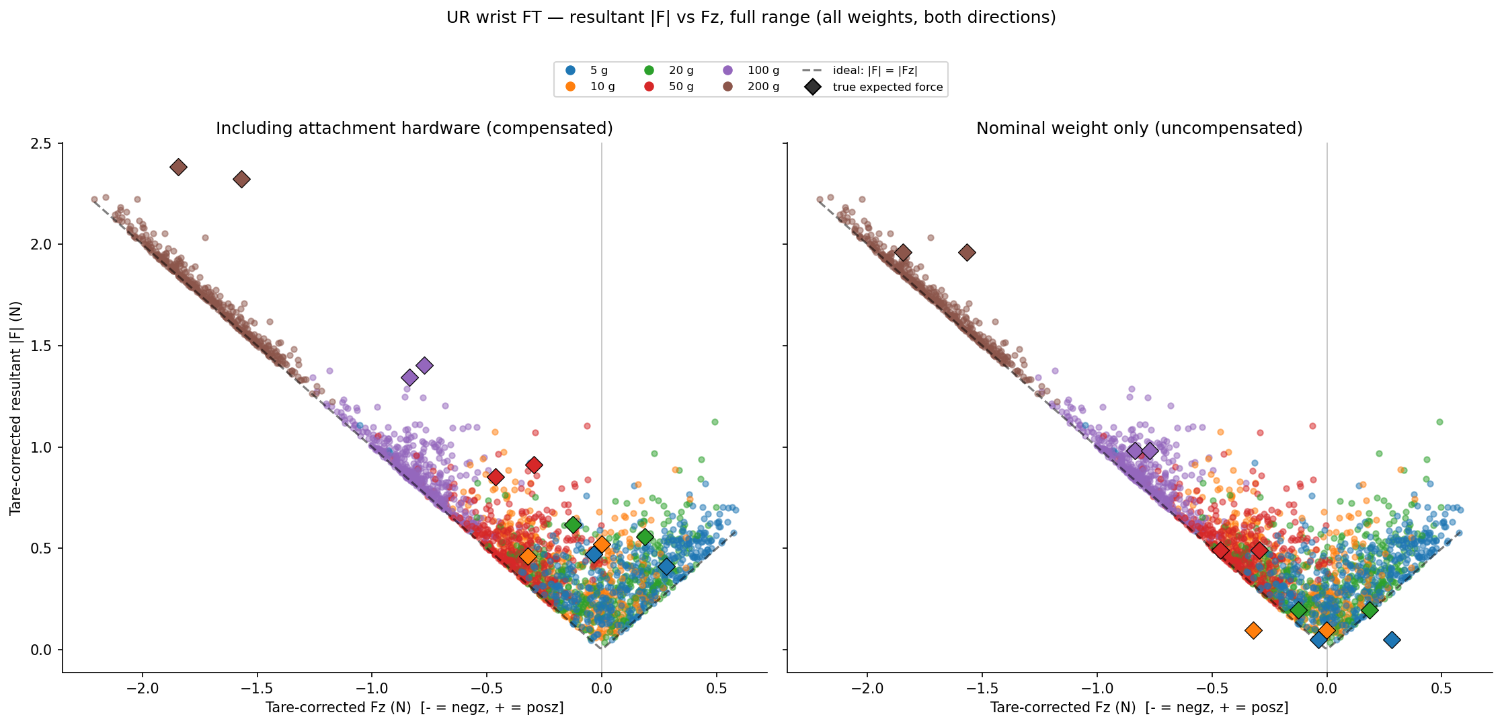
force_sensor_calibration/plots/fresultant_vs_fz.png
