Jonasjcmh/Star_nose_sensor/force_sensor_calibration/plots/fur_vs_flc.png

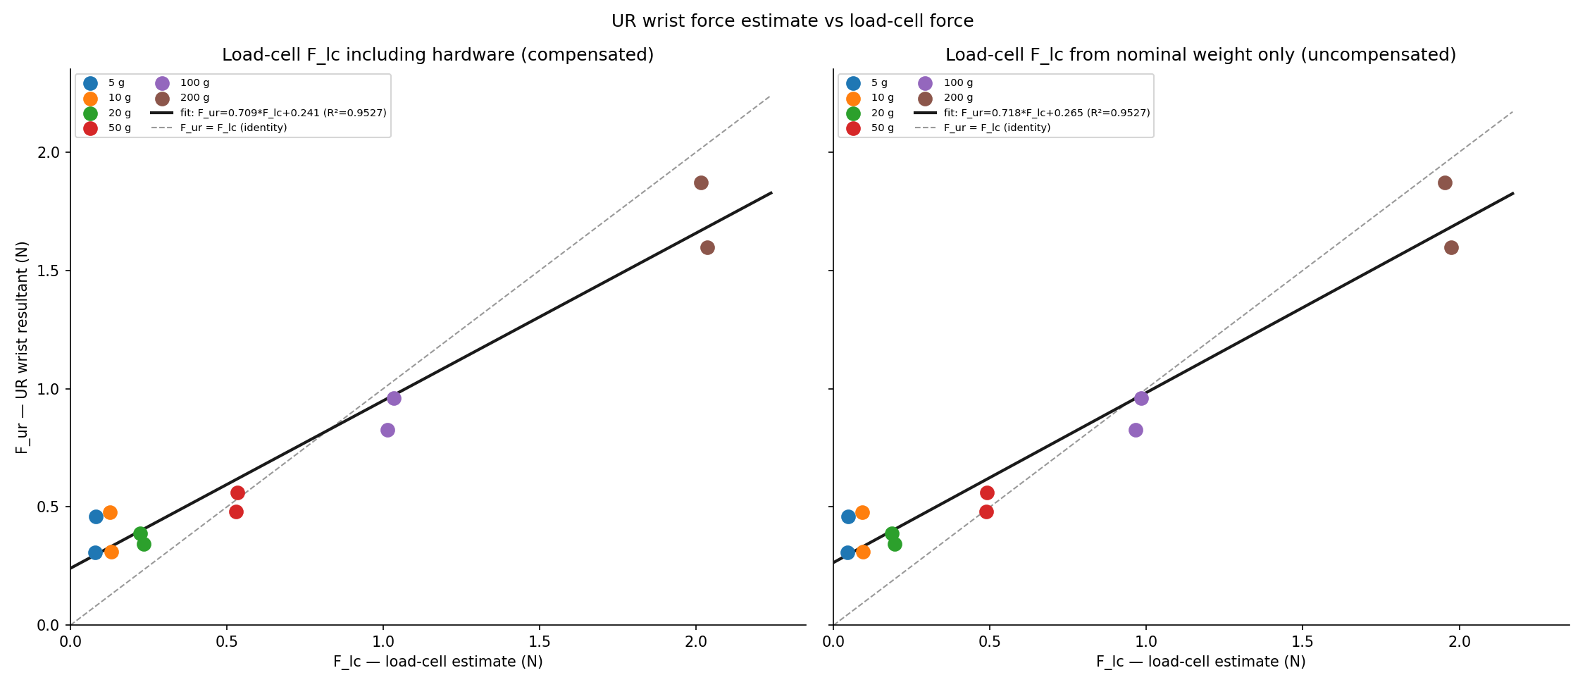
force_sensor_calibration/plots/fur_vs_flc.png
