Jonasjcmh/Star_nose_sensor/force_sensor_calibration/plots/futek_direct_signals_vs_time_matlab.png

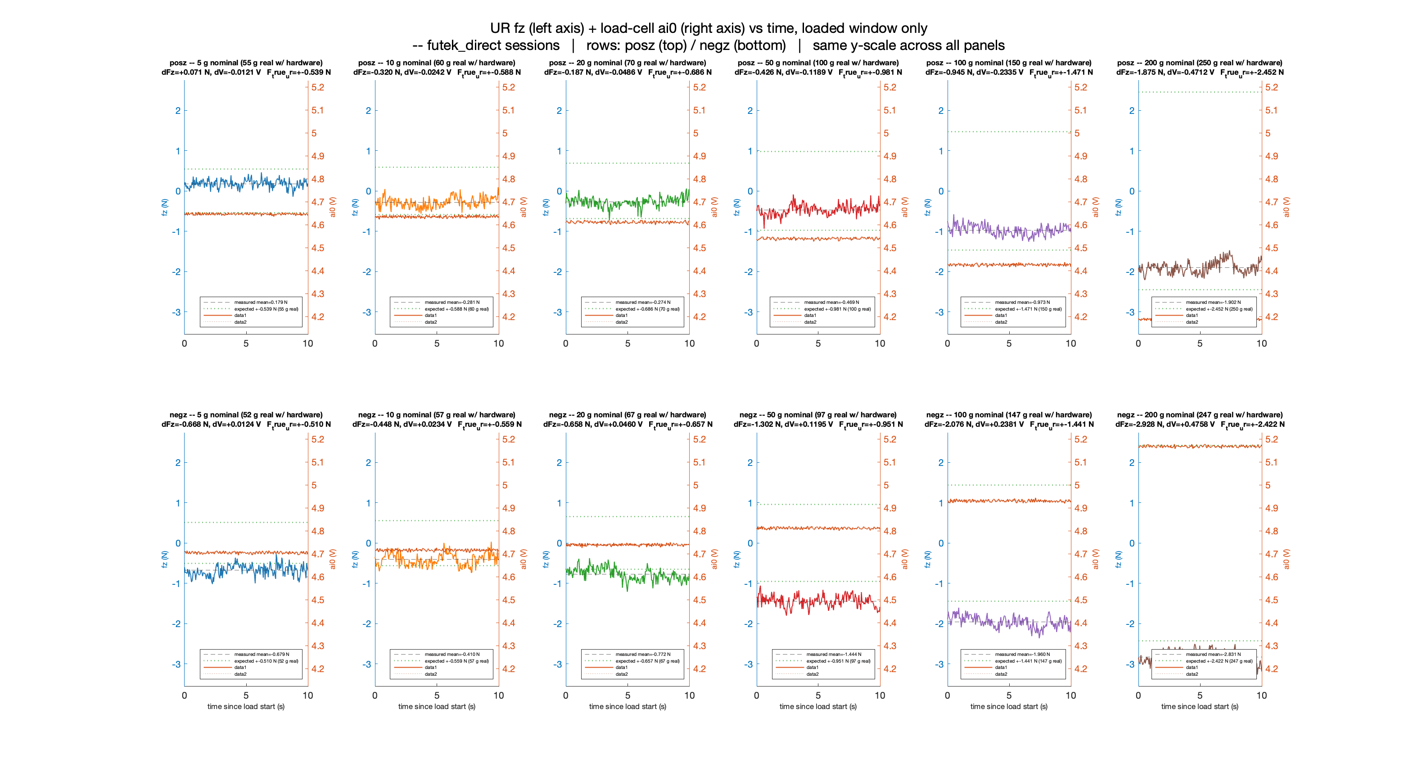
force_sensor_calibration/plots/futek_direct_signals_vs_time_matlab.png
