Jonasjcmh/Star_nose_sensor/force_sensor_calibration/plots/lc_linearization.png

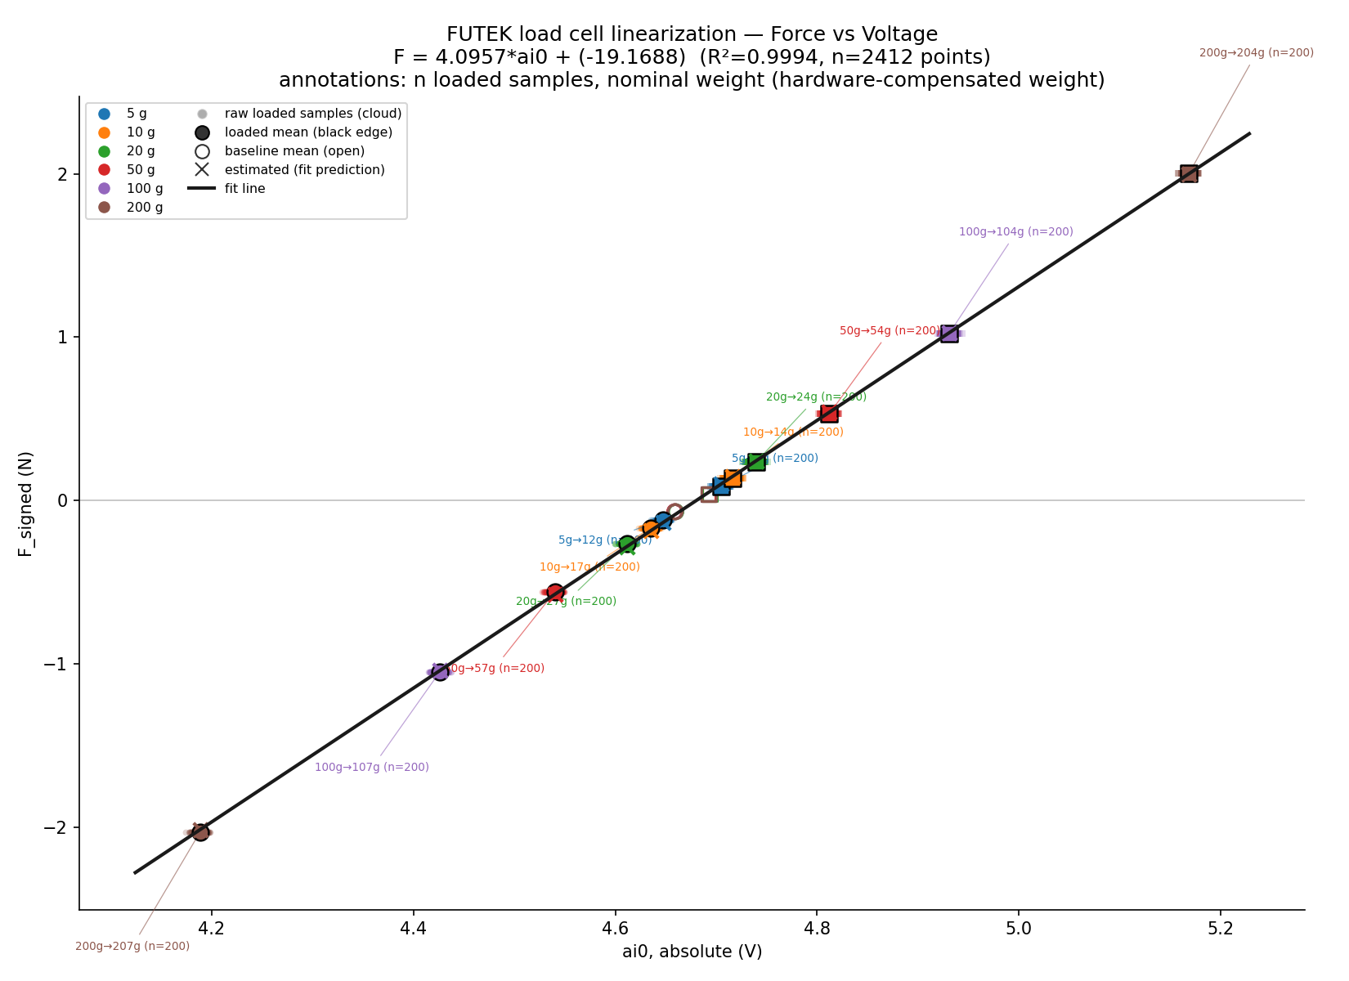
force_sensor_calibration/plots/lc_linearization.png
