Jonasjcmh/Star_nose_sensor/force_sensor_calibration/plots/lc_linearization_matlab.png

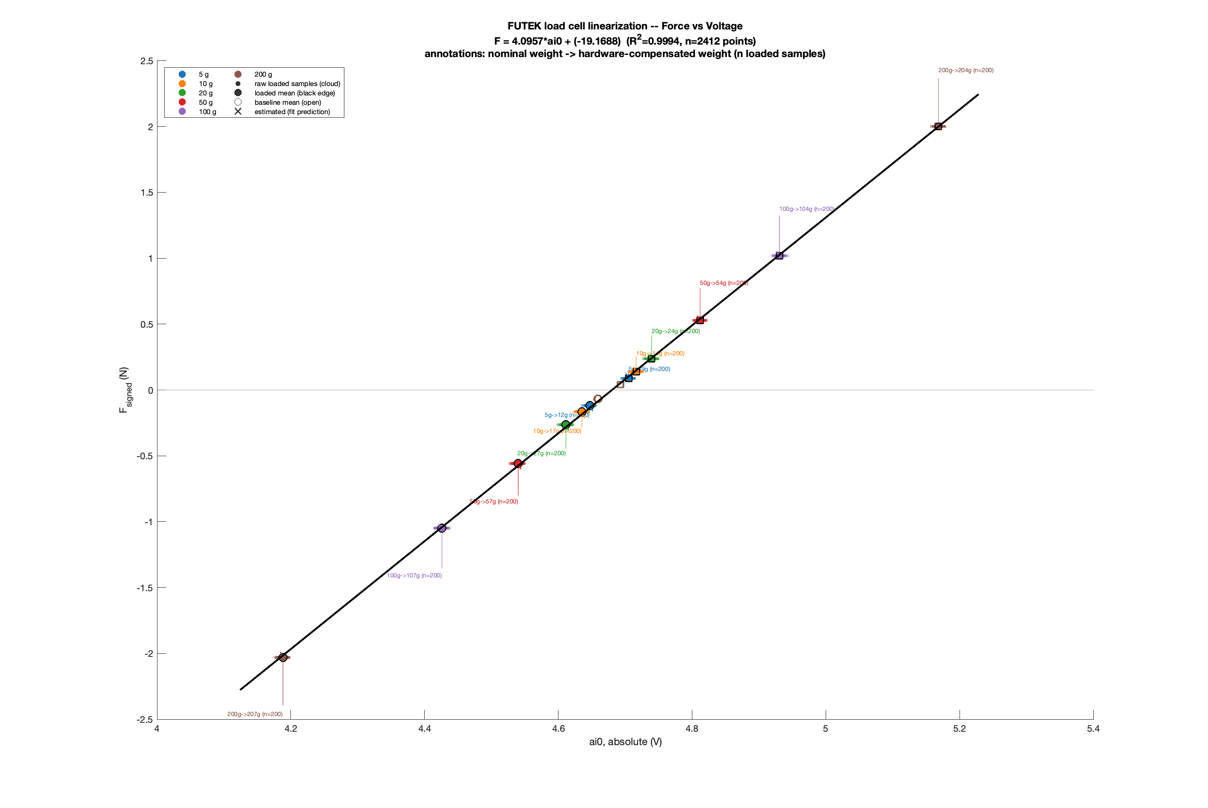
force_sensor_calibration/plots/lc_linearization_matlab.png
