Jonasjcmh/Star_nose_sensor/force_sensor_calibration/plots/lc_ur_calibration_fit_matlab.png

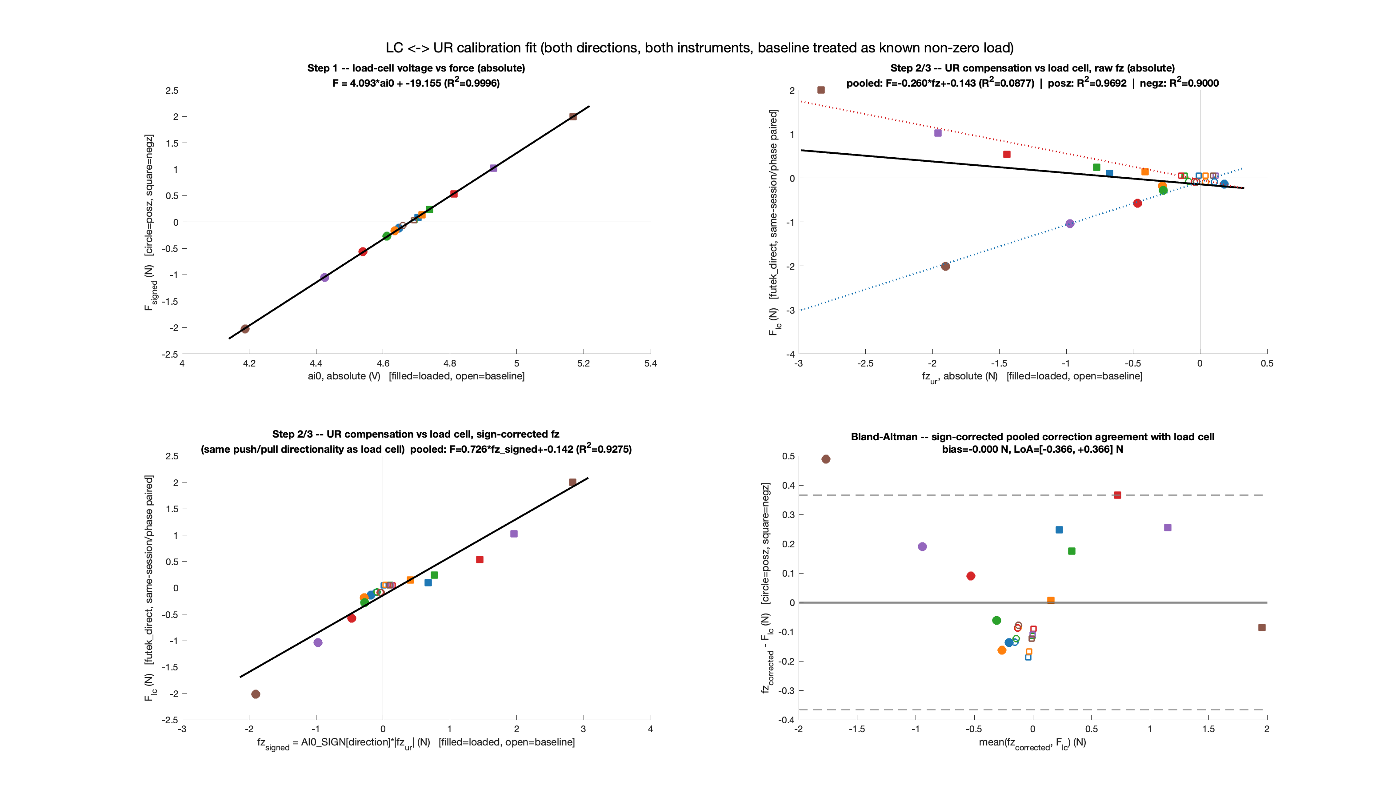
force_sensor_calibration/plots/lc_ur_calibration_fit_matlab.png
