Jonasjcmh/Star_nose_sensor/force_sensor_calibration/plots/lc_ur_calibration_step1_voltage_force.png

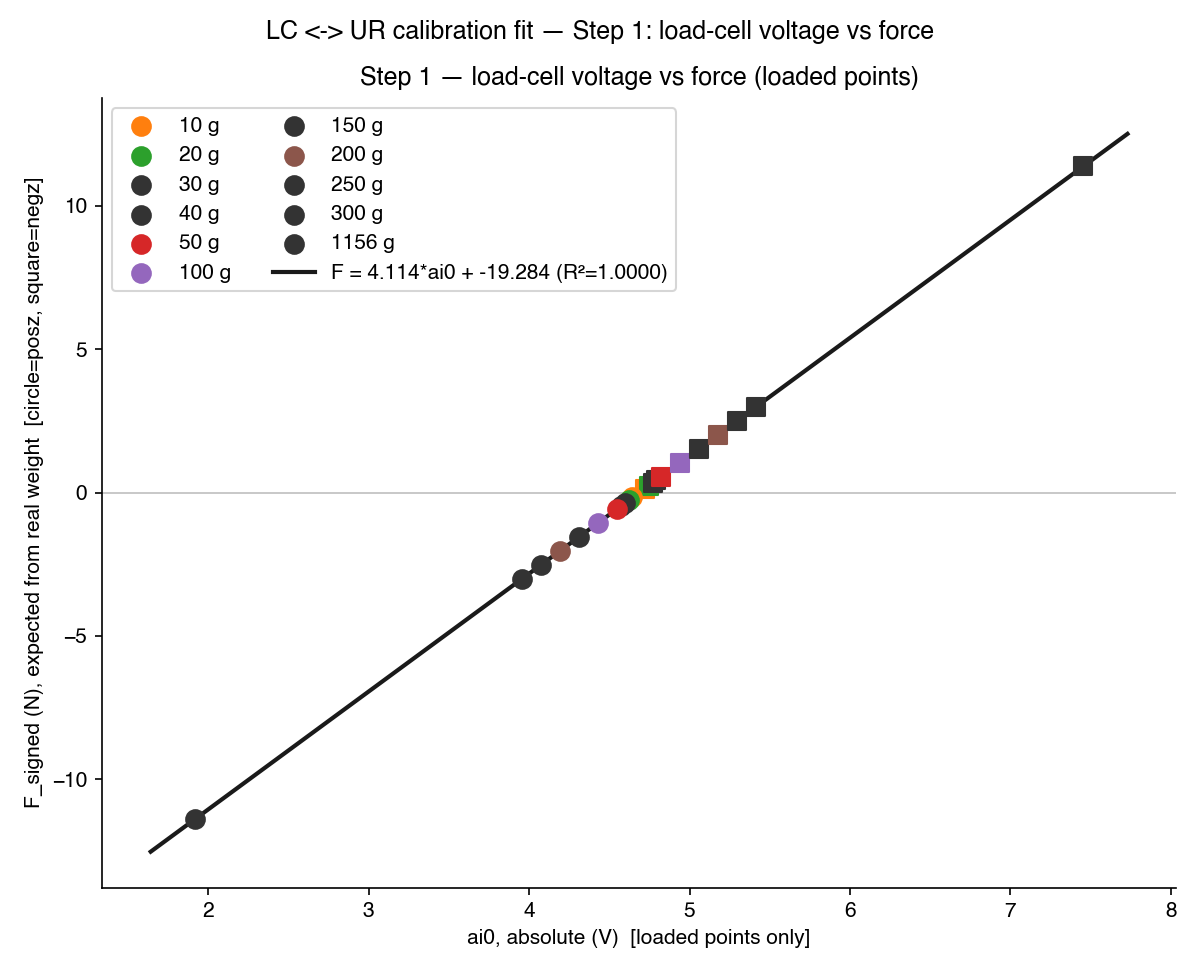
force_sensor_calibration/plots/lc_ur_calibration_step1_voltage_force.png
