Jonasjcmh/Star_nose_sensor/force_sensor_calibration/plots/lc_ur_calibration_step2_raw_fz.png

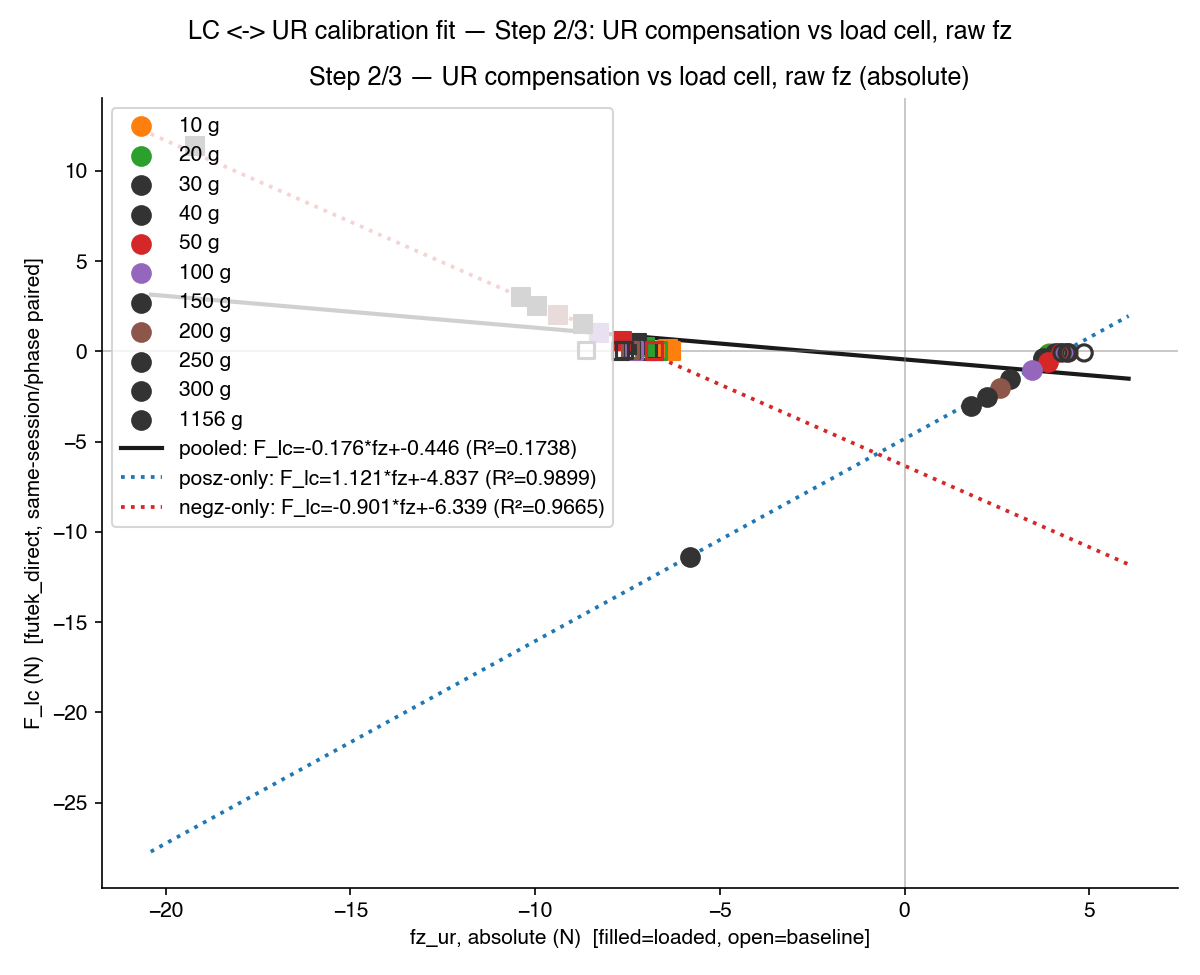
force_sensor_calibration/plots/lc_ur_calibration_step2_raw_fz.png
