Jonasjcmh/Star_nose_sensor/force_sensor_calibration/plots/lc_ur_calibration_step3_signed_fz_matlab.png

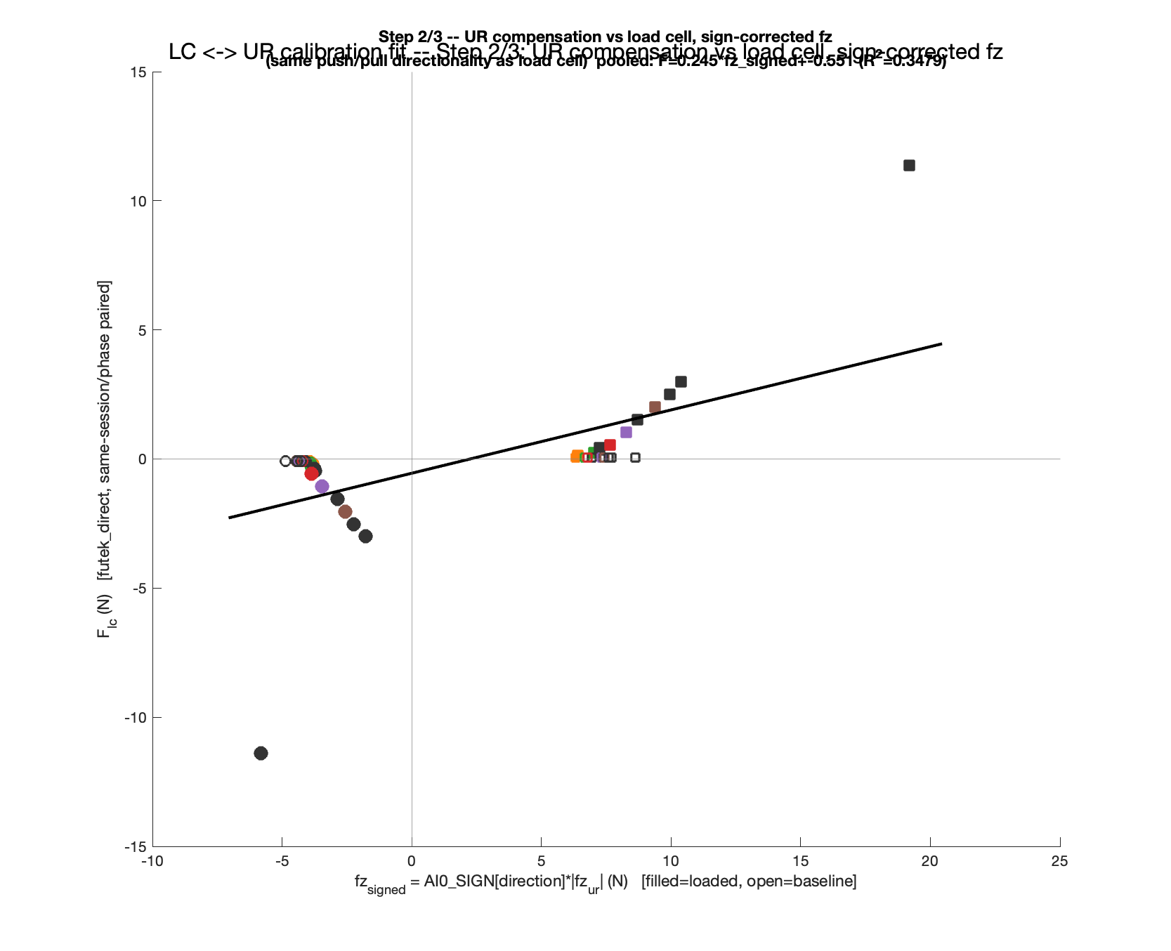
force_sensor_calibration/plots/lc_ur_calibration_step3_signed_fz_matlab.png
