Jonasjcmh/Star_nose_sensor/force_sensor_calibration/plots/lc_ur_calibration_step4_bland_altman.png

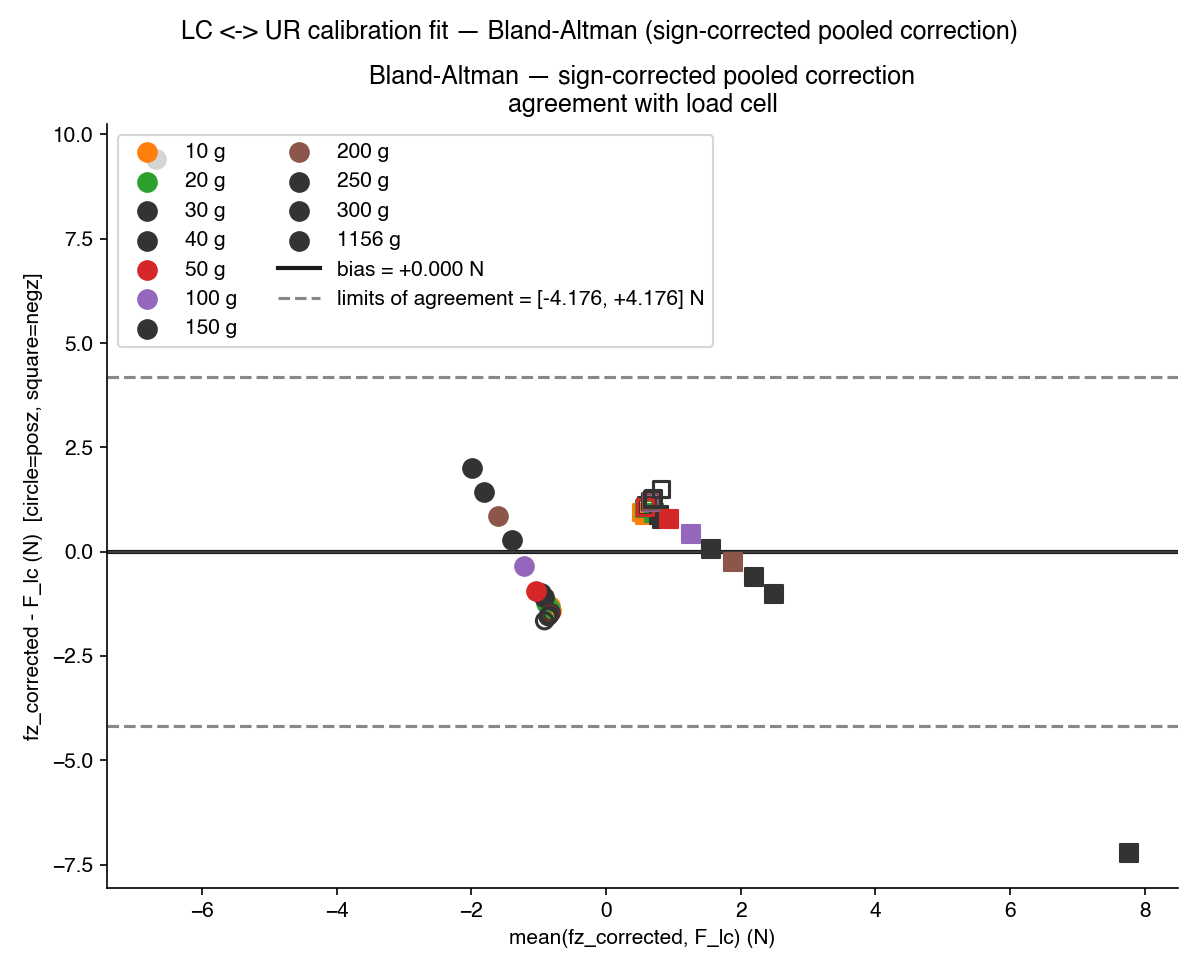
force_sensor_calibration/plots/lc_ur_calibration_step4_bland_altman.png
