Jonasjcmh/Star_nose_sensor/force_sensor_calibration/plots/lc_ur_force_vs_time.png

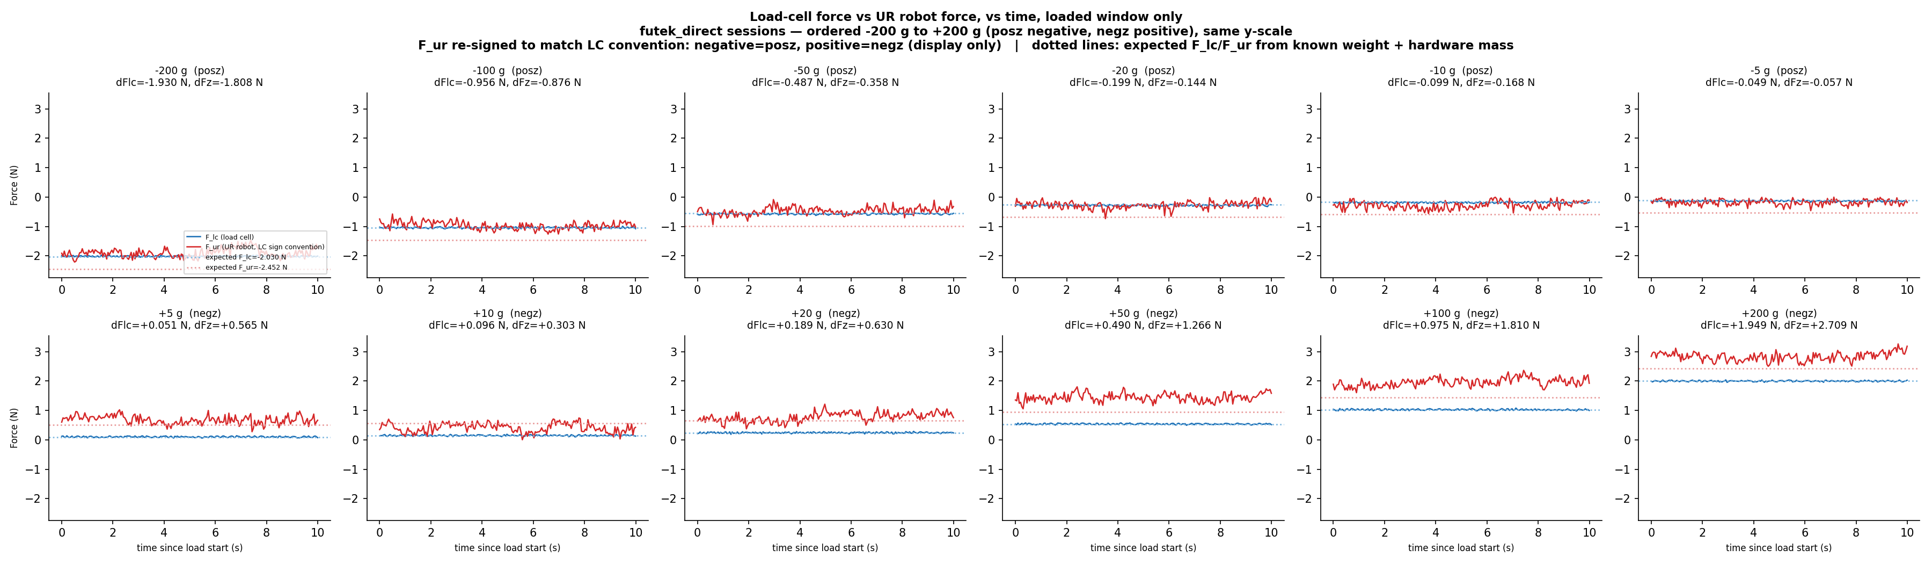
force_sensor_calibration/plots/lc_ur_force_vs_time.png
