Jonasjcmh/Star_nose_sensor/force_sensor_calibration/plots/lc_vs_ur_by_weight_matlab.png

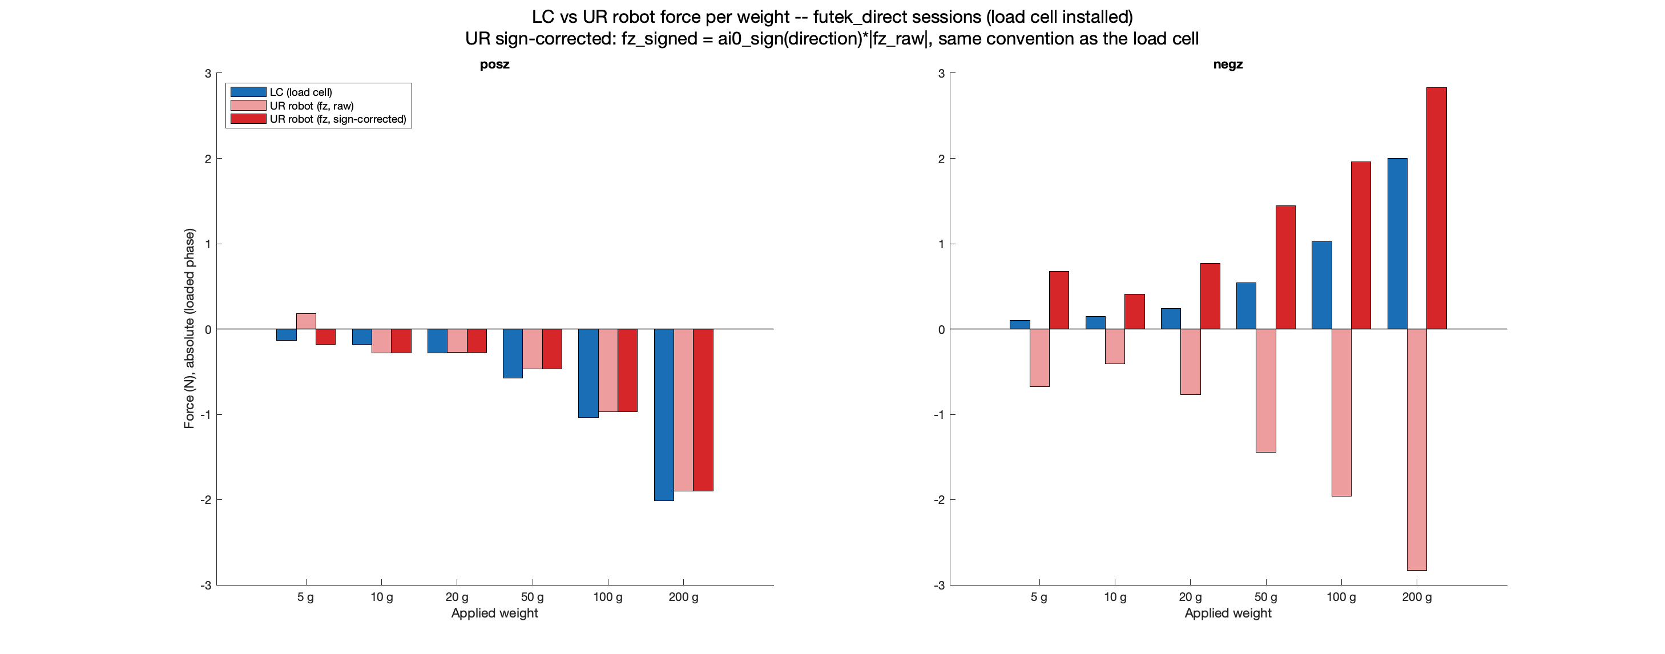
force_sensor_calibration/plots/lc_vs_ur_by_weight_matlab.png
