Jonasjcmh/Star_nose_sensor/force_sensor_calibration/plots/ur_compensation_linearization_matlab.png

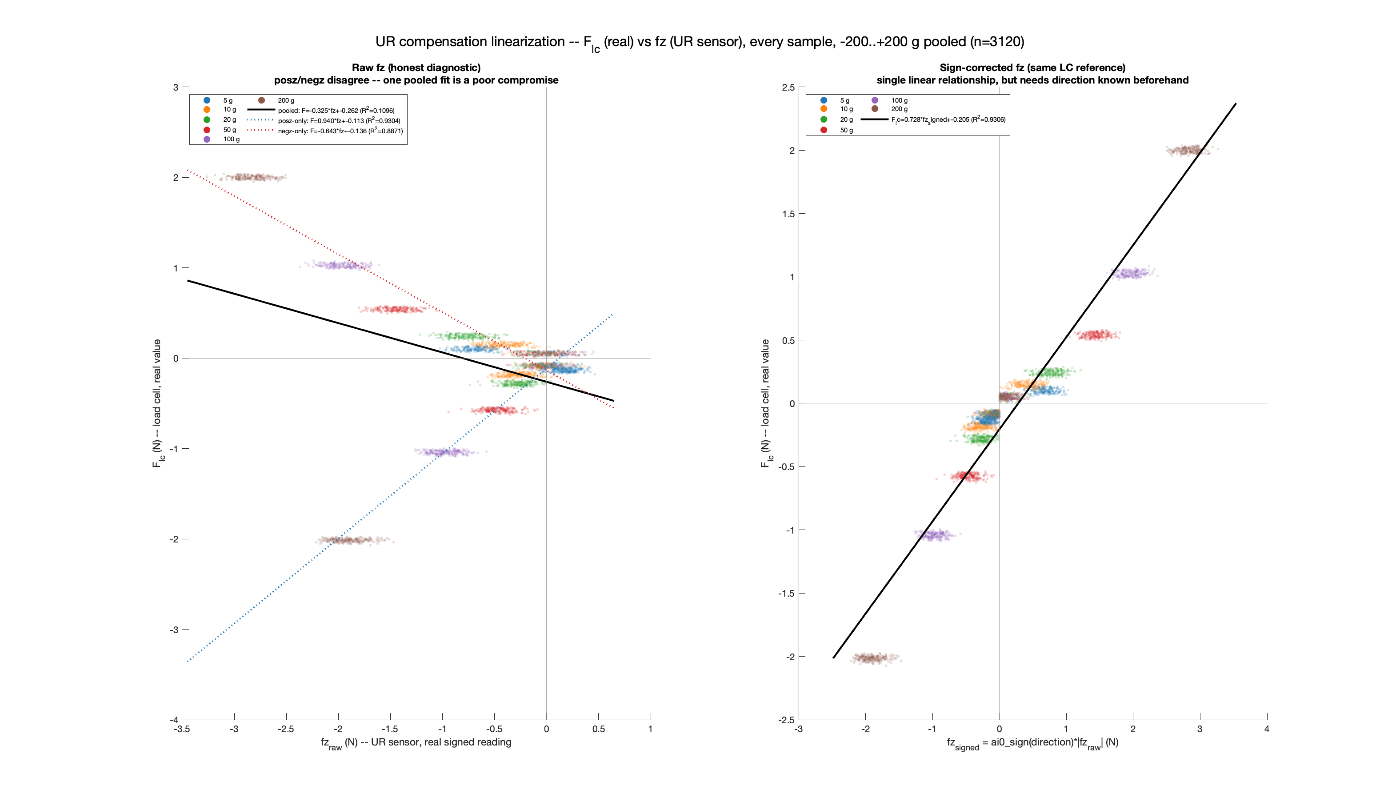
force_sensor_calibration/plots/ur_compensation_linearization_matlab.png
