Jonasjcmh/Star_nose_sensor/force_sensor_calibration/plots/ur_only_compensation_crosscheck_matlab.png

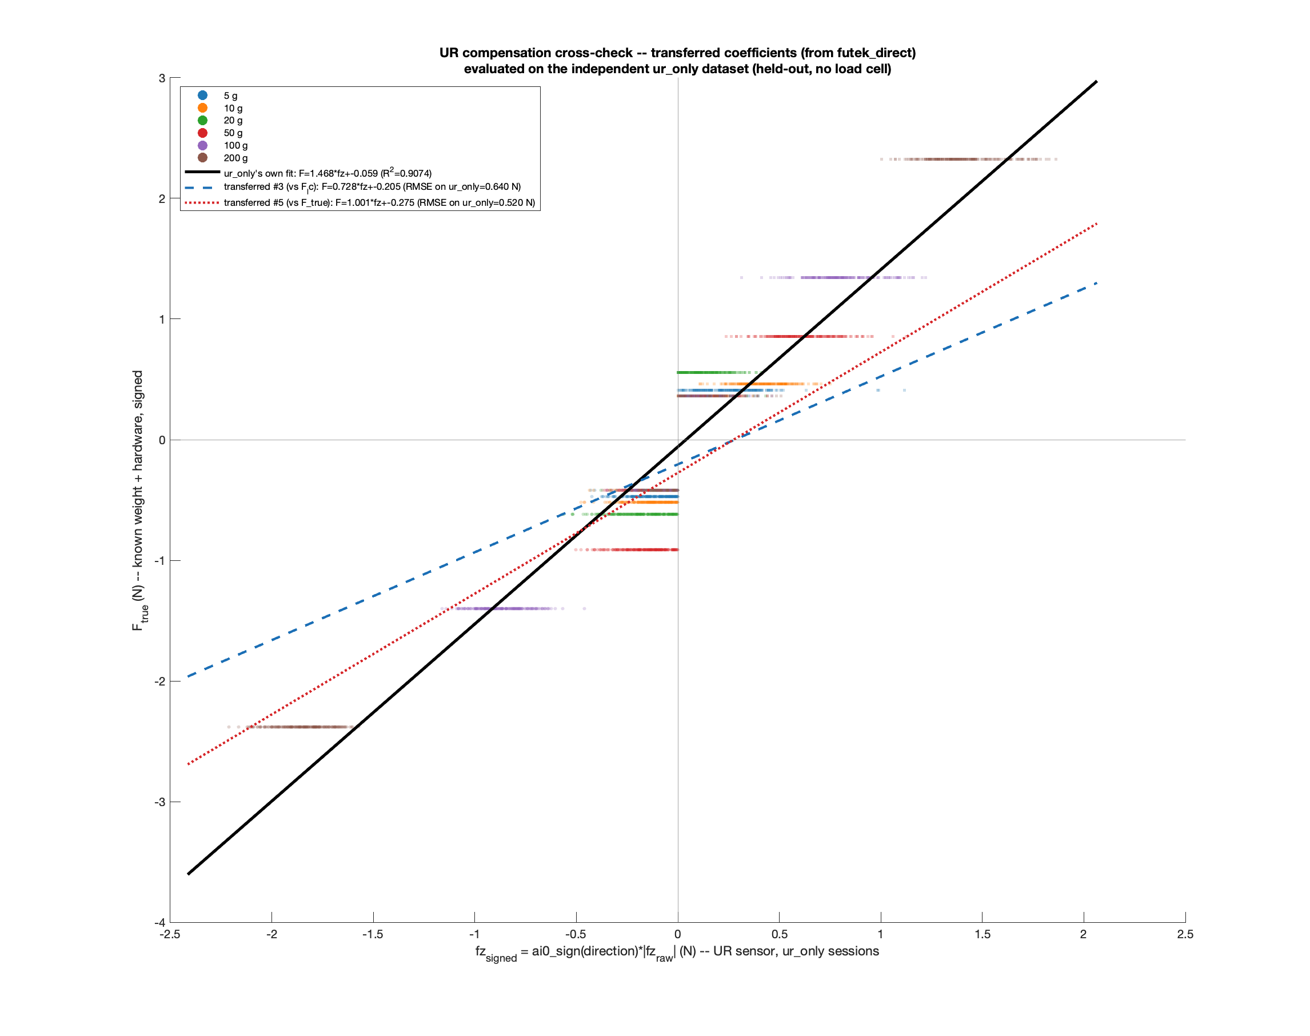
force_sensor_calibration/plots/ur_only_compensation_crosscheck_matlab.png
