Jonasjcmh/Star_nose_sensor/force_sensor_calibration/plots/ur_only_fz_vs_time_matlab.png

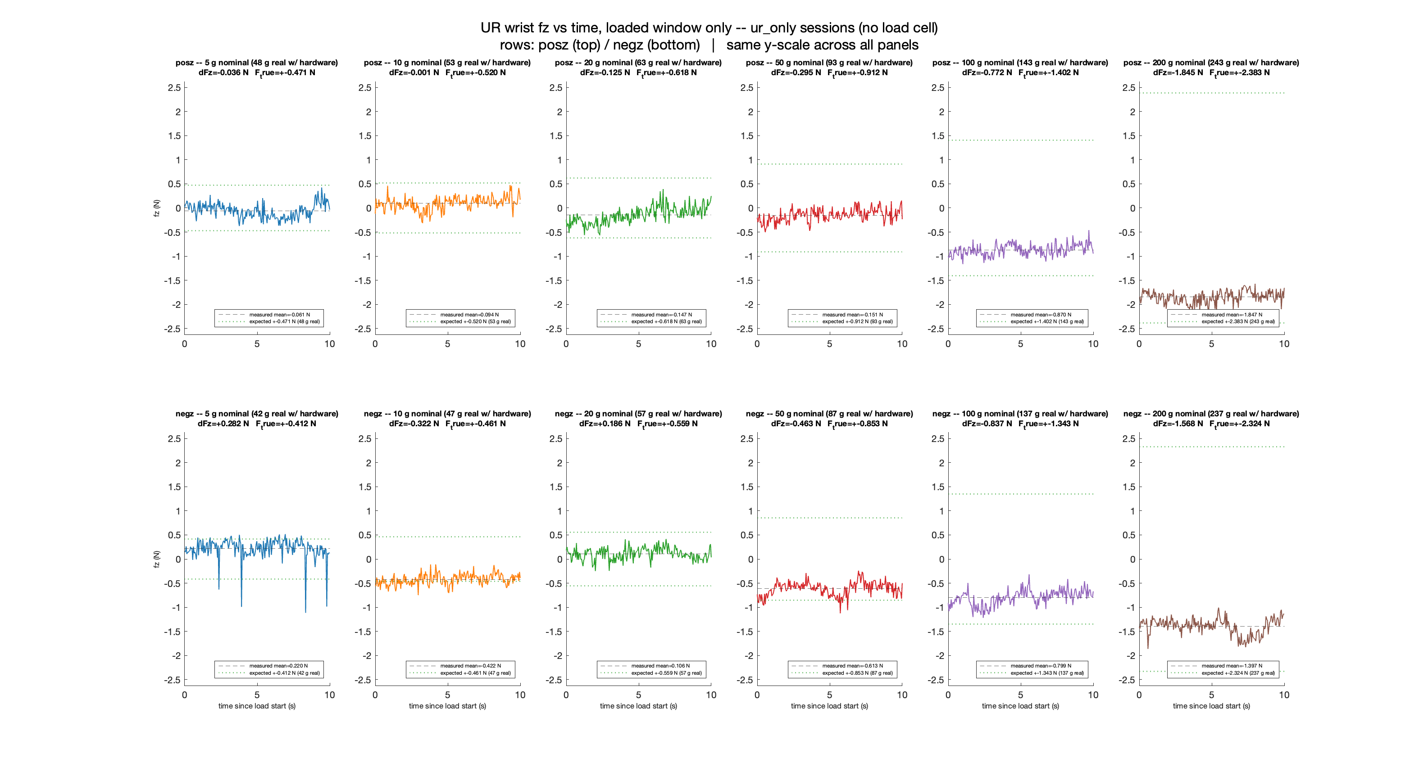
force_sensor_calibration/plots/ur_only_fz_vs_time_matlab.png
