Jonasjcmh/Star_nose_sensor/force_sensor_calibration/plots/ur_only_vs_load_posz.png

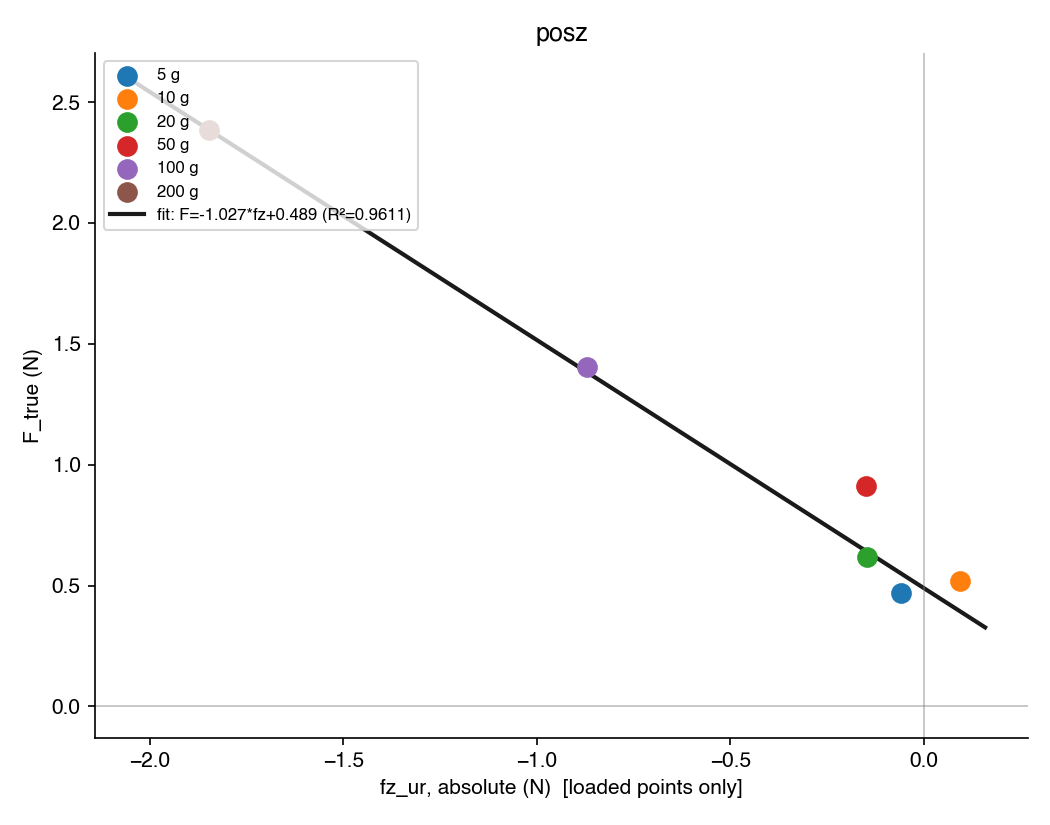
force_sensor_calibration/plots/ur_only_vs_load_posz.png
