Jonasjcmh/Star_nose_sensor/Integration_2/calibration_points_plot_rigid.png

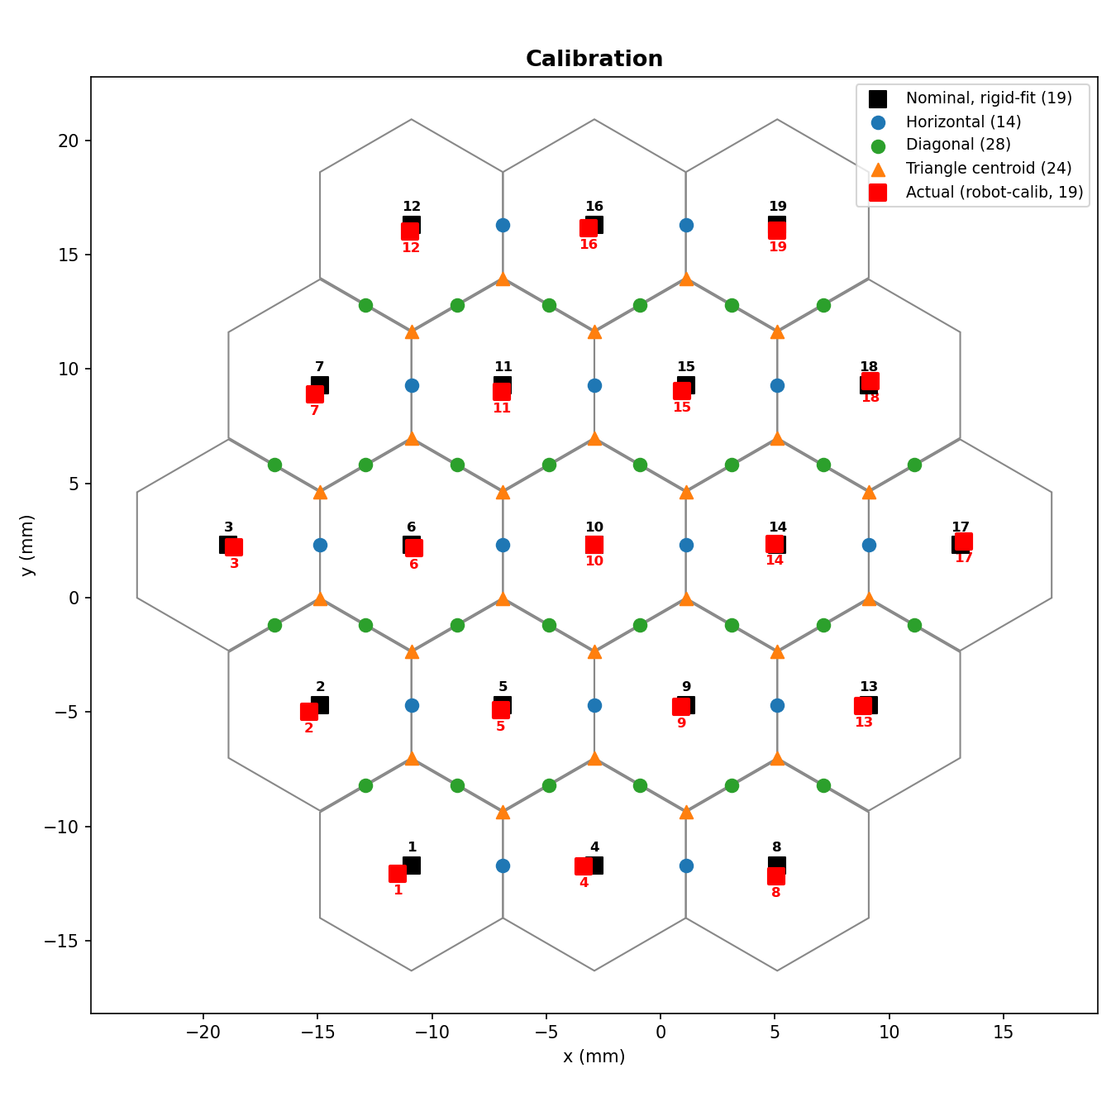
Integration_2/calibration_points_plot_rigid.png
