Jonasjcmh/Star_nose_sensor/Interdome_touch/matlab_analysis/results/interdome_20260724_162417_point_variance_matlab.png

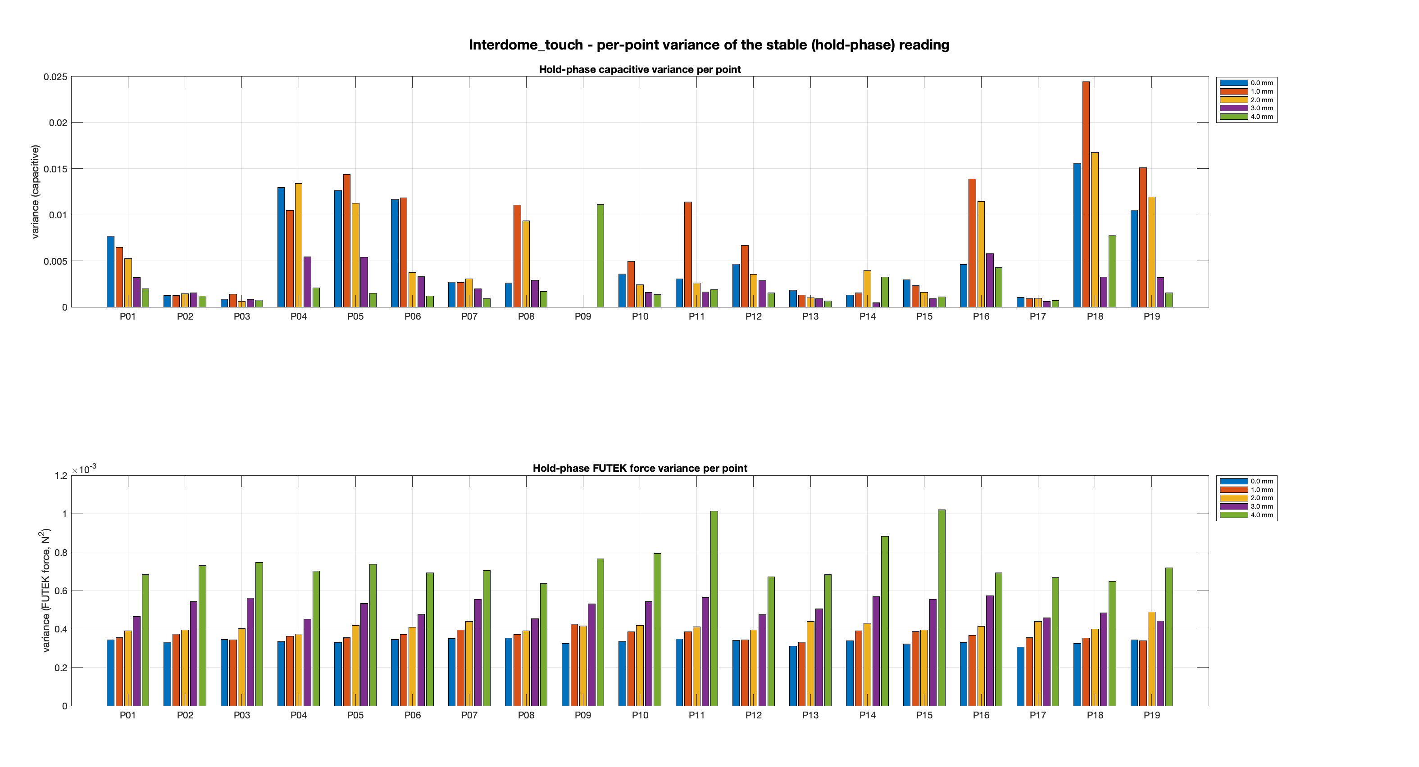
Interdome_touch/matlab_analysis/results/interdome_20260724_162417_point_variance_matlab.png
