Jonasjcmh/Star_nose_sensor/Interdome_touch/matlab_analysis/results/interdome_20260724_162417_triangle_futek_var_median_matlab.png

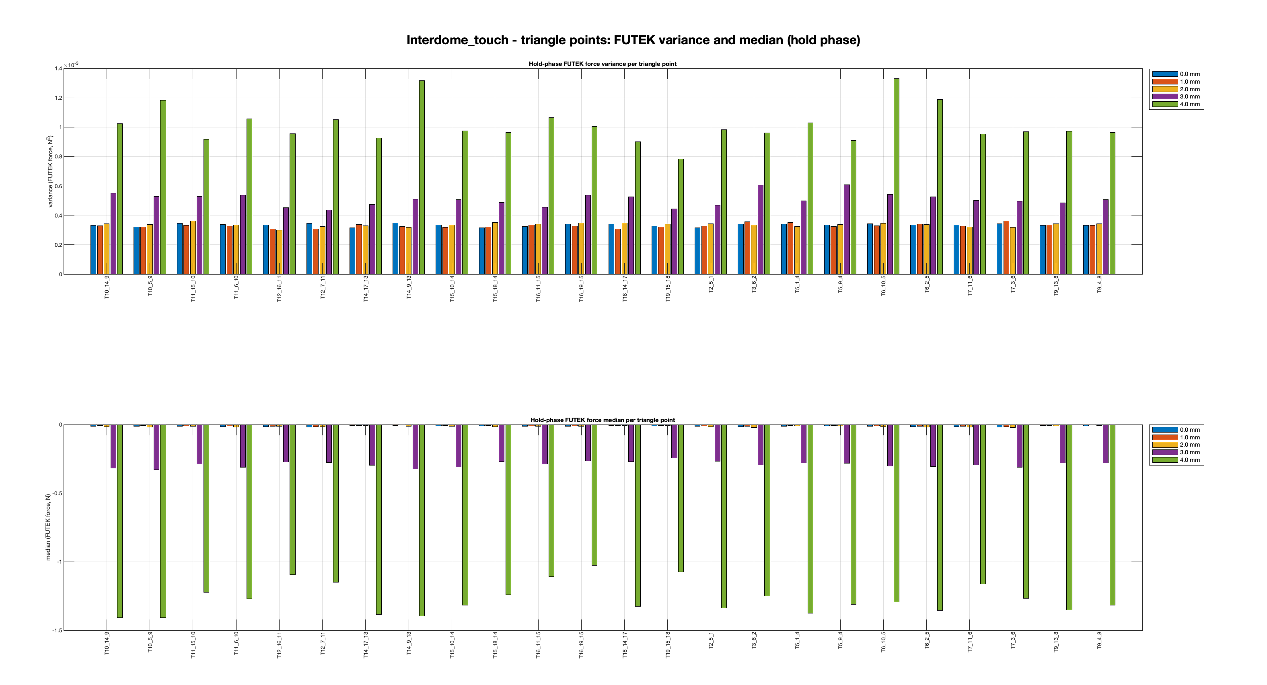
Interdome_touch/matlab_analysis/results/interdome_20260724_162417_triangle_futek_var_median_matlab.png
