Jonasjcmh/Star_nose_sensor/linear_displacement_test/results/bidirectional/hexmap_frames_v2/frames/c3_bidir_c3_to_b3/f103 2.png

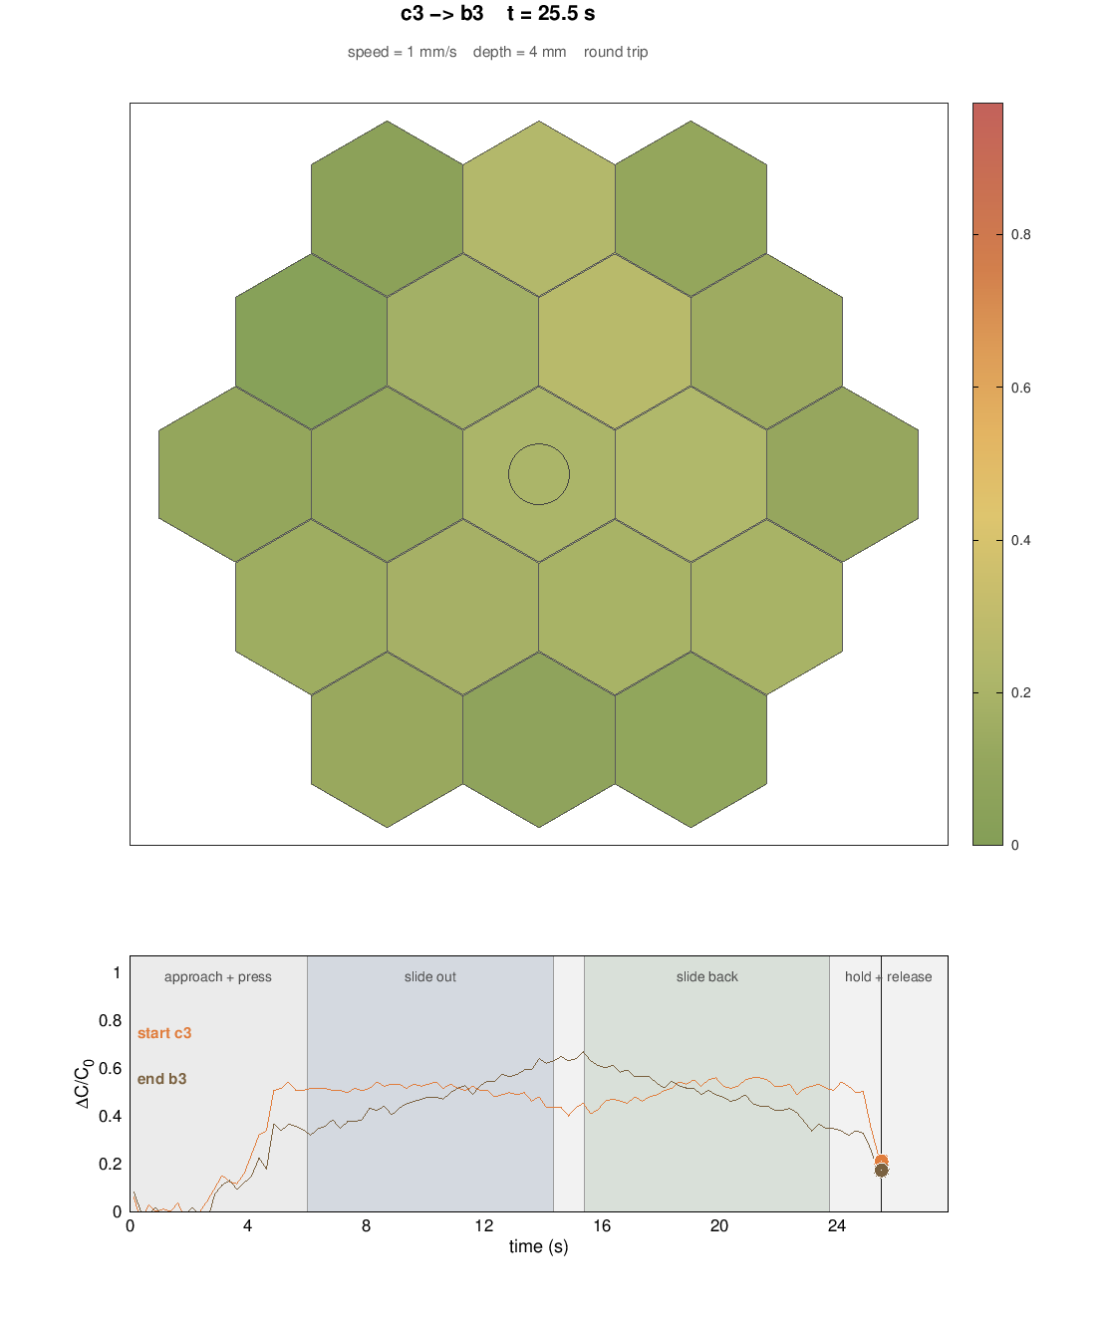
linear_displacement_test/results/bidirectional/hexmap_frames_v2/frames/c3_bidir_c3_to_b3/f103 2.png
