Jonasjcmh/Star_nose_sensor/linear_displacement_test/results/bidirectional/response_vs_position/c3_bidir_slide_c3_to_a1.png

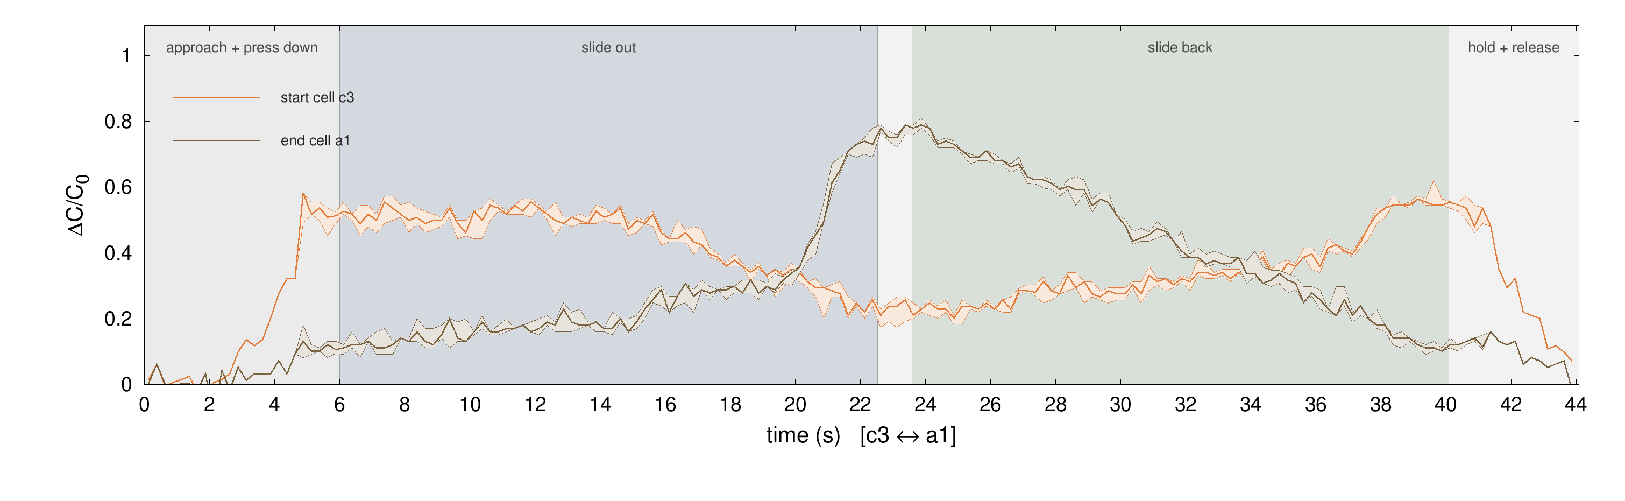
linear_displacement_test/results/bidirectional/response_vs_position/c3_bidir_slide_c3_to_a1.png
