Jonasjcmh/Star_nose_sensor/linear_displacement_test/results/hexmap_frames/b3_near_b3_to_a2_frames.png

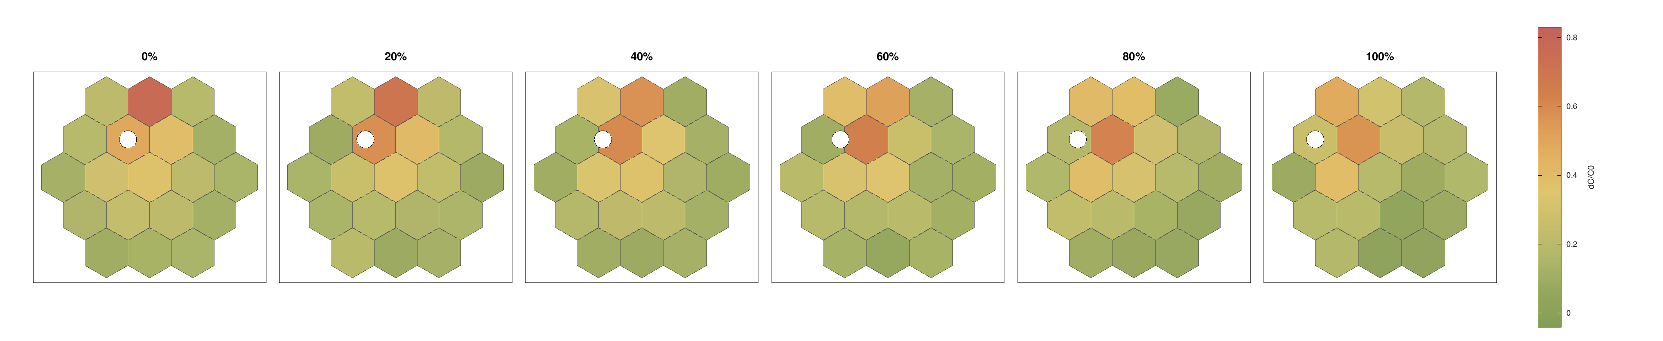
linear_displacement_test/results/hexmap_frames/b3_near_b3_to_a2_frames.png
