Jonasjcmh/Star_nose_sensor/linear_displacement_test/results/hexmap_frames/c3_long_c3_to_e3_frames.png

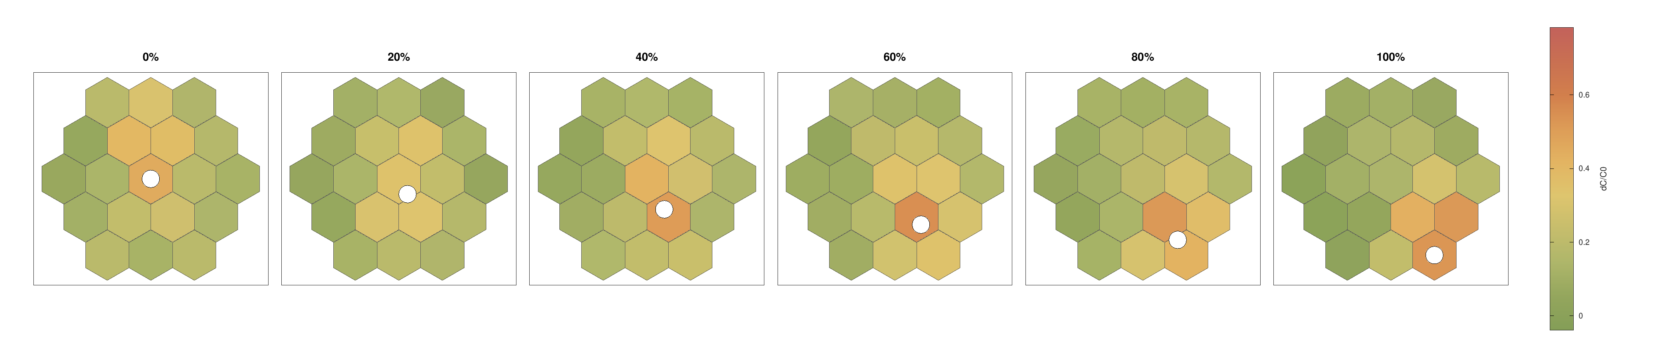
linear_displacement_test/results/hexmap_frames/c3_long_c3_to_e3_frames.png
