Jonasjcmh/Star_nose_sensor/linear_displacement_test/results/response_vs_position/b3_near_slide_b3_to_a2.png

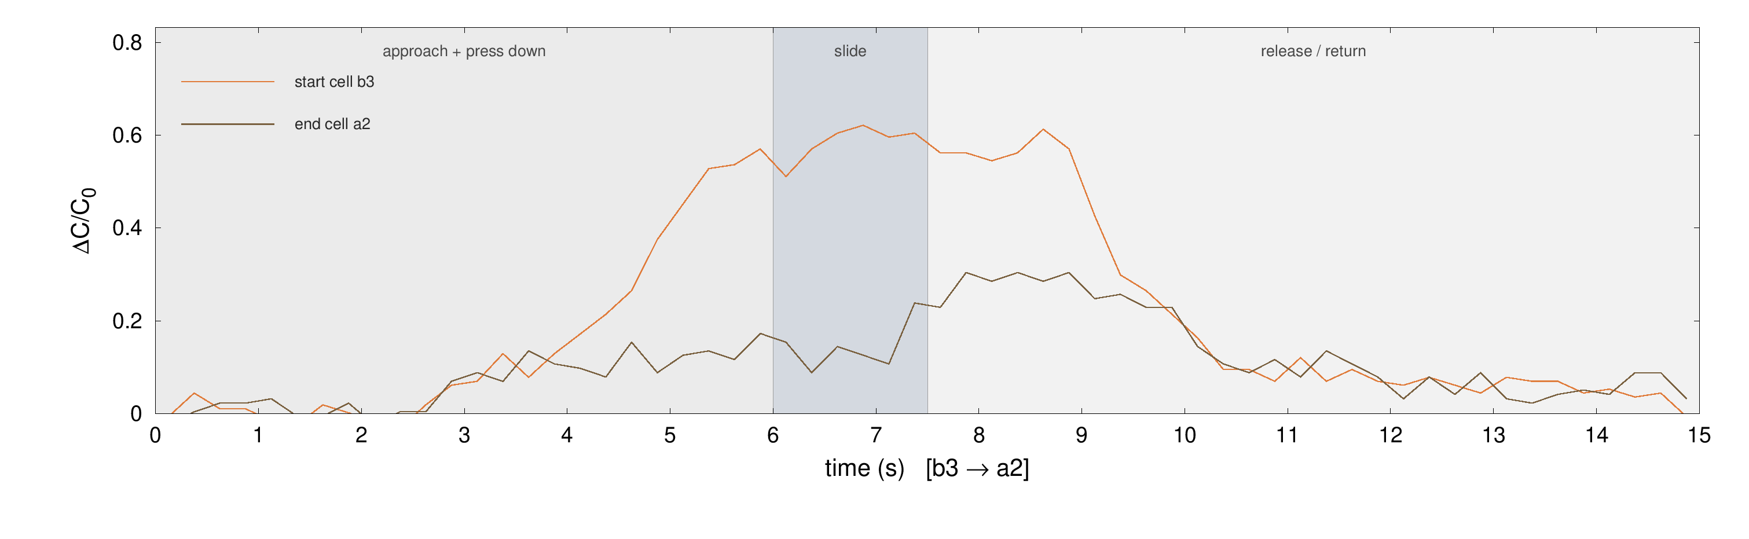
linear_displacement_test/results/response_vs_position/b3_near_slide_b3_to_a2.png
