Jonasjcmh/Star_nose_sensor/linear_displacement_test/results/response_vs_position/c3_long_slide_c3_to_b1.png

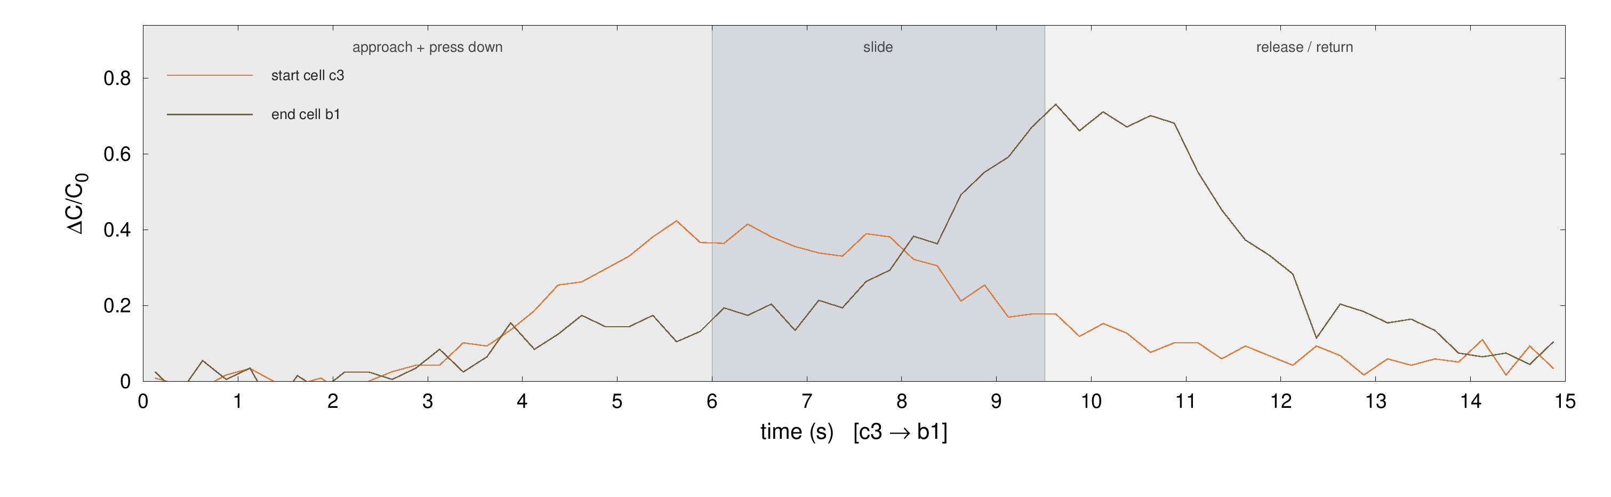
linear_displacement_test/results/response_vs_position/c3_long_slide_c3_to_b1.png
