Jonasjcmh/Star_nose_sensor/linear_displacement_test/results/response_vs_position/c3_near_slide_c3_to_b3.png

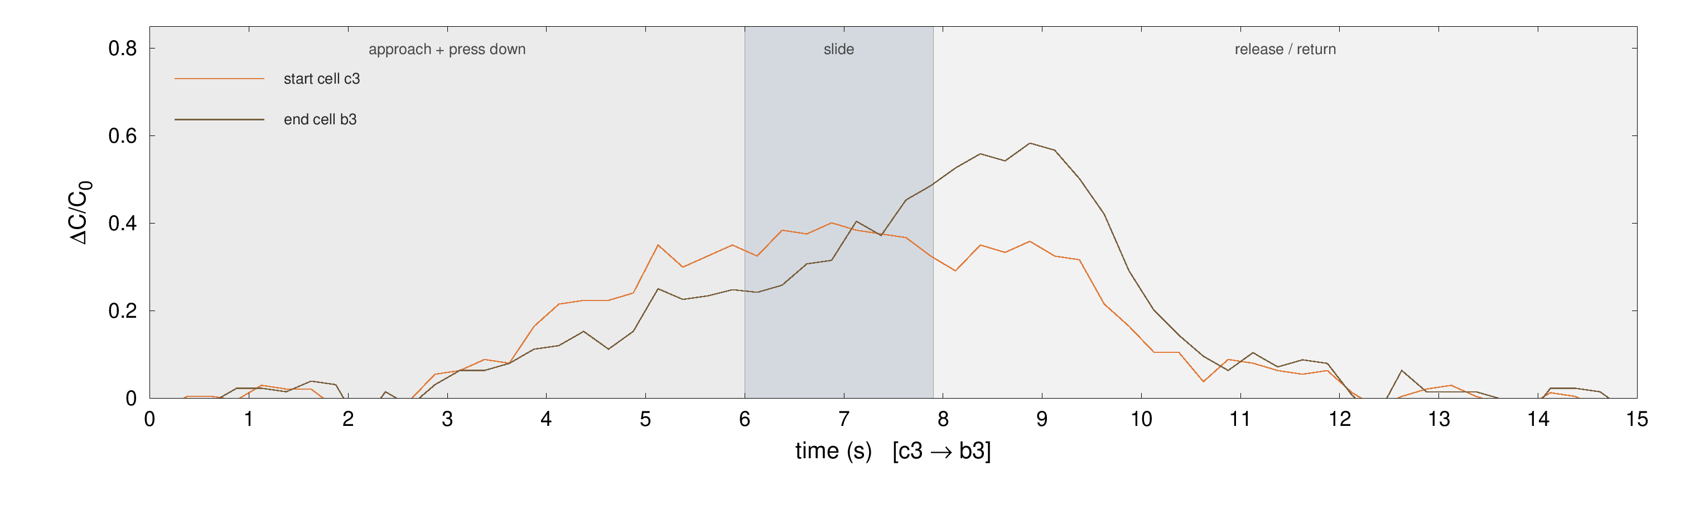
linear_displacement_test/results/response_vs_position/c3_near_slide_c3_to_b3.png
