Jonasjcmh/Star_nose_sensor/linear_displacement_test/results/trajectory/hexmap/ring_internal_strip.png

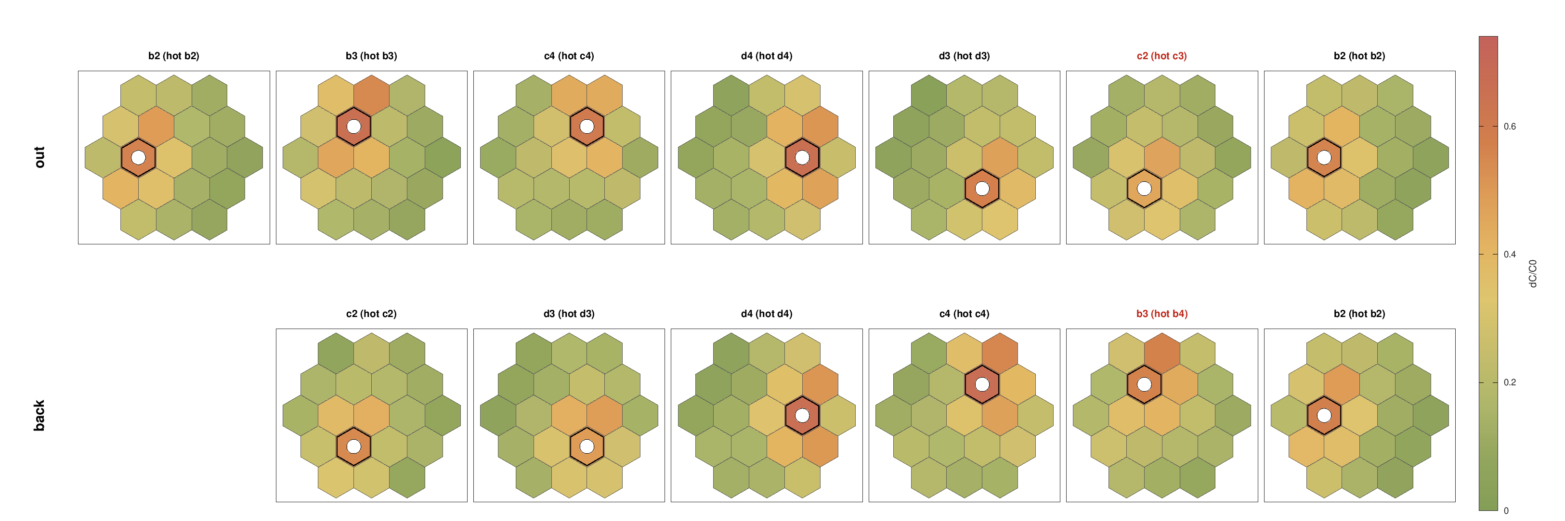
linear_displacement_test/results/trajectory/hexmap/ring_internal_strip.png
