Jonasjcmh/Star_nose_sensor/linear_displacement_test/results/trajectory/response/ring_external_traces.png

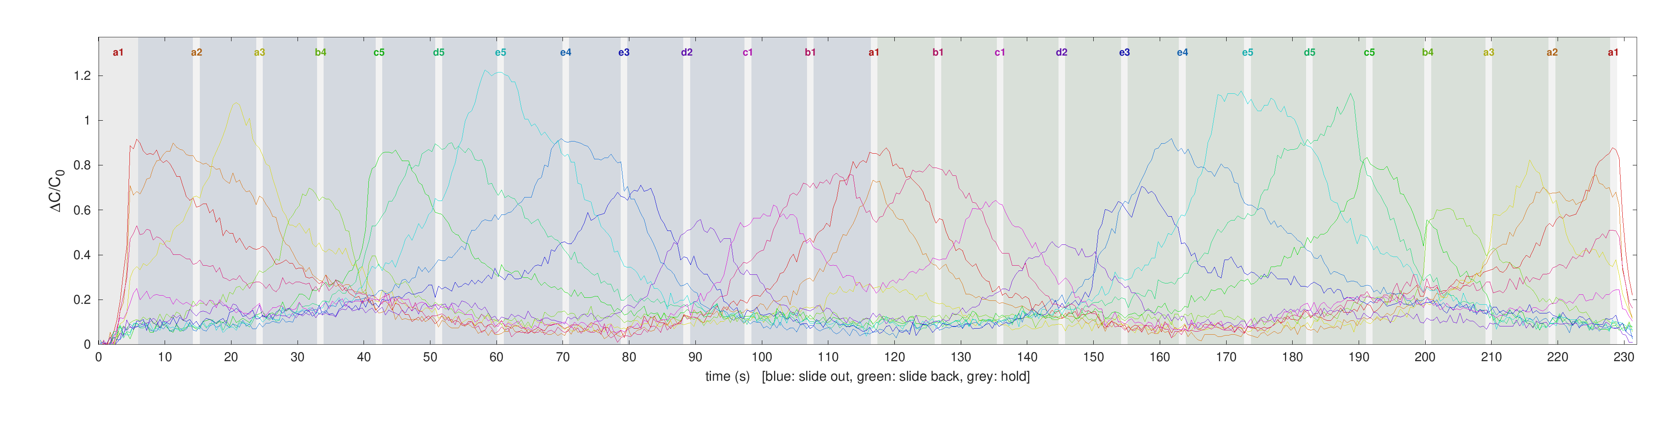
linear_displacement_test/results/trajectory/response/ring_external_traces.png
