Jonasjcmh/Star_nose_sensor/linear_displacement_test/results/trajectory/response/ring_internal_heatmap.png

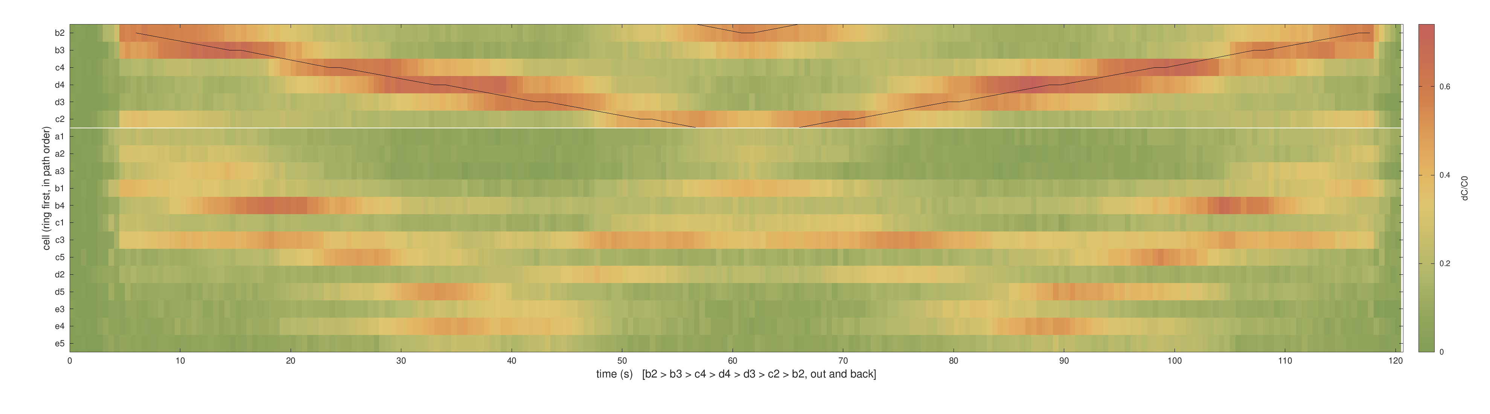
linear_displacement_test/results/trajectory/response/ring_internal_heatmap.png
