Jonasjcmh/Star_nose_sensor/linear_displacement_test/results/trajectory/response/ring_internal_tracking.png

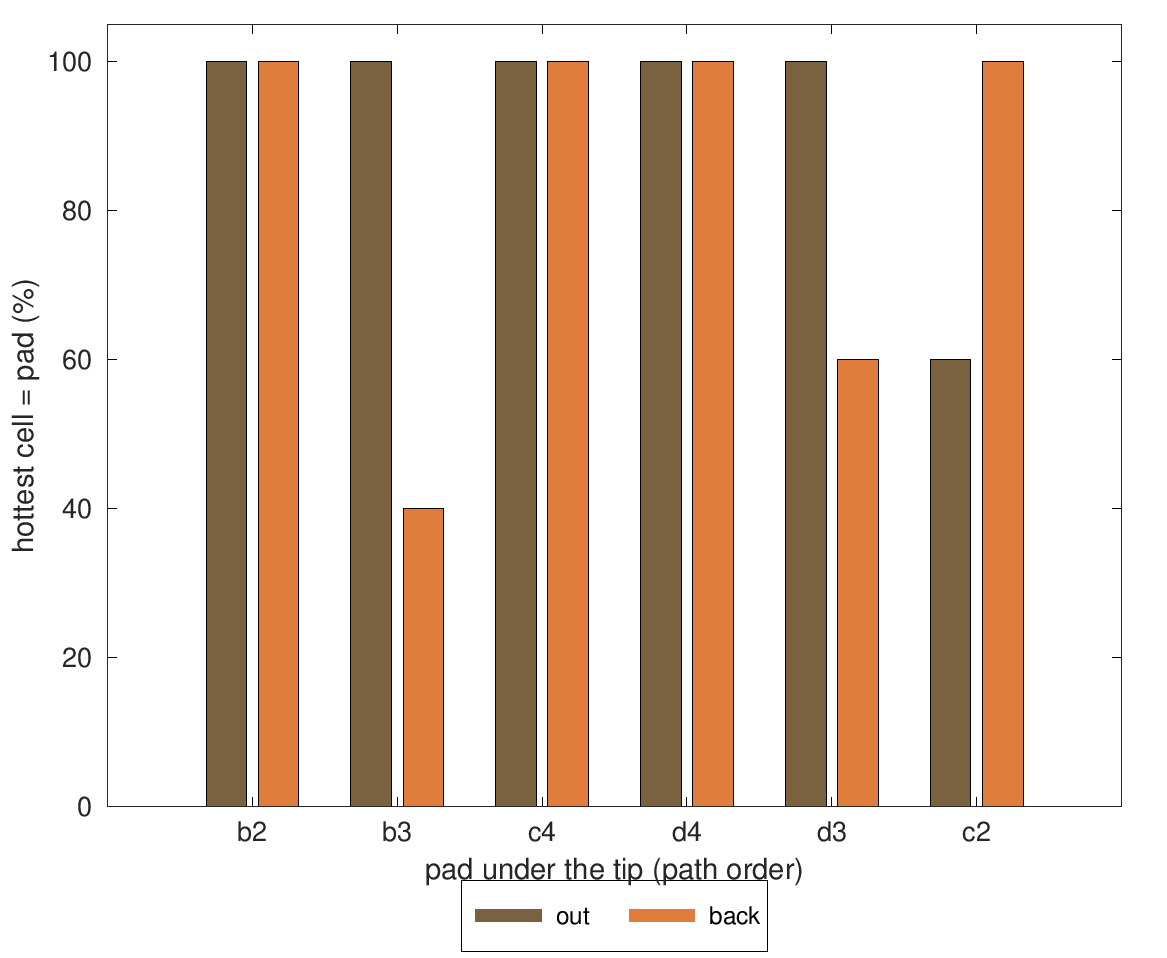
linear_displacement_test/results/trajectory/response/ring_internal_tracking.png
