Jonasjcmh/Star_nose_sensor/mucaboard_data/matlab/results/capacitance_estimation.png

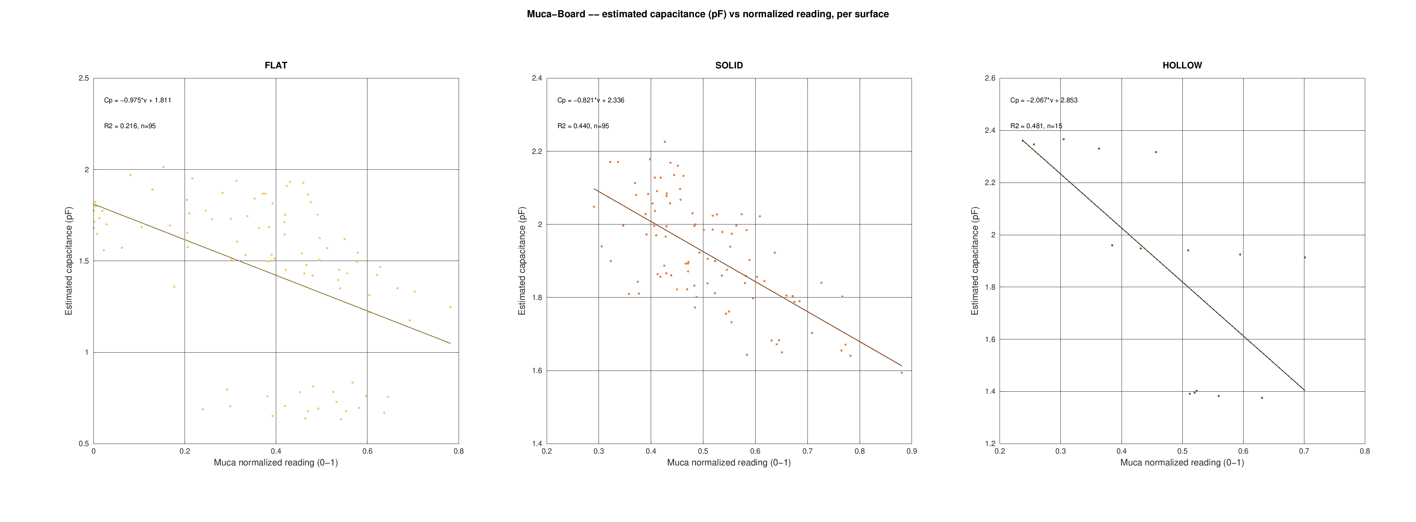
mucaboard_data/matlab/results/capacitance_estimation.png
