Jonasjcmh/Star_nose_sensor/mucaboard_data/matlab/results/force_vs_time_individual_point3_depth10mm.png

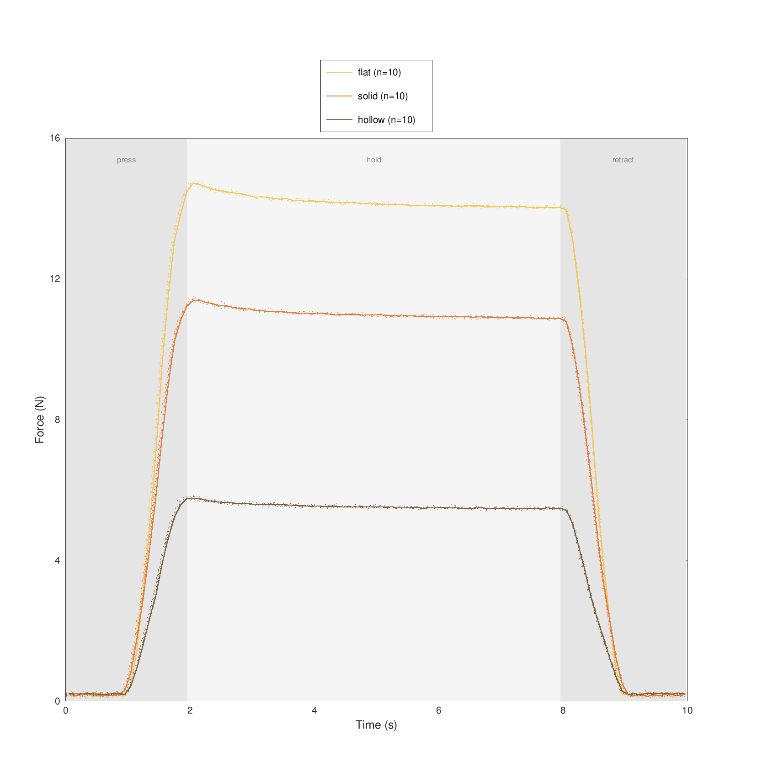
mucaboard_data/matlab/results/force_vs_time_individual_point3_depth10mm.png
