Jonasjcmh/Star_nose_sensor/Matlab/force_analysis/output/raw_signals.pdf

### Raw Force Signals — Full Session (no conditioning) UR5 col: raw f z

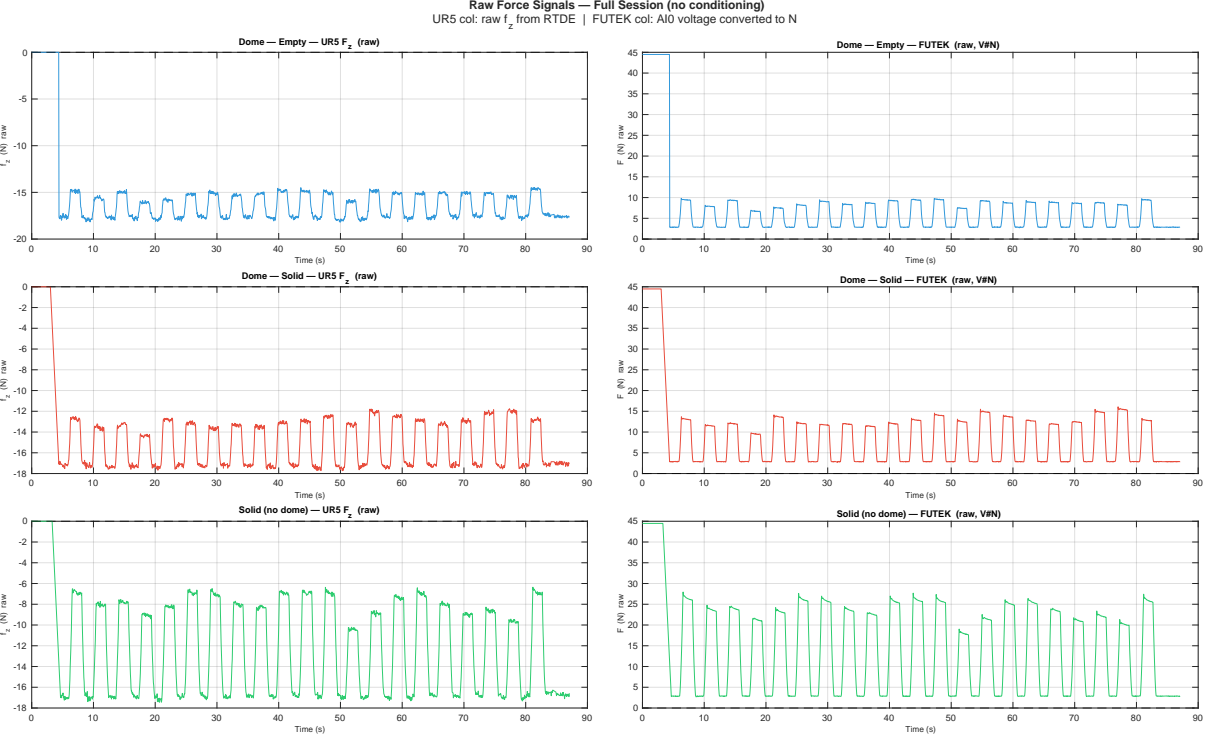
[picture p234: page 1]
Time (s); fz (N) raw; Dome — Empty — UR5 F; (raw); F (N) raw; Dome — Solid — UR5 F

from RTDE | FUTEK col: AI0 voltage converted to N

Dome — Empty — FUTEK (raw, V#N)

Dome — Solid — FUTEK (raw, V#N)

Solid (no dome) — UR5 F

Solid (no dome) — FUTEK (raw, V#N)
