Jonasjcmh/Star_nose_sensor/Matlab/force_analysis/output/scatter.pdf

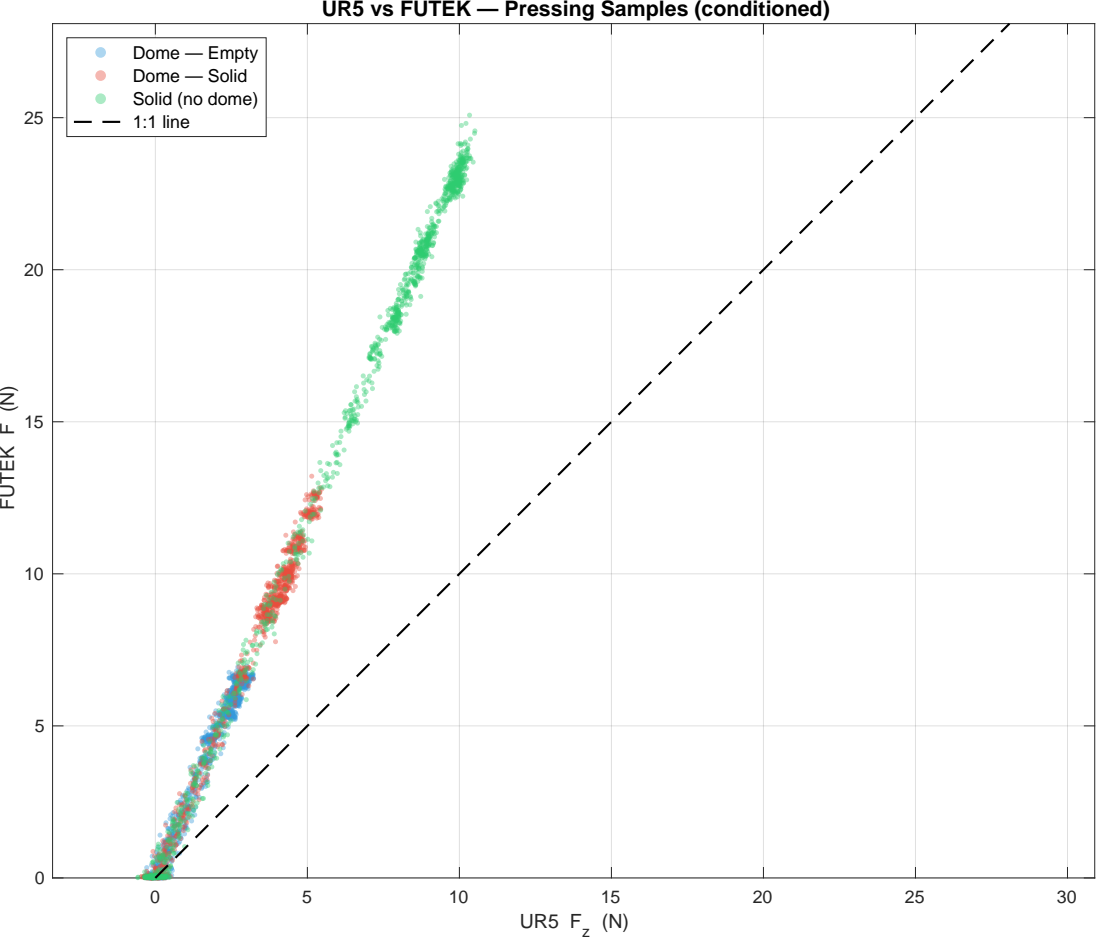
[picture p235: page 1]
FUTEK F (N)

UR5 vs FUTEK — Pressing Samples (conditioned)

Dome — Empty Dome — Solid Solid (no dome)

1:1 line
