Jonasjcmh/Star_nose_sensor/Matlab/force_analysis/output/ur5_all_channels.pdf

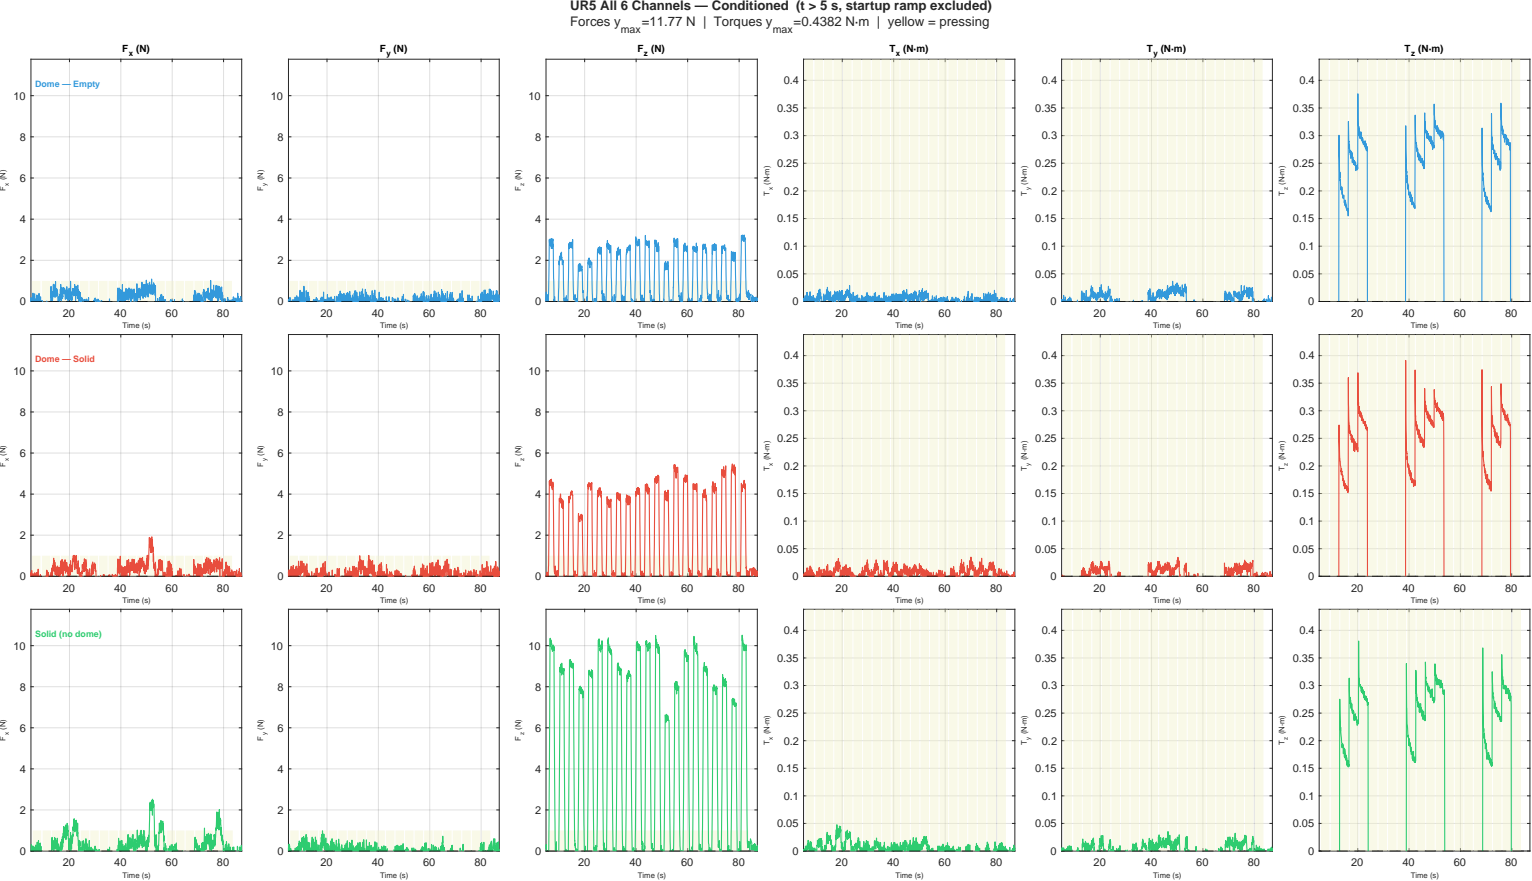
[picture p236: page 1]
Time (s); Dome — Empty; Dome — Solid

UR5 All 6 Channels — Conditioned (t > 5 s, startup ramp excluded)
Forces ymax=11.77 N | Torques ymax=0.4382 N·m | yellow = pressing

Solid (no dome)
