Jonasjcmh/Star_nose_sensor/Matlab/force_analysis/output/conditioned_signals.pdf

### Conditioned Signals (startup ramp excluded, shared y-scale) rest=0 · pressing>0 · ymax=28.09 N (t>5 s)

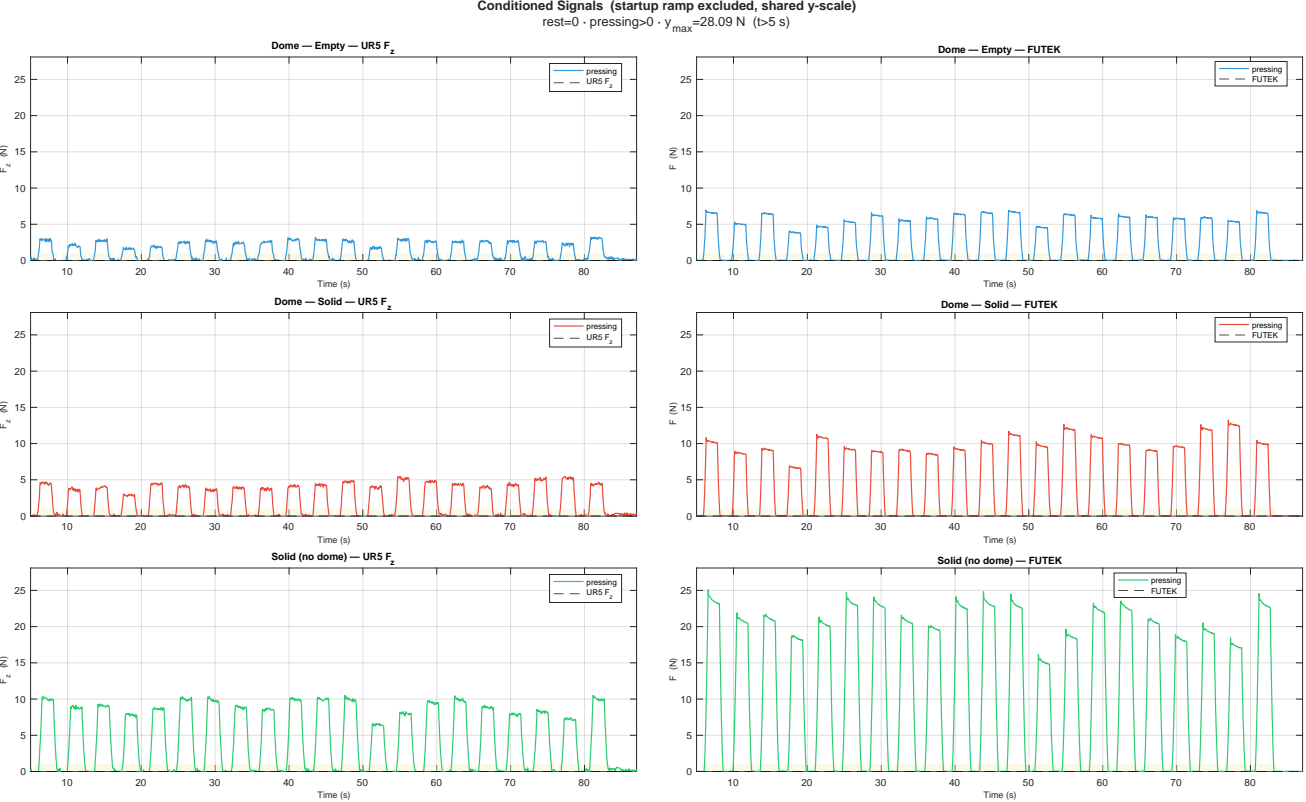
[picture p237: page 1]
Time (s); Dome — Empty — UR5 F; pressing UR5 F z; pressing FUTEK; Dome — Solid — UR5 F

Dome — Empty — FUTEK

Dome — Solid — FUTEK

Solid (no dome) — UR5 F

Solid (no dome) — FUTEK
