Jonasjcmh/Star_nose_sensor/Matlab/force_analysis/output/per_point.pdf

### Per-Contact-Point Mean ± Std (shared y max

= 28.09 N)

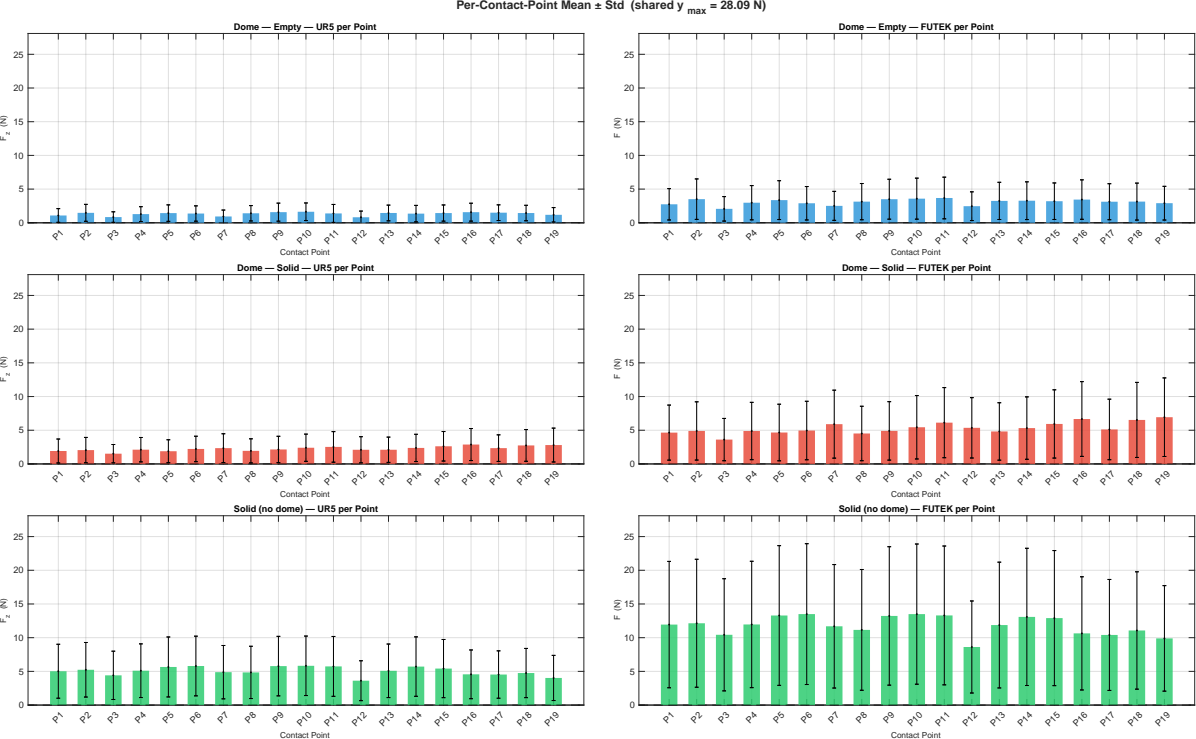
[picture p238: page 1]

Dome — Empty — UR5 per Point

Dome — Empty — FUTEK per Point

Dome — Solid — UR5 per Point

Dome — Solid — FUTEK per Point

Solid (no dome) — UR5 per Point

Solid (no dome) — FUTEK per Point
