Jonasjcmh/Star_nose_sensor/(commit log)

2026-05-06 Add session logs, analysis plots, and safety improvements
    - Add logs/ with 7 CSV sessions recorded during testing
    - Add plots/ with 4 analysis figures for unlabelled_session (overview, perpoint, hexmaps, force)
    - ur5_control: robot always returns to home (+30mm above mat) on completion, error, or stop request
    - main: cooperative UR5 shutdown — signals stop and joins thread before exiting
    - analyze_session: fix pandas/matplotlib compatibility (Series.to_numpy() for plot calls)
    [readme_test_session_20260506_161734.csv, safety_test2_session_20260506_164216.csv, safety_test_session_20260506_164023.csv, solid_dome_test_2_session_20260506_161932.csv, solid_domes_session_20260506_161240.csv, test_without_sofa_session_20260506_160917.csv, unlabelled_session_20260506_164333.csv]
2026-05-06 increase SENSITIVITY to 16 to reduce sensor saturation
    [dome_empty_sensitivity_16_gamma_08_session_20260506_170404.csv, dome_empty_test_final_session_20260506_165823.csv]
2026-05-06 increase SENSITIVITY to 30 to reduce sensor saturation
    [dome_empty_sensitivity_30_gamma_05_session_20260506_171439.csv]
2026-05-06 Fix project name from KYWO to Star-Nose Sensor in README2
2026-05-06 Create README.md for Star-Nose Sensor System
    Added detailed documentation for the Star-Nose Sensor System, including system overview, architecture, hardware setup, usage instructions, and dependencies.
2026-05-07 Fix 120° CCW sensor orientation: correct UR5_TO_SENSOR/IDX mapping and plot order
2026-05-07 Add local project files: Integration, RTDE_Python_Client_Library, and scripts
    [dome_empty_burcu_session_20260507_170024.csv, dome_empty_sensitivity_16_gamma_08_session_20260506_170404.csv, dome_empty_sensitivity_30_gamma_05_session_20260506_171439.csv, dome_empty_test_final_session_20260506_165823.csv, readme_test_session_20260506_161734.csv, safety_test2_session_20260506_164216.csv, safety_test_session_20260506_164023.csv, solid_dome_test_2_session_20260506_161932.csv]
2026-05-11 new collection monda
    [dome_empty_monday_2_session_20260511_134351.csv, dome_solid_monday_session_20260511_133020.csv, solid_monday_session_20260511_133519.csv]
2026-05-21 Commit all local changes
    [dome_empty_monday_2_session_20260511_134351.csv, dome_empty_tuesday_10_session_20260512_163300.csv, dome_empty_tuesday_1_session_20260512_153527.csv, dome_empty_tuesday_2_session_20260512_154059.csv, dome_empty_tuesday_3_session_20260512_154243.csv, dome_empty_tuesday_4_session_20260512_154425.csv, dome_empty_tuesday_5_session_20260512_154624.csv, dome_empty_tuesday_6_session_20260512_154912.csv]
2026-05-26 Add digital twin visualizers, demo system, and README for Integration_2
    - robot_viz_meshcat.py: browser-based UR5 digital twin (Meshcat/Three.js)
    with fixed sensor cells on table, indenter cylinder at end-effector,
    force arrows, and RTDE live feed with demo fallback
    - robot_viz_pybullet.py: OpenGL digital twin (PyBullet URDF) with same
    fixed-sensor layout and indenter geometry
    - demo_system.py: hardware-free CSV replay with scipy IK arm animation
    - robot_viz_3d.py: matplotlib 3D arm viewer
    - calibrate_points.py: per-point TCP calibration tool
    - main.py: added --robot-viz-meshcat, --robot-viz-pybullet flags; sim IP override
    - ur5_control.py: env-var robot IP, URScript fallback controlle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
    [calibrate_points.py]
2026-05-28 analog input included
    [ai0_test_session_20260528_150039.csv, sss_session_20260527_170103.csv, sss_session_20260527_173108.csv, sss_session_20260527_180440.csv, sss_session_20260527_180805.csv, ssse_session_20260527_182203.csv, sssr_session_20260527_182002.csv, sssr_session_20260527_183815.csv]
2026-05-28 analog input included fixed
    [Setup_testing_session_20260528_162530.csv]
2026-05-28 calibration_small pointer and new data collection of sensors
    [dome_empty_may_28_9mm_session_20260528_225530.csv, dome_empty_may_28_session_20260528_225103.csv, dome_empty_monday_28_session_20260528_223656.csv, dome_empty_thursday_28_session_20260528_223948.csv, dome_solid_may_28_9mm_session_20260528_232207.csv, solid_may_28_9mm_session_20260528_233223.csv]
2026-05-28 from Macbook 2
    [events.csv, ursim_19pts_session_20260525_224235.csv, ursim_19pts_session_20260525_225720.csv]
2026-06-02 add friction_mode experiment, MATLAB force analysis, and signal conditioning fixes
    - friction_mode/: new lateral sliding experiment with displacement and force-control modes
    - trajectories.py: 9 named XY paths (line, circle, raster, spiral, star, cross, diagonal)
    - ur5_friction.py: UR5 control with FUTEK-based P-controller for constant-force mode
    - main_friction.py: CLI runner sharing sensor/logger from Integration_2
    - Matlab/force_analysis/force_comparison.m: compare UR5 fz vs FUTEK across 3 cases
    - zero reference now uses mean(rest rows) instead of min(session window) to eliminate offset
    - startup ramp excluded (t < 5 s) from display and global y-max computation
    - all 6 UR5 ch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
    [Setup_testing_session_20260528_162530.csv, ai0_test_session_20260528_150039.csv, dome_empty_burcu_session_20260507_170024.csv, dome_empty_may_28_session_20260528_225103.csv, dome_empty_monday_28_session_20260528_223656.csv, dome_empty_monday_2_session_20260511_134351.csv, dome_empty_sensitivity_16_gamma_08_session_20260506_170404.csv, dome_empty_sensitivity_30_gamma_05_session_20260506_171439.csv]
2026-06-02 add dataset_collector for ML dataset collection
    Systematic press-data collection across all 19 points at depths 7, 8,
    9 mm. Records peak/mean capacitive values, robot Fz, and FUTEK load cell
    force per press. Supports configurable samples, randomized point order,
    and incremental CSV save after each depth block.
2026-06-02 add dataset: 10 samples × 19 points × 3 depths (570 presses, short_6mm tip)
    [dataset_short_6mm_20260602_164335.csv]
2026-06-04 update log CSVs, plots, and session data
    [Setup_testing_session_20260528_162530.csv, ai0_test_session_20260528_150039.csv, dome_empty_burcu_session_20260507_170024.csv, dome_empty_may_28_session_20260528_225103.csv, dome_empty_monday_28_session_20260528_223656.csv, dome_empty_monday_2_session_20260511_134351.csv, dome_empty_sensitivity_16_gamma_08_session_20260506_170404.csv, dome_empty_sensitivity_30_gamma_05_session_20260506_171439.csv]
2026-06-04 Add friction session analyser and first friction session data
    - analyze_friction.py: 6-panel signal analysis script (capacitive sensor,
    UR5 force/torque, FUTEK load cell, force comparison, TCP trajectory,
    cross-correlation)
    - First friction displacement session log (line_h trajectory)
    - Analysis plots for the session
    [friction_disp_line_h_session_20260604_153723.csv]
2026-06-04 Add friction animation, dataset name prompt, torque plots, and new sessions
    - animate_friction.py: dark-theme animated dashboard with hex map, TCP
    XY trajectory, rolling cell history, force (Fz + load cell), and
    torque (Tx Ty Tz + |τ|) panels
    - analyze_friction.py: expanded figure 2 with dedicated torque time-series,
    rolling stats per axis, torque magnitude, and force vs torque scatter
    - main_friction.py: prompt for dataset name (ask_file_prefix) instead of
    auto-generating prefix
    - New friction session logs and analysis plots
    [dome_empty_1mm_session_20260604_155917.csv, dome_empty_2_session_20260604_155726.csv, dome_empty_2mm_session_20260604_160224.csv, dome_empty_2mm_session_20260604_160307.csv, dome_empty_spiral_85mm_session_20260604_160930.csv, domedome_empty_spiral_85mm_session_20260604_161029.csv, empty_dome_session_20260604_155518.csv]
2026-06-04 Add dome_empty_85mm session log and analysis plots
    [dome_empty_85mm_session_20260604_163930.csv]
2026-06-04 Add dome_empty_85mm_line session log and analysis plots
    [dome_empty_85mm_line_session_20260604_165120.csv]
2026-06-10 Add integration_2 folder with scripts, logs, and plots
    [Setup_testing_session_20260528_162530.csv, ai0_test_session_20260528_150039.csv, dome_empty_burcu_session_20260507_170024.csv, dome_empty_may_28_9mm_session_20260528_225530.csv, dome_empty_may_28_session_20260528_225103.csv, dome_empty_monday_28_session_20260528_223656.csv, dome_empty_monday_2_session_20260511_134351.csv, dome_empty_sensitivity_16_gamma_08_session_20260506_170404.csv]
2026-06-11 Add EmStat capacitance measurement script with PalmSens SDK
2026-06-11 Move Capacitance_measurement to project root
2026-06-11 Add friction mode session logs from 2026-06-11
    Empty dome and solid dome runs across line, circle, and spiral trajectories at 1–3 mm depth.
    [empty_dome_circle_1mm_session_20260611_193116.csv, empty_dome_circle_2mm_session_20260611_193611.csv, empty_dome_circle_3mm_session_20260611_193720.csv, empty_dome_line_1mm__session_20260611_192754.csv, empty_dome_line_2mm_session_20260611_193227.csv, empty_dome_line_3mm_session_20260611_193313.csv, empty_dome_spiral_1mm_session_20260611_193006.csv, empty_dome_spiral_2mm_session_20260611_193413.c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]
2026-06-12 Make friction mode scripts cross-platform (Linux + macOS)
    analyze_friction.py:
    - Select Agg backend when --save is passed (headless batch on any OS)
    - Use MacOSX backend on macOS for interactive mode
    - Replace plt.show() with _show(save) helper that closes figures in
    batch mode instead of blocking — fixes hang when running non-interactively
    - Fix matplotlib 3.11 API break: boxplot labels= → tick_labels=
    animate_friction.py:
    - Drop hard-coded TkAgg on Linux; let matplotlib auto-detect the
    available backend (TkAgg / Qt5Agg / GTK3Agg) for interactive mode
    - Keep Agg for --save mode and MacOSX for macOS interactive mode
    - Auto-detect ffmpeg via shutil.which; fall back to GIF when absent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
2026-06-12 Add analysis plots and animations for 2026-06-11 friction sessions
    Generated by analyze_friction.py (--save) and animate_friction.py (--save --gif --step 3)
    for all 22 sessions: empty_dome and solid_dome variants across line, circle,
    and spiral trajectories at 1 mm, 2 mm, and 3 mm depths.
    Each session folder contains:
    1_sensor.png, 2_force.png, 3_loadcell.png, 4_force_comparison.png,
    5_trajectory.png, 6_correlation.png, friction_animation.gif
2026-06-19 Add friction demo scripts and force indentation logger
    - friction_mode/demo_cyclic.py: synthetic animated dashboard cycling through all trajectories
    - friction_mode/demo_live.py: live demo driving real UR5 through trajectories with sensor/F-T display (auto and manual loop modes)
    - Capacitance_measurement/force_indentation.py: interactive force indentation logger for 19 points with auto/manual press-release modes, calib_short_6mm calibration
    - Capacitance_measurement/logs: force indentation session CSVs from 2026-06-19
    [force_indentation_20260619_145629.csv, force_indentation_20260619_155737.csv, force_indentation_20260619_172739.csv]
2026-06-24 capacitance measurement with LCR meter first attempt
    [capacitance_dataset_20260624_112823.csv, capacitance_dataset_20260624_114013.csv, capacitance_dataset_20260624_114840.csv, force_indentation_20260623_152421.csv]
2026-06-24 capacitance dataset collection and analysis
    [capacitance_dataset_20260624_153509.csv, capacitance_dataset_20260624_154514.csv, capacitance_dataset_20260624_155206.csv, capacitance_dataset_20260624_160012.csv, capacitance_dataset_20260624_160925.csv, capacitance_dataset_20260624_161527.csv, capacitance_dataset_20260624_162035.csv]
2026-06-25 Add capacitance analysis script and plots2 figures; update sensor.py
    - analyze_cap_temp.py: new analysis for dataset 20260624_163916,
    bypassing lcr_ok=0 filter; generates sensor map, summary bar,
    phase boxplots, round variability, timeseries, and waveform figures
    - plots2/: cp_waveforms per round with Cp_pF, force, and Z-depth on
    three y-axes; plus overview and statistical plots
    - sensor.py: add commented-out normalise variant, inline SENSITIVITY/GAMMA notes
2026-06-25 Update sensor.py normalise variant and parameter comments
2026-06-25 single point collection
    [single_point_P10_20260625_115248.csv, single_point_P10_20260625_123104.csv, single_point_P10_20260625_123713.csv, single_point_P10_20260625_124309.csv, single_point_P17_20260625_125708.csv]
2026-06-25 analysis and collection of single point
    [single_point_P01_20260625_133113.csv]
2026-06-25 analyzed 19 points with controlled ramp
    [ramp_collector_20260625_162417.csv, single_point_ramp_P01_20260625_142427.csv, single_point_ramp_P01_20260625_150710.csv, single_point_ramp_P02_20260625_150841.csv, single_point_ramp_P03_20260625_151005.csv, single_point_ramp_P10_20260625_144404.csv, single_point_ramp_P10_20260625_150554.csv]
2026-06-25 Add short mocap calibration logs and update calib data
2026-06-29 productive saturday
    [ramp_collector_20260626_140309.csv, ramp_collector_20260626_144905.csv, ramp_collector_20260626_160650.csv, ramp_collector_20260627_110201.csv]
2026-06-29 7 and 8 mm deepness
2026-06-30 capacitive sensing data-30.06.26
    [ramp_collector_20260630_165143.csv]
2026-07-01 removed unnecessary data
    [ramp_collector_20260626_140309.csv, ramp_collector_20260626_144905.csv, ramp_collector_20260626_160650.csv, ramp_collector_20260627_110201.csv, ramp_collector_20260630_165143.csv]
2026-07-03 Add force_sensor_calibration/: UR5 Fz calibration SOP against FUTEK load cell
2026-07-03 Update SVG plots, calib files, and add JT-edition SVGs
    - plots_6mm/P1_depth1mm.svg: updated figure
    - plots_5mm/P1_depth0mm_edition_JT.svg: new annotated edition
    - plots_6mm/P1_depth1mm_JT.svg: new annotated edition
    - Integration_2/calib.json, calib_points.json: updated calibration data
2026-07-03 Add repeatability sign-off + post-removal spot-check plan to force calibration SOP
2026-07-03 try1 caliberation
    [fzcal_futek_direct_100g_20260703_174340.csv, fzcal_futek_direct_10g_20260703_180022.csv, fzcal_futek_direct_200g_20260703_180814.csv, fzcal_futek_direct_20g_20260703_175234.csv, fzcal_futek_direct_50g_20260703_173243.csv, fzcal_futek_direct_5g_20260703_181423.csv]
2026-07-05 Add FUTEK linearization analysis and streaming collector
    - futek_linearization.py: calibrates ai0 voltage to force using 6
    known weights (5-200 g); fits sensitivity at 4.121 N/V vs old 8.896
    N/V (2.16x overestimate); outputs 4 diagnostic plots
    - collect_single_streaming.py: improved data collector using RTDE
    streaming (waitForNewData at 125 Hz) instead of polling + sleep;
    fixes misleading achieved_rate_hz metric by computing per phase
    - plots/: voltage_vs_time, voltage_vs_force, force_comparison, residuals
2026-07-06 hello mon
    [fzcal_futek_direct_posz_100g_20260706_170845.csv, fzcal_futek_direct_posz_10g_20260706_171300.csv, fzcal_futek_direct_posz_200g_20260706_170608.csv, fzcal_futek_direct_posz_200g_20260706_170740.csv, fzcal_futek_direct_posz_20g_20260706_171026.csv, fzcal_futek_direct_posz_50g_20260706_170936.csv, fzcal_futek_direct_posz_5g_20260706_171209.csv, fzcal_ur_only_posz_100g_20260706_173756.csv]
2026-07-14 Measuremnt for flat surface
    [ramp_collector_20260714_103402.csv, ramp_collector_20260714_114814.csv, ramp_collector_20260714_130739.csv, ramp_collector_20260714_140935.csv, ramp_collector_20260714_152420.csv]
2026-07-15 Add force-sensor calibration analysis, capacitance ramp updates, and drafts
    - force_sensor_calibration: LC/UR calibration fit + plotting scripts
    (Python and MATLAB), calibration pattern JSONs, and generated plots.
    ur_only_vs_load now saves 3 separate figures (posz/negz/sign-corrected)
    instead of one combined panel, Helvetica titles, no gridlines, loaded
    points only.
    - Capacitance_measurement: tweaks to Emstat_connection.py and
    palmsens/instrument.py; removes an accidentally-committed Word lock
    file.
    - abstract_draft.docx.
    [Emstat_connection.py]
2026-07-15 caliberating weights
    [fzcal_futek_direct_posz_100g_v2_20260715_153459.csv, fzcal_futek_direct_posz_10g_v2_20260715_152855.csv, fzcal_futek_direct_posz_1156g_v2_20260715_153954.csv, fzcal_futek_direct_posz_150g_v2_20260715_153553.csv, fzcal_futek_direct_posz_200g_v2_20260715_153649.csv, fzcal_futek_direct_posz_20g_v2_20260715_153040.csv, fzcal_futek_direct_posz_250g_v2_20260715_153743.csv, fzcal_futek_direct_posz_300g_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]
2026-07-15 caliberation 15 july
    [fzcal_futek_direct_negz_100g_v2_20260715_160629.csv, fzcal_futek_direct_negz_10g_v2_20260715_155653.csv, fzcal_futek_direct_negz_1156g_v2_20260715_162110.csv, fzcal_futek_direct_negz_150g_v2_20260715_160752.csv, fzcal_futek_direct_negz_200g_v2_20260715_160916.csv, fzcal_futek_direct_negz_20g_v2_20260715_155952.csv, fzcal_futek_direct_negz_250g_v2_20260715_161016.csv, fzcal_futek_direct_negz_300g_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]
2026-07-16 Add operator-friendly Step-1-only load-cell calibration script
    New folder "Matlab calibration" with step1_loadcell_calibration.m: a
    trimmed, self-contained copy of matlab/a1_fit_lc_ur_calibration.m that
    runs ONLY Step 1 (load-cell voltage <-> force), written to be read by a
    human operator rather than to mirror the Python script.
    Key difference from a1: it shows a table of exactly which recordings it
    found (batch selected by one DATASET_VERSION setting at the top, 'v2'
    today) and STOPS for a y/n confirmation before fitting anything -- the
    requested "confirm which datasets will be used before proceeding with
    the rest of the linearization". The confirmed file list is saved into
    the output JSON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
2026-07-16 Replace regexp filename parsing with string splitting (MATLAB-proof)
    step1_loadcell_calibration still found zero recordings on real MATLAB
    after the previous fix. Root cause, pinned down by the user's two error
    reports: MATLAB's own regexp engine (not PCRE) never lets a named token
    inside an optional group participate in a match -- so with
    (?:(?<version>v\d+)_)? in the pattern, un-tagged v1 files matched (the
    group is skipped) but every v2-tagged file silently failed to match.
    The step1 script then filtered out the v1 matches (version ~= 'v2') and
    ended up empty; a1_fit_lc_ur_calibration.m had the same latent bug and
    was silently fitting on v1-only data whenever run in MATLAB. PCRE-based
    eng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
2026-07-20 Allow arbitrary point count in two-point iterations collector
    Replaces fixed --point1/--point2 args and prompts with a --points
    list / interactive count-then-loop so a run can cover N points
    instead of exactly two.
    [capacitance_two_point_iterations_collector.py]
2026-07-21 Add Step 2 operator script: UR fz vs load-cell-derived force over time
    Reuses step1_loadcell_calibration.json's fit and confirmed file list to
    plot, per recording and restricted to the loaded (measurement) window
    only: the known expected force, the force computed from ai0 through
    Step 1's calibration, and the UR robot's own fz reading (sign-corrected
    to the same push/pull convention). Saves one PNG per recording to
    step2_plots/ and prints a bias summary table.
2026-07-21 step2: add F_expected_ur and a 22-panel overview grid
    The UR wrist and the load cell see different hardware mass above/below
    them in this rig (holder/hook only vs. holder/hook + coupler + screws +
    load cell body), so they have different expected forces for the same
    placed weight. Adds F_expected_ur as its own reference line, alongside
    the existing F_expected, on every plot.
    Also adds a single 2x11 panel figure with all 22 confirmed recordings,
    posz on top and negz on bottom, ordered lightest to heaviest (10g to
    1156g), sharing one set of axes and one legend, saved as
    step2_panel_overview.png/.fig/.svg next to the script.
2026-07-21 calibrate intermediate points
    [two_point_iterations_P05_P12_20260720_999999.csv, two_point_iterations_P08_20260720_141030.csv, two_point_iterations_P08_P19_20260720_133001.csv, two_point_iterations_P19_20260720_140307.csv]
2026-07-21 Add 20 July calibration point files for Integration_2
2026-07-23 Add Interdome_touch: combined robot + capacitive sensor + FUTEK collector
    New long-hold pressing session that reads its 19 points from
    Integration_2/calib_points_supposed_rigid_transformed.json, lets the user
    pick a TCP calibration from Integration_2/calib_*.json, and reuses the
    5-phase (locate/press/hold/retract/post) push schema from
    capacitance_dataset_collector_long_hold.py across 5 depths x N iterations.
    FUTEK force uses the direct AI0->N fit from
    force_sensor_calibration/Matlab calibration/step1_loadcell_calibration.json
    (confirmed with the user over the fz-correction alternative). Includes an
    analysis script that reconstructs the trajectory and renders the hexagonal
    sensor schematic c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
2026-07-27 data fro full sensor, 162417
    [interdome_20260723_125114.csv, interdome_20260723_133729.csv, interdome_20260723_182429.csv, interdome_20260723_182738.csv, interdome_20260723_183845.csv, interdome_20260723_184058.csv, interdome_20260723_184529.csv, interdome_20260723_185427.csv]
2026-07-30 three points iterations
    [two_point_iterations_P10_P03_P14_20260730_144928.csv, two_point_iterations_P10_P03_P14_20260730_145148.csv, two_point_iterations_P10_P03_P14_20260730_145628.csv, two_point_iterations_P10_P03_P14_20260730_145850.csv, two_point_iterations_P10_P03_P14_20260730_150111.csv, two_point_iterations_P10_P03_P14_20260730_150442.csv, two_point_iterations_P10_P03_P14_20260730_150704.csv, two_point_iterations_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]
2026-08-02 Remove duplicate lowercase integration_2/ index entries
    [Setup_testing_session_20260528_162530.csv, ai0_test_session_20260528_150039.csv, dome_empty_burcu_session_20260507_170024.csv, dome_empty_may_28_9mm_session_20260528_225530.csv, dome_empty_may_28_session_20260528_225103.csv, dome_empty_monday_28_session_20260528_223656.csv, dome_empty_monday_2_session_20260511_134351.csv, dome_empty_sensitivity_16_gamma_08_session_20260506_170404.csv]
2026-08-02 jonathan review
    [two_point_iterations_P10_P03_P14_20260730_144928.csv, two_point_iterations_P10_P03_P14_20260730_145148.csv, two_point_iterations_P10_P03_P14_20260730_145628.csv, two_point_iterations_P10_P03_P14_20260730_145850.csv, two_point_iterations_P10_P03_P14_20260730_150111.csv, two_point_iterations_P10_P03_P14_20260730_150442.csv, two_point_iterations_P10_P03_P14_20260730_150704.csv, two_point_iterations_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]
2026-08-02 Update two-point iteration log CSVs
    [two_point_iterations_P10_P03_P14_20260730_144928.csv, two_point_iterations_P10_P03_P14_20260730_145148.csv]
2026-08-02 Update two-point iteration log CSVs (latest snapshot)
    [two_point_iterations_P10_P03_P14_20260730_144928.csv, two_point_iterations_P10_P03_P14_20260730_145148.csv]
2026-08-02 Fix conflict markers accidentally committed from interrupted merge attempts
    The two-point-iteration CSV files had duplicate content wrapped in git
    conflict markers (<<<<<<< / ======= / >>>>>>>) from prior failed pull
    attempts. Verified local and remote copies were byte-identical, so
    markers were stripped keeping a single clean copy of the data.
    [interdome_20260723_125114.csv, interdome_20260723_133729.csv, interdome_20260723_182429.csv, interdome_20260723_182738.csv, interdome_20260723_183845.csv, interdome_20260723_184058.csv, interdome_20260723_184529.csv, interdome_20260723_185427.csv]
2026-08-05 add new points
    [two_point_iterations_P01_P03_20260805_190709.csv, two_point_iterations_P01_P03_20260805_190930.csv, two_point_iterations_P01_P03_20260805_191240.csv, two_point_iterations_P01_P03_20260805_191501.csv, two_point_iterations_P01_P03_20260805_191722.csv, two_point_iterations_P01_P03_20260805_191724.csv, two_point_iterations_P10_20260805_183242.csv, two_point_iterations_P10_20260805_183503.csv]
2026-08-07 Interdome_touch: stream dataset to disk to fix OOM on long runs
    main.py previously buffered every logged row in RAM for the whole
    session and rewrote the entire CSV on each autosave, exhausting memory
    on long collections (e.g. 30x85x6) and getting the process OOM-killed
    mid-run. Rewrote logging to stream rows straight to the CSV via a
    module-level DictWriter (open/flush/close_dataset), fsyncing every 500
    rows, so memory stays flat and a crash loses at most the last unflushed
    rows. Added a 10-consecutive-error breaker to avoid infinite spinning on
    a dropped robot connection. Also adds new_hollow_dome calibration/points
    files and recent run logs.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
    [interdome_20260805_221131.csv, interdome_20260805_222309.csv, interdome_20260807_190656.csv]
2026-08-07 Interdome_touch: add 152202 run log via LFS
    Adds the 212MB interdome_20260807_152202.csv collection log, stored
    through Git LFS (Interdome_touch/logs/*.csv is already LFS-tracked).
    [interdome_20260807_152202.csv]
2026-08-12 datadcollection for flat and solid 5mm depth
    [short_flat_five_mm_session_20260812_191646.csv, solid_five_mm_session_20260812_190724.csv]
2026-08-13 Interdome_touch: MATLAB/Octave analysis port with sample counts, variance/median charts, and ML-approach notes
    Ports analyze_interdome.py to MATLAB/Octave (matlab_analysis/), reproducing
    the trajectory/hex-schematic/sample-count outputs via textscan (no
    readtable/io-package dependency) and fixing 'P01'-style point labels so the
    hex schematics actually populate for this dataset. Adds per-depth/type/label
    sample-count breakdowns (press/hold/retract) and per-point variance+median
    bar charts for main points plus diagonal/triangle/horizontal interpolated
    points, all exported as PNG+SVG. Also adds the matching sample-count feature
    and a point-label fix to the Python script, and notes on ML approac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
2026-08-13 Add new solid initial-pose config and interdome touch logs
    [interdome_20260806_170312.csv, interdome_20260807_121756.csv]
2026-08-13 Update short new solid calib data and interdome touch log
    [interdome_20260807_190656.csv]
2026-08-14 new test
    [hollow_dome_5iter_session_20260813_185140.csv]
2026-08-15 Add mucaboard capacitance-estimation toolkit and analysis outputs
    Adds the MATLAB/Octave analysis scripts for mucaboard force/hex-map
    plotting and LCR-vs-mucaboard capacitance estimation (analyze_mucaboard.m,
    estimate_capacitance.m, and helpers), their generated figures, and a
    README documenting the raw-to-normalized-reading formula, the per-surface
    and per-point pF regression coefficients, and how each hex-map cell
    (delta-C pF, delta-C/C0, delta-V/V0) is calculated.
2026-08-15 Add second hollow LCR calibration file, extending hollow point coverage 3->5
    two_point_iterations_P08_P19_20260720_122906_hollow.csv (points 8/19) was
    sitting unused alongside the existing P10/P03/P14 hollow file; its Cp_pF
    values are realistic and noisy like the rest of the LCR dataset, and its
    surface label is confirmed in analyze_two_point_p08_p19.py. Combining both
    brings hollow LCR-based coverage from 3 to 5 of 19 points and updates the
    hollow pooled/per-point fit coefficients accordingly (README updated to
    match). A third candidate file (P05_P12, timestamp 999999) was found and
    excluded -- its Cp_pF is a suspiciously exact, near-noiseless +2.0 pF/mm
    ramp, indicating synthetic/test data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
2026-08-19 Add mucaboard V0/Press/deltaV toolkit for custom per-indented-point calculations
    Reusable data-extraction (muca_extract_point_segments.m, muca_load_three_surfaces.m)
    and plotting (muca_plot_hex_comparison.m) building blocks, plus a template script
    (example_own_v0_hold_calculations.m) computing V0 (release) and Press (hold) per
    indented point from raw locate/hold-phase samples, kept separate per point to avoid
    cross-talk dilution, with min-max range tables, a shared color scale across metrics,
    and a partial reverse-calculation back through the sensor's gamma/sensitivity
    normalization. Also corrects the V0 definition in analyze_muca_v0_variation.m and
    analyze_muca_v0_hold_allpoints.m to use th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
2026-08-19 Add pressure monitor/sequencer tools, tweak basic_control timing
    - Fluigent_control/pressure_monitor.py + .c: live serial plot of the
    ESP32-C6 + Honeywell pressure sensor (Python/matplotlib and a C/SDL2
    variant).
    - Fluigent_control/sequence_control.py: timed pressure + P-Switch valve
    sequencer for Flow EZ / P-Switch modules.
    - basic_control.py: shorten ON_TIME 0.1s -> 0.05s; remove the stray
    duplicate copy that had ended up under .claude/Fluigent_control/.
    [basic_control.py, pressure_monitor.c, pressure_monitor.py, sequence_control.py]
2026-08-25 Add new mucaboard raw data log files from testing
    [19_points_data_collection_session_20260825_110957.csv, 19_points_flat_sensor_5_iterations_session_20260825_113614.csv, 19_points_hollow_sensor_5_itertations_session_20260825_111045.csv, 19_points_solid_sensor_5_iterations_session_20260825_125908.csv]
2026-08-25 Add central-point (P10) raw+calibration analysis and show_labels toggle
    New "raw data central point" dataset (P10, 10 iterations, 3 surfaces) is
    the first in this project to log a real per-cell calibration baseline
    (calib_1..19) alongside raw touch-controller counts, instead of the
    already-normalized [0,1] reading every other dataset here provides.
    - read_muca_csv_central.m: reader for this dataset's different (59-col)
    CSV layout.
    - analyze_central_point_raw.m: full raw/calibration/self-normalized
    analysis reusing the existing muca_extract_point_segments.m /
    muca_plot_hex_comparison.m toolkit.
    - simple_central_point_analysis.m: a from-scratch, heavily-commented
    beginner walkthrough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
    [10_iterations_5mm_flat_session_20260819_173407.csv, 10_iterations_5mm_hollow_dome_session_20260819_165646.csv, 10_iterations_5mm_solid_session_20260819_171044.csv]
2026-08-26 Add flat/hollow/solid 19-point 10-iteration muca raw data sessions
    [flat_sensor_19_points_10_iterations_session_20260826_155255.csv, hollow_sensor_19_points_10_iterations_session_20260826_134101.csv, solid_sensor_19_points_10_iterations_session_20260826_165651.csv]
2026-08-26 Add 19-point mucaboard_data_raw analysis toolkit; box-frame hex panels; commit finalized central-point outputs
    Analyzes all 19 points (not just center) across flat/solid/hollow surfaces,
    with corrected point-to-sensor-cell mapping and true board labeling derived
    from the physical board layout (robot's internal point numbering didn't
    match the board's own silkscreen numbering or cell wiring).
    [central_point_raw_and_normalized.csv]
2026-08-26 Sync mucaboard_data_raw data/scripts from testing (additive)
    [10_iterations_5mm_flat_session_20260819_173407.csv, 10_iterations_5mm_hollow_dome_session_20260819_165646.csv, 10_iterations_5mm_solid_session_20260819_171044.csv, try2_hollow_session_20260819_165204.csv]
2026-08-26 Add QA check script; re-run 19-point analysis against new 10-iteration dataset
    qa_check_dataset.m checks row integrity, impossible values, calib
    homogeneity, non-contact drift, and own-cell localization -- catches the
    hardware fault classes found in earlier sessions before trusting a new one.
    Ran it against the new 10-iteration flat/solid/hollow logs: flat passed
    clean, solid flagged 6 weakly-localized points (likely material coupling,
    not a fault), hollow found cells/points 2/6/11/16 (raw cells 4-7) 100%
    corrupted (16-bit overflow) from the first row -- unrecoverable, needs
    re-collection. Regenerated all 19 points' plots against the new data with
    N_ITERATIONS=10; the affected hollow points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
2026-08-26 Add mucaboard raw hollow-sensor all-iterations session log
    Brings mucaboard_data_raw/logs up to date with the testing branch.
    [hollow_sensor_iterations_all_session_20260826_190632.csv]
2026-08-26 Add capacitance_combination_calibration folder (collector, plots, session logs)
    Claude-Session: https://claude.ai/code/session_01NYhiSvBdZUwVaiuUjgg9zz
    [cap_test_session_20260826_212041.csv, flat_calibration_muca_lcr_session_20260826_225636.csv, flat_sensor_calibration_muca_lcr_session_20260826_225435.csv, test2_session_20260826_212607.csv, testing_cap_v1_session_20260826_220641.csv]
2026-08-26 Swap in re-collected hollow dataset, regenerate all 19 points
    hollow_sensor_iterations_all_session_20260826_190632.csv replaces the
    prior hollow session that had cells 4-7 (points 2/6/11/16) 100% dead
    from a 16-bit overflow. Verified clean via qa_check_dataset.m (all 5
    checks pass) before regenerating -- no more grey/NaN cells, and the
    shared color scales tightened up now that the corrupted outlier is gone.
2026-08-28 Add two_point_iterations ALL19 datasets (solid/hollow/flat sensors) via LFS
    [two_point_iterations_ALL19_20260825_202746_hollow_sensor.csv, two_point_iterations_ALL19_20260828_162718_solid_sensor.csv, two_point_iterations_ALL19_20260828_193051_flat_sensor.csv]
2026-08-31 Add Muca/LCR/Futek capacitance calibration pipeline
    Triangulates real capacitance (pF) for mucaboard_data_raw by combining
    three datasets that never share all signals at once:
    - capacitance_combination_calibration/ (known Cp -> muca raw, no robot)
    - Capacitance_measurement/ (robot + LCR + Futek, no muca)
    - mucaboard_data_raw/ (robot + muca + Futek, no LCR)
    STEP 0 checks position coherence between the two robot-based datasets
    using only locate-phase (zero-indentation) rows -- finds a real ~11mm
    mean / 17mm max TCP discrepancy even though both collectors command
    identical POINTS/REFERENCE_POSE, most likely from robot/frame
    re-registration between sessions (Jun/Jul vs Aug). Flagged as a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
    [mucaboard_data_raw_in_pF.csv]
2026-08-31 Add per-point/per-surface Force<->Cp_pF<->muca-V relationship table
    Refactored calibrate_capacitance_muca_lcr_futek.m's shared helpers into
    their own files (read_muca_raw_csv.m, muca_raw_own_reading_by_point.m,
    combo_active_cell_fit.m, interp_force_to_cp.m) so this new script can
    reuse them without duplication.
    per_point_surface_relationships.m answers "what's the actual equation
    per cell per surface" for all three pairwise signals:
    - Force<->Cp_pF: a REAL per-point linear regression (Capacitance_measurement's
    own multi-depth sweep per point) -- R2 mostly 0.5-0.99, well-determined.
    - Force<->muca_V: only one sample per point in mucaboard_data_raw (single
    depth), so no slope is f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
    [per_point_surface_relationships.csv]
2026-08-31 Test generalizing hollow's LCR Force<->Cp relationship to all surfaces
    Pooling hollow's 5 points into one raw-Cp_pF line fails outright (R2=0.000
    even in-sample) -- different pads have too different absolute baselines.
    Normalizing by each point's own C0 (delta-C/C0) fixes that within hollow
    (R2=0.866 pooled), but cross-validated against flat/solid's own real LCR
    points it still fails (R2=-1.19 / -1.42) -- force-to-capacitance coupling
    is genuinely surface-dependent, not just baseline-offset. Documented
    honestly rather than silently applying a model that doesn't transfer.
    [mucaboard_data_raw_in_pF_generalized_hollow_model.csv]
2026-08-31 Test hollow's muca_V<->Cp_pF (not Force<->Cp_pF) as a generalizable model
    Hypothesis: since the muca chip's own raw-to-capacitance transfer function
    should be fixed hardware, muca_V<->Cp_pF (unlike Force<->Cp_pF, already
    shown surface-dependent) might generalize across surfaces.
    Cross-validated hollow's 5-point V<->Cp_pF fit against flat's and solid's
    own matched points: R2=-1.14 (flat), R2=-15.78 (solid) -- both far worse
    than each surface's own weak same-surface fit. Solid's RMSE (0.53pF)
    exceeds its entire real Cp range (0.48pF). Conclusion: V<->Cp_pF is ALSO
    surface-dependent (different surfaces still change the electric-field
    geometry at the electrode, not just the mechanical force cou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
2026-08-31 Add per-point (not pooled) Force<->Cp_pF calibration -- the real answer
    Both generalization attempts (Force and muca_V, pooled across all 19
    points, borrowed from hollow) failed cross-validation. The actual fix
    isn't a different pooled model -- it's not pooling at all. Force is
    still the right variable (per-point Force<->Cp_pF regressions already
    had R2 0.5-0.99 in per_point_surface_relationships.csv), the mistake was
    pooling all points into one line per surface, which repeats the same
    baseline-mismatch failure mode.
    mucaboard_data_raw logs Futek force continuously per-sample with known
    point identity, so this applies EACH point's OWN Force<->Cp_pF fit to
    EVERY sample of that point (not jus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
    [mucaboard_data_raw_in_pF_per_point_force.csv]
2026-08-31 Swap in full 19-point LCR sweeps (ALL19 files), regenerate everything
    Replaces the old partial LCR coverage (flat/solid: 5 ramp_collector files
    each; hollow: only 5/19 points via two_point_iterations_P10_P03_P14 +
    P08_P19) with the new two_point_iterations_ALL19_*_sensor.csv files --
    full 19-point sweeps at depths 5-10mm for all three surfaces, so
    mucaboard_data_raw's actual press depth (10mm) is covered directly (no
    depth-offset hack needed).
    Effects, confirmed by re-running every script:
    - STEP 0 position coherence: discrepancy dropped from ~11mm mean/17mm
    max down to 1.65mm/2.36mm -- these new files were collected close in
    time to mucaboard_data_raw (Aug 25/28 vs Aug 26), unlik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
    [mucaboard_data_raw_in_pF.csv, mucaboard_data_raw_in_pF_generalized_hollow_model.csv, mucaboard_data_raw_in_pF_per_point_force.csv, per_point_surface_relationships.csv]
2026-08-31 Add chained muca_V -> Force -> Cp_pF calibration (per-point, both links real)
    Direct answer to "can this be extrapolated to muca value instead of
    force?": mucaboard_data_raw only presses each point at ONE fixed depth,
    so a per-point Force<->V slope was never fittable from the hold-phase
    mean alone -- but the press/retract phases are the robot continuously
    ramping 0->10mm, during which force and muca_V both sweep through a wide
    range for the SAME point (~2000 samples per point, force spanning
    ~2.6-20N). That's enough to fit a genuine per-point Force<->V regression
    from mucaboard_data_raw's own data (mean R2 0.78 flat, 0.57 solid, 0.82
    hollow), which chains with the existing per-point Force<->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
    [chained_muca_v_to_cp_via_force.csv, mucaboard_data_raw_in_pF_chained_via_V.csv]
2026-08-31 Add direct muca_V <-> Cp_pF table, per point per surface
    Composes the single equation Cp_pF = A*V + B directly from
    chained_muca_v_to_cp_via_force.m's two linked fits (algebraically
    substituting Force out), so the answer to "what's the muca-reading-to-
    capacitance relationship per point" is one row per point per surface,
    not two fits to combine manually. R2 reported is the MINIMUM of the two
    chained fits (a chain is only as strong as its weakest link) -- the
    honest quality figure for the composed equation.
    Output: results/muca_v_to_cp_table.{csv,md}, 57 rows (19 points x 3
    surfaces).
    [muca_v_to_cp_table.csv]
2026-08-31 Add capacitance-based hex-map analysis to mucaboard_data_raw, all 19 points
    capacitance_19points_analysis.m mirrors simple_19points_analysis.m's
    exact data loading, board-label correction, and per-iteration-mean-then-
    median statistics, but converts the final V_own readings to real
    capacitance (pF) using Capacitance_calibration_Muca_LCR_Futek/results/
    muca_v_to_cp_table.csv's per-cell, per-surface Cp_pF = A*V + B equations.
    4 plots instead of 5 -- Cp is a direct linear function of V here (not a
    separately normalized quantity the way V is a gamma-transform of raw
    counts), so there's no capacitance analogue of the "raw counts" step:
    1. capacitance_baseline_hexmap -- Cp at V=0 (that cell's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
2026-08-31 Fix crushed/shifting colors in capacitance baseline+press hex maps
    Baseline_pF (the B intercepts) never changes with which point is
    pressed, but the two plots shared one color scale computed from
    [Baseline; Press] combined. Since Press_pF DOES shift slightly per
    point, the shared scale's min/max shifted too -- so Baseline's rendered
    colors changed by a rounding sliver from one point-folder to the next
    even though the underlying values never did (confusing: looked like a
    bug, not the true no-change reality). Worse, Baseline's huge ~2pF
    cell-to-cell spread (real electrode-to-electrode hardware variation)
    swamped Press's much smaller ~0.15-0.2pF touch-induced signal, crushing
    it into a barely-v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
2026-08-31 Extend STEP 0 position check to all 3 surfaces; fix false-alarm threshold
    STEP 0 previously only validated flat's muca session against flat's LCR
    sweep -- solid and hollow were never actually checked, even though each
    surface's muca/LCR pair was collected on different days. Extended to
    loop over all 3 surfaces independently.
    Result: flat 2.36mm max, solid 2.78mm max, hollow 3.21mm max (all mean
    ~1.65-1.68mm) -- all real and all safe. Verified the board's TRUE
    minimum point-to-point spacing directly from the POINTS dict (every
    pairwise distance computed): a clean 8.00mm, not the "4-8mm" estimate
    used before. Replaced the old, unjustified 3.0mm safety threshold with
    half that verified spacing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
2026-09-01 Replace capacitance conversion with direct combination-calibration gain
    The previous method chained two fits through Futek force and composed
    them by evaluating at V=0 and V=1. Verified that this was invalid:
    - V=0 mapped to a NEGATIVE force (median -4N) for 44/57 cells, and
    V=1 to 26-67N, while the LCR sweep only measured 2.6-20N -- both
    anchors were pure extrapolation, which is why the derived baselines
    scattered from 0.05 to 2.03 pF and the maps looked saturated.
    - 3 cells came out sign-flipped (Force<->V fits with R2 as low as 0.16).
    - Forcing the Force<->V fit through the origin (physically required)
    drove R2 NEGATIVE (-0.35, -1.28), confirming V-vs-force is genuin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
2026-09-01 Invert colormap for capacitance plots only
    A press LOWERS capacitance (dCp is negative), so on the project's
    standard green->red ramp the contact point -- the most negative cell --
    came out green while untouched cells were red, which reads backwards.
    Flipped the ramp in capacitance_19points_analysis.m so the most negative
    (strongest contact) end is red. Values and the colorbar axis are
    unchanged; only the color-to-value direction is reversed, so the colorbar
    now runs red (most negative) -> green (least negative), matching what the
    numbers say.
    Done locally via flipud(get_cmap()) inside this script's own plotting
    helper -- get_cmap() itself is untouched, so simple_19points_analysis.m
    and ev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
2026-09-01 Plot capacitance DROP (-dCp) and restore the standard colormap
    Replaces the previous colormap flip with a data-level fix, as suggested.
    A press lowers capacitance, so dCp is negative and the contact point
    landed at the green end. Rather than inverting the colormap, the plotted
    quantity is now the capacitance DROP (-dCp): positive where contact
    reduced Cp, larger at stronger contact. That puts the contact point at
    the high/red end on the project's standard colormap, so get_cmap() is
    used unmodified here again -- same orientation as every other plot.
    Negation is used rather than abs(): a few cells read slightly BELOW
    their own baseline during a neighboring press -- up to +0.0087 pF, about
    21%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
2026-09-01 Add gain justification/validation figure -- and it fails validation
    Four-panel figure testing whether the muca-count -> capacitance gain is
    defensible to apply to touch data. Answer, from the data: not as a
    quantitative conversion.
    A The calibration itself is genuinely good: Cp = -0.001734*raw + 0.389,
    R2 = 0.9903, n = 30, tight clusters across 5 different muca inputs per
    capacitor -- the gain is well determined WHERE IT WAS MEASURED.
    B But it was measured at raw readings of -1305..-337 counts, while real
    touch deltas span -3.5..+23.6 counts. The ranges do not overlap at
    all: applying it to touch is an extrapolation of 1-2 orders of
    magnitude, and of opposite sign.
    C Aga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
2026-09-01 Add local-baseline capacitance maps; add global-scale option; all 19 points
    LOCAL BASELINE (new figure, alongside the existing calib-based one)
    The calib-based route subtracts calib_*, a single snapshot taken once at
    session start. That snapshot is genuinely constant through the file, but
    the untouched level is not: measured on the flat file, the locate/post
    level drifts by up to 2.86 counts across a session and sits 0.5-3 counts
    off calib_* even at the start. Against own-cell press deltas of 5.1-23.6
    counts that is ~12% error on the strongest points and up to ~57% on the
    weakest -- systematic, not noise.
    capacitance_delta_localbase_hexmap instead uses each point-and-round's
    OWN untouched r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
2026-09-07 Add raw muca-board dataset: solid sensor, 10 iterations, 5 points (2026-09-07 session)
    [solid_sensor_10_iteration_5_points_session_20260907_163726.csv]
2026-09-07 Add raw muca-board dataset: solid sensor, 10 iterations, 5 points (2026-09-07 17:47 session)
    [solid_sensor_10_iterations_5_points_session_20260907_174707.csv]
2026-09-10 Add FT5316 analog-gain calibration study (register 0x07)
    The muca board's scale has never changed between sessions because the
    upstream Muca_Raw.ino leaves the FT5316's analog gain at its power-on
    default -- its `muca.setGain(100)` line is commented out. The gain is
    adjustable; we simply never touched it.
    Re-analysing the 2026-08-26 LCR+muca session shows why that matters:
    554 counts/pF (R^2 = 0.996) but only 1.3% of the 16-bit range in use,
    an extrapolated Cp=0 intercept of 65,726 against a ceiling of 65,535,
    and a negative slope -- all signatures of an AFE driven past its linear
    range, with capacitors that sit inside the datasheet's optimal 1-4 pF
    window.
    New folder capacitance_combinati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
    [gain_per_point.csv, gain_summary.csv]
2026-09-10 Fix link error in Muca_Raw_gain.ino: getFWVersion() is never defined
    Muca.h declares `int getFWVersion();` but Muca.cpp never implements it, so
    the sketch compiled and then failed at link time with:
    undefined reference to `Muca::getFWVersion()'
    Read the firmware-ID register directly via getRegister(0xA6) instead, which
    is defined. setNumTouchPoints() and setResolution() are declared-but-undefined
    upstream too; none of them are used here now.
    selftest_dataset_format.py gains check [5]: it extracts every muca.<method>(
    call from the sketch and verifies it against the functions the INSTALLED
    Muca.cpp actually defines (falling back to the verified upstream list when the
    library isn't on t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
    [Muca_Raw_gain.ino, selftest_dataset_format.py]
2026-09-17 Bring Interdome_touch/main.py and new log sessions from testing
    Copies the updated main.py and 4 log sessions (20260822, 20260823,
    20260825, 20260826) recorded on the testing branch into main, keeping
    main's own existing Interdome_touch logs.
    [interdome_20260823_184513.csv, interdome_20260825_204044.csv, interdome_20260826_200750.csv]
2026-09-19 Add Interdome_touch logs (weekend auto-push 2026-09-19 21:00:01)
    [interdome_20260918_193743.csv]
2026-09-30 Add linear_displacement_test folder to main
    Point-to-point + bidirectional slide collectors and datasets, brought over
    from testing.
    [hollow_dome_5_iterations_b3_session_20260918_181142.csv, hollow_dome_5_iterations_c3_bidirectional_allpoints_session_20260930_160646.csv, hollow_dome_5_iterations_c3_long_displacement_session_20260918_163853.csv, hollow_dome_5_iterations_c3_session_20260918_162945.csv, test2_session_20260918_155459.csv, test3_session_20260918_155552.csv, test4_session_20260918_155653.csv, test5_session_20260918_1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]
2026-09-30 Add linear-slide analysis: b3 session and bidirectional round trips
    - b3 session (tag b3_near) added to the one-way plot scripts, with an
    ONLY_SESSIONS filter; it is plotted with a caveat -- the robot landed
    ~3 mm off the b3 pad toward b4 (see logs/NOTES.md).
    - New bidirectional pipeline for bidirectional_displacement.py logs:
    bidir_slide_timeline.m (segment-level locate baseline, time-based
    since progress restarts on the return) plus response, hexmap-strip
    and round-trip animation scripts under results/bidirectional/.
    - make_slide_videos.sh: -o c3|b3|c3_bidir picks the clockwise
    compilation order.
    - Results: response plots, strips and mp4s; per-frame PNGs are
    gitignored (regen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
2026-09-30 Sync linear_displacement_test from testing (trajectory collector + sessions)
    [hollow_dome_5_iterations_external_diameter_session_20260930_191043.csv, hollow_dome_5_iterations_internal_diameter_session_20260930_193505.csv]
2026-09-30 Add trajectory (ring) analysis; restore analysis docs
    - traj_timeline.m: loader for trajectory_displacement.py logs --
    session locate baseline, every slide/hold piecewise-aligned across
    passes, per-hold hottest-cell record.
    - plot_traj_response.m: cells x time heatmap with the tip path, ring
    traces, and per-pad tracking (hottest cell = pad under the tip):
    external ring 83% of holds, internal ring 88%.
    - plot_traj_hexmap.m: honeycomb at every hold (out/back strip) and a
    whole-pass animation (+ mp4s).
    - README analysis section and NOTES.md entries (b3 diagnosis,
    bidirectional notes) restored -- the sync from testing had dropped
    them -- plus notes for the two ring sessions.
    Co-Au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
    [ring_external_tracking.csv, ring_internal_tracking.csv]
2026-10-15 Add Robotiq 2F-85 gripper control (driver + slider GUI)
